obiwanjacobi/Zalt/Design/Images/Zalt CPU Board.jpg

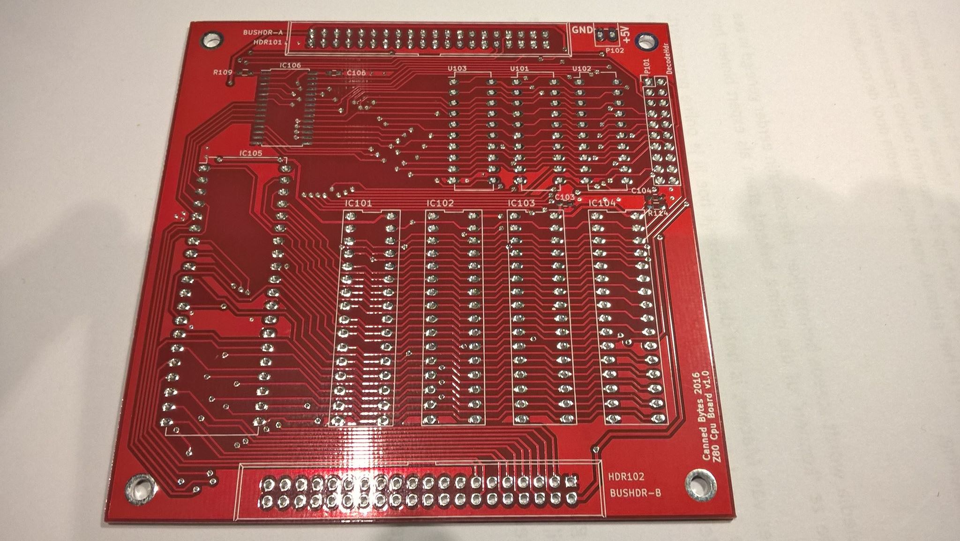
Design/Images/Zalt CPU Board.jpg
