obiwanjacobi/Zalt/Design/Images/building up.jpg

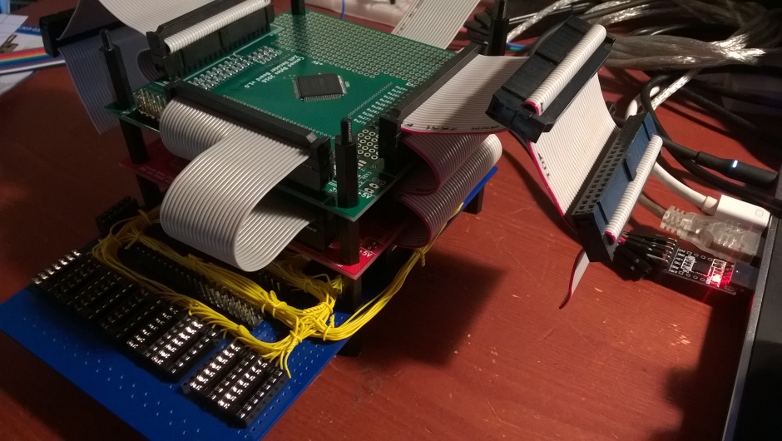
Design/Images/building up.jpg
