obiwanjacobi/Zalt/Source/CharacterVga/readme.md

# Character VGA

Based on a tutorial by 'MiguelVP'
http://www.eevblog.com/forum/projects/no-bitbanging-necessary-or-how-to-drive-a-vga-monitor-on-a-psoc-5lp-programmabl/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

This PSoC project attemps to create a 80x30 character VGA output device.
