obiwanjacobi/Zalt/Design/Additional Documents.md

# Additional Documentation

## My Blog

https://jacobielectronix.wordpress.com/category/zalt

## EEVBlog Forum Posts

Early Memory Layout Design ideas

http://www.eevblog.com/forum/microcontrollers/retro-z80-project-memory-layout-and-software-management/msg819707/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

Early Stream Design ideas

http://www.eevblog.com/forum/microcontrollers/software-ideas-for-fast-streaming-of-disk-data-in-retro-z80-design/msg931695/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

Zalt goes Open Source

http://www.eevblog.com/forum/projects/zalt-an-alternative-z80-homebrew-computer/msg1046143/#msg1046143

GPU Design

http://www.eevblog.com/forum/microcontrollers/early-design-review-mcu-with-quad-spi-and-external-memory-interface/msg1124763/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

PCB Layout posts

http://www.eevblog.com/forum/eda/painted-myself-into-a-corner-any-tips/msg901849/#msg901849

http://www.eevblog.com/forum/kicad/multi-board-project/msg900472/#msg900472

http://www.eevblog.com/forum/eda/favour-more-vias-or-longer-traces-on-other-side/msg890090/#msg890090

## Zalt Memory Management

(different than the .doc file)

https://docs.google.com/document/d/1tF7p2I6861tk6l0KzyiMkYkhx_dNrJLCjcLoVhHxSHA/edit?usp=sharing
