obiwanjacobi/Zalt/Design/BusSpy.docx

Printout for display digits:

A0-3 | A4-7 | A8-11 | | A12-15 | | M12-15 | M16-19 | | D0-3 | D4-7
RST HALT | MEMRQ IORQ | RD WR | | M1 WAIT | | BUSRQ BUSACK

Power Supply

+ => 5V

- => GND

SysTerminal (UART)

Tx => 12.5 PSoC

Rx => 12.4 PSoC

(Dev) USB on PSoC used to program and debug PSoC itself.

Debug Modes (flags)

1 => MEM-RD

2 => MEM-WR

3 => INSTRUCTION-RD (M1)

4 => INPUT

5 => OUTPUT

6 => INTERRUPT-ACKNOWLEDGE

Header A (Memory)

1. GND | 2. +5V
3. A0 | 4. A1
5. A2 | 6. A3
7. A4 | 8. A5
9. A6 | 10. A7
11. A8 | 12. A9
13. A10 | 14. A11
15. MA12 | 16. MA13
17. MA14 | 18. MA15
19. MA16 | 20. MA17
21. MA18 | 22. MA19
23. D0 | 24. D1
25. D2 | 26. D3
27. D4 | 28. D5
29. D6 | 30. D7
31. !MEMREQ | 32. !WR
33. !RD | 34. !CPU_WAIT

Header B (IO)

1. GND | 2. +5V
3. !BUSRQ | 4. !BUSACK
5. !CPU_HALT | 6. !CPU_WAIT
7. !CPU_M1 | 8. !REFRESH
9. !MEMREQ | 10. !IOREQ
11. !RD | 12. !WR
13. !CPU_INT | 14. !NMI
15. A12 | 16. A13
17. A14 | 18. A15
19. !CPU_RST | 20. !CPU_CLK

PSoC

RST

+ -

123456

- Tx Rx

-+

HDR B

HDR A

HDR A

HDR B
