obiwanjacobi/Zalt/Design/Diagrams.pptx

IO addresses: A0-A15
Mem addresses: A0-A11 MA-12-MA19 (1MB)

Z80

MA12-MA19

CPU

A0-A15

D0-D7

A12-A15

MMU

IO-ctrl

EPM240

Logic

Bus-ctrl

Enable

RAM

Serial

PSoC5

Sys
Ctrl

A0-A15
MA12-MA19

D0-D7

A0-A15

A0-A11
MA12-MA19

## Slide 2

Network

IO
Device

IO
Ctrl

Dual ported

IO
RAM

Storage

IO
Device

CPU

RAM mapped
into CPU space

Server

Any
Device

## Slide 3

PC

Zalt

USB

Virtual
Device

Virtual
Device

CPU

PSoC

Int / IO

## Slide 4
