obiwanjacobi/Zalt/VDP Board v1.0 - locked/Source/readme.md

# VDP Board 1.0

https://www.msx.org/wiki/Category:Yamaha_V9958

http://primrosebank.net/computers/mtx/techlib/design/V9958-Technical-manual_v1.0.pdf

http://map.grauw.nl/resources/video/yamaha_v9958.pdf
http://map.grauw.nl/articles/vdp_tut.php

## V9958 code

https://github.com/Xeraster/z80computer/blob/master/9958driver.asm
https://github.com/vipoo/yellow-msx-series-for-rc2014/blob/main/apps-rc2014/v9958.asm

## Trouble Shooting

http://rs.gr8bit.ru/Documentation/Issues-on-YJK-colour-model-implemented-in-Yamaha-V9958-VDP-chip.pdf

> You could take the CXA temporarily out of the equation and just use the RGB signals from the VDP directly.
If you don't have an RGB monitor capable of accepting 15kHz video, you can use each component separately as if it were composite video.

## Resources

https://www.msx.org/forum/msx-talk/hardware/v9958-color-bus?page=0
