obiwanjacobi/Zalt/Source/CPM/Version2/readme.md

# CP/M v2.2

- MyCpm22.z80
- MyCpm22-bios.z80
- MyCpm22-bdos.z80
- MyCpm22-ccp.z80

## Resources

https://obsolescence.wixsite.com/obsolescence/cpm-internals
http://cpuville.com/Code/CPM-on-a-new-computer.html

http://www.cpm.z80.de/
http://www.cpm.z80.de/source.html

Sources used: http://www.cpm.z80.de/download/cpm2-asm.zip

http://www.gaby.de/ecpm.htm

http://www.cpm.z80.de/randyfiles/DRI/CPM_2_0_Interface_Guide.pdf
https://savedparadigms.files.wordpress.com/2014/05/dri-cpm_2-2_alteration_guide_1979.pdf
