obiwanjacobi/Zalt/Design/Diagrams.png

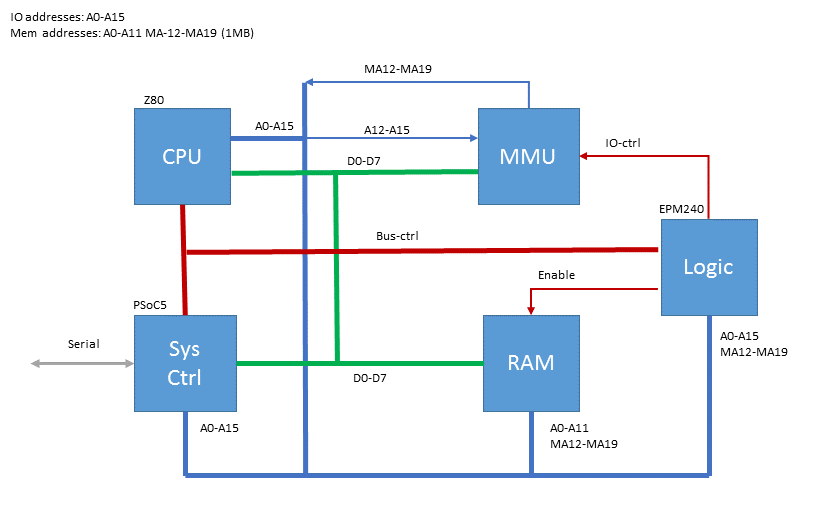
Design/Diagrams.png
