obiwanjacobi/Zalt/Design/Images/humble beginnings.jpg

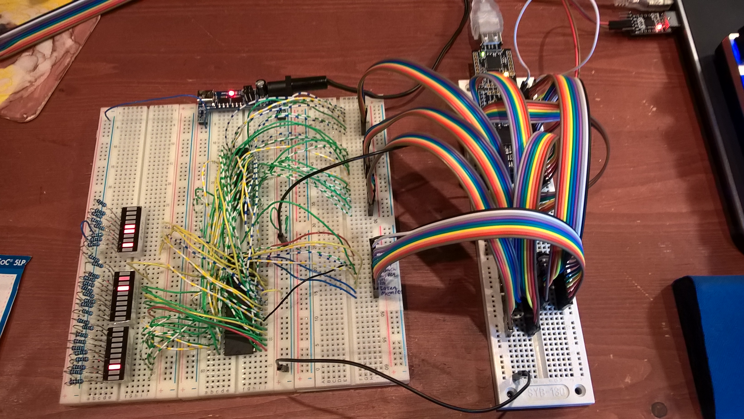
Design/Images/humble beginnings.jpg
