obiwanjacobi/Zalt/Design/Images/Zalt Bus Spy Board.jpg

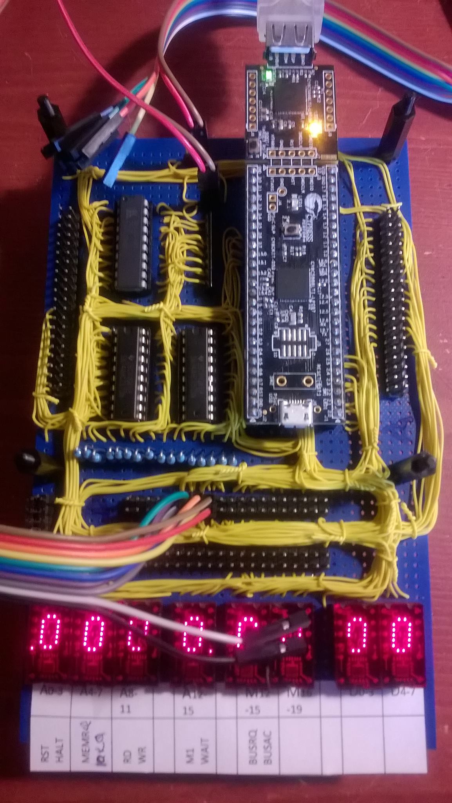
Design/Images/Zalt Bus Spy Board.jpg
