obiwanjacobi/Zalt/Design/Images/Zalt CPU board populated 2.jpg

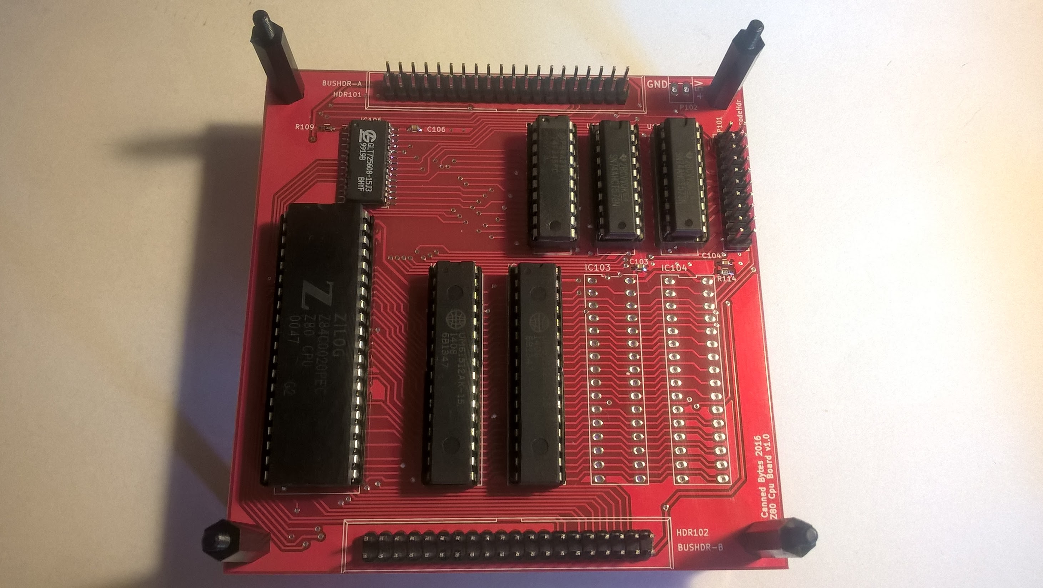
Design/Images/Zalt CPU board populated 2.jpg
