obiwanjacobi/Zalt/Design/Images/Zalt CPU board populated.jpg

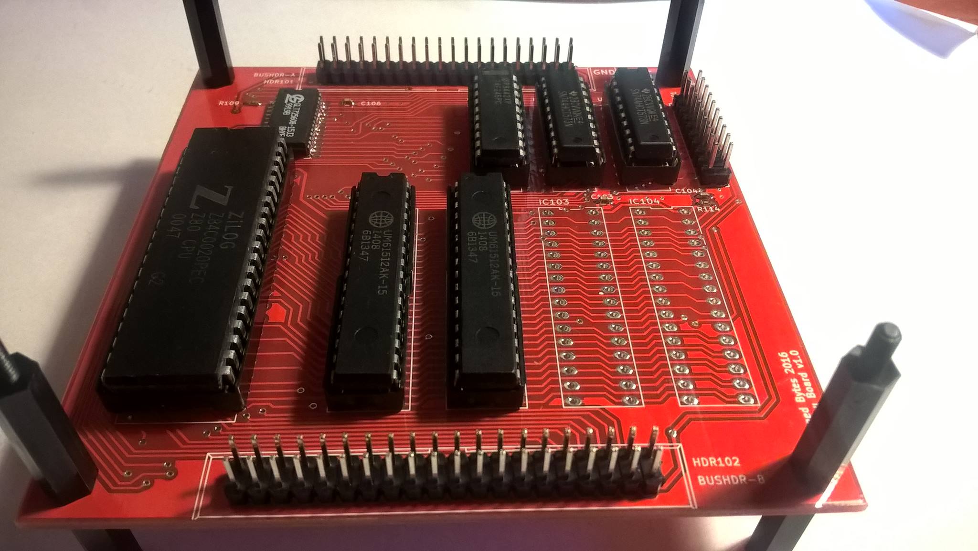
Design/Images/Zalt CPU board populated.jpg
