obiwanjacobi/Zalt/Design/Images/Zalt Logic Board bottom.jpg

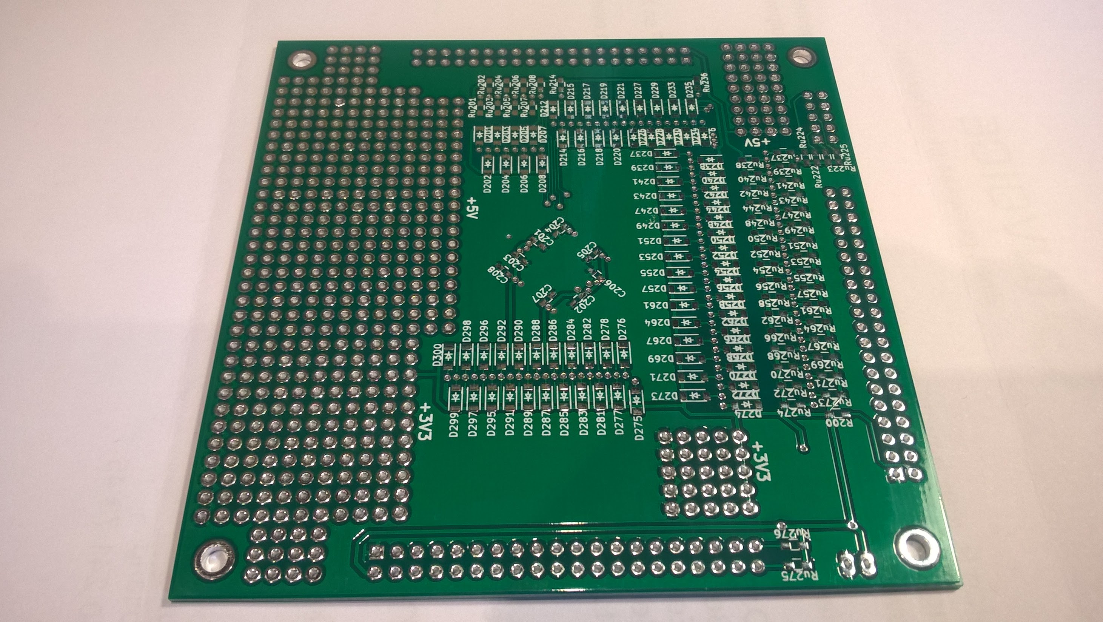
Design/Images/Zalt Logic Board bottom.jpg
