obiwanjacobi/Zalt/Design/Images/Zalt Logic Board top.jpg

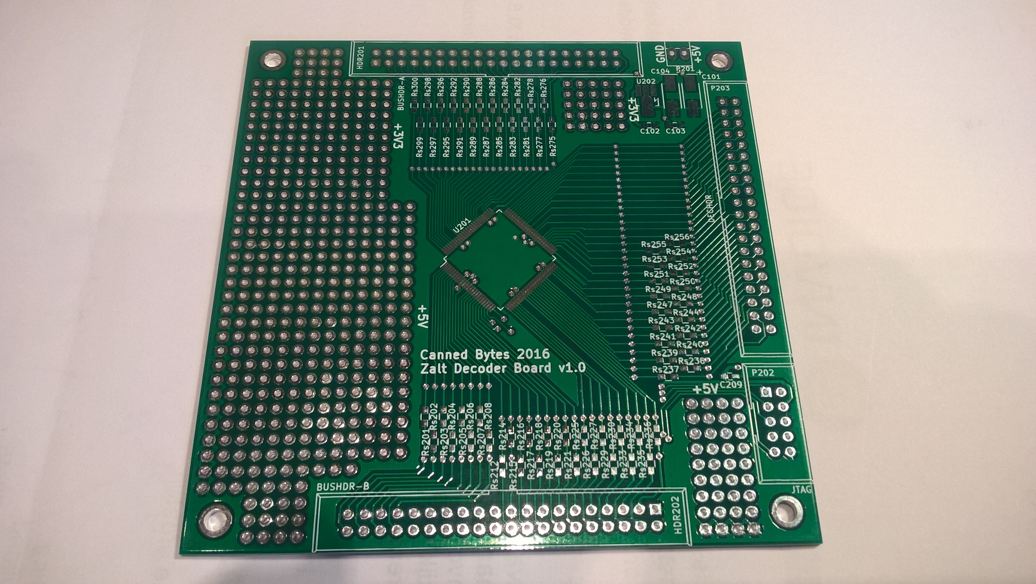
Design/Images/Zalt Logic Board top.jpg
