obiwanjacobi/Zalt/Design/Images/ZaltVgaInterface1.jpg

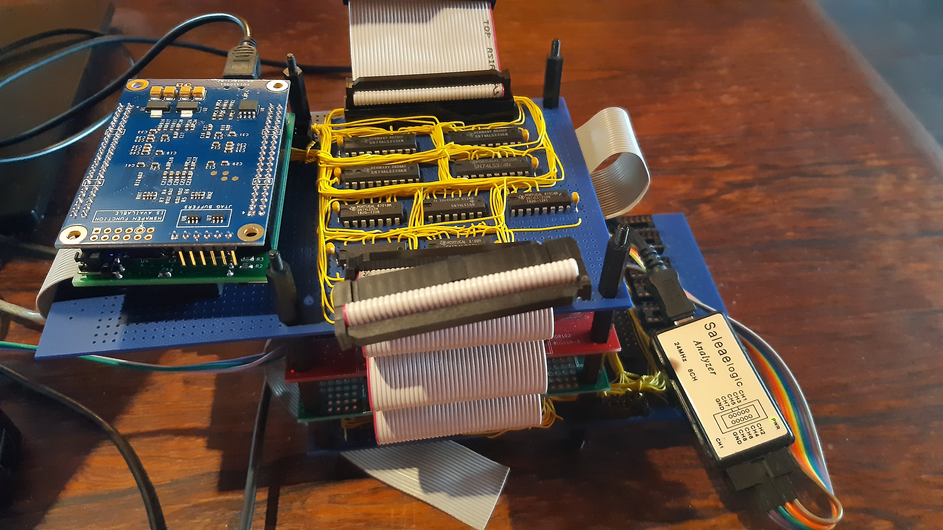
Design/Images/ZaltVgaInterface1.jpg
