obiwanjacobi/Zalt/Design/IO Bus.png

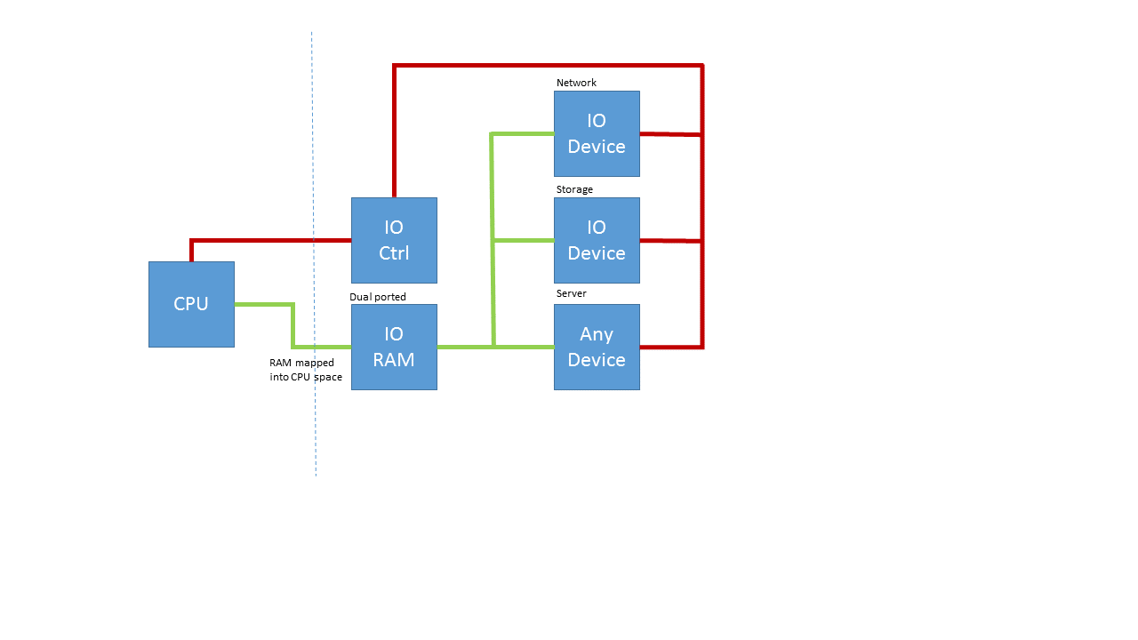
Design/IO Bus.png
