obiwanjacobi/Zalt/Design/Timings/DMA Bus timing.png

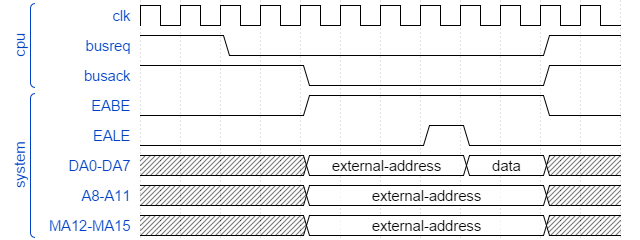
Design/Timings/DMA Bus timing.png
