obiwanjacobi/Zalt/Design/Timings/Z80 Bus Request-Acknowledge Cycle.png

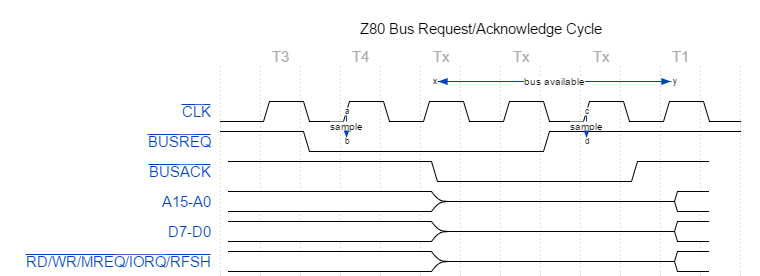
Design/Timings/Z80 Bus Request-Acknowledge Cycle.png
