obiwanjacobi/Zalt/Design/Virtual Devices.png

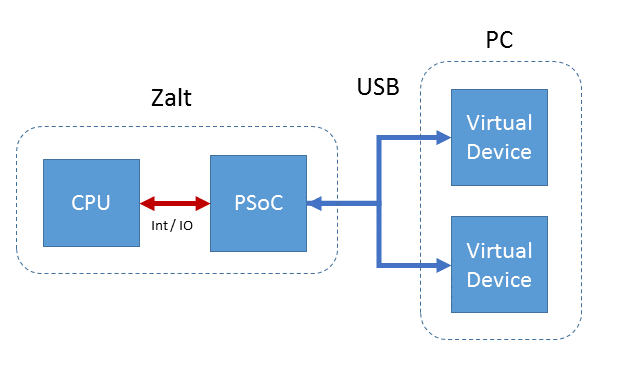
Design/Virtual Devices.png
