obiwanjacobi/Zalt/VDP Board v1.0 - locked/VDP-Composite-PCB-Back-3D.png

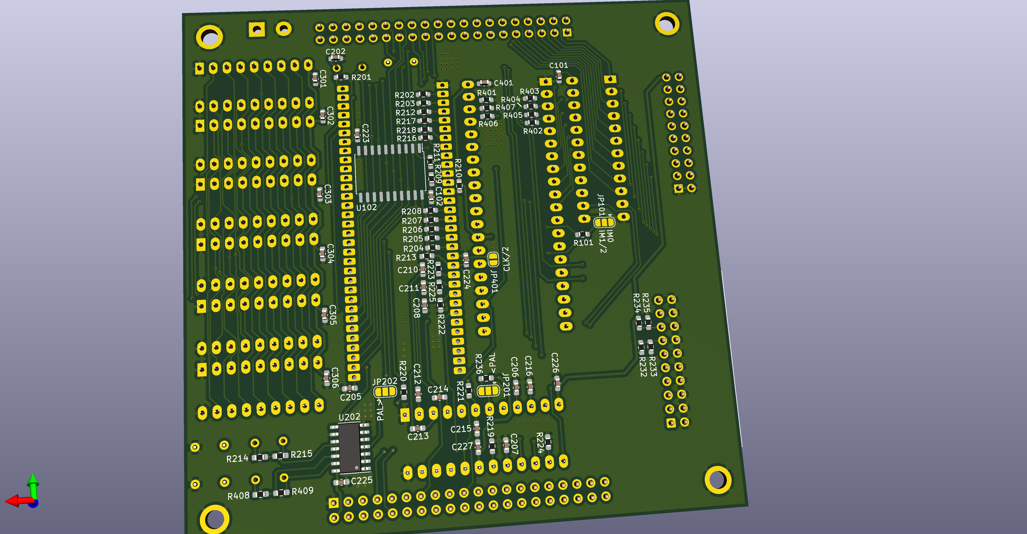
VDP Board v1.0 - locked/VDP-Composite-PCB-Back-3D.png
