obiwanjacobi/Zalt/VDP Board v1.0 - locked/VDP-Composite-PCB-Front-3D.png

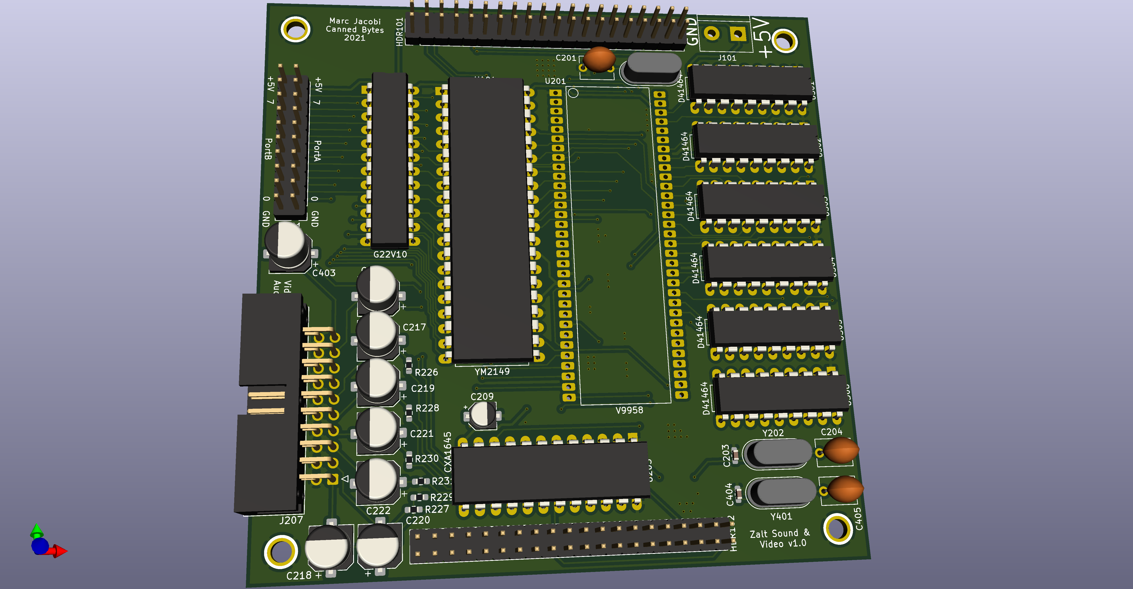
VDP Board v1.0 - locked/VDP-Composite-PCB-Front-3D.png
