obiwanjacobi/Zalt/Source/SystemController/ComponentUpdateLog.txt

Last Modified Date & Time: 02/07/2016 12:24:34

SystemController: TopDesign.cysch
	TxSysTerminal [v2.20] to [v2.20]
	RxSysTerminal [v2.20] to [v2.20]
	LsbA [v2.20] to [v2.20]
	MsbA [v2.20] to [v2.20]
	D [v2.20] to [v2.20]
	ExtBus [v2.20] to [v2.20]

SystemController: SystemController.cydwr
	cy_boot [v5.20] to [v5.30]
	LIN_Dynamic [v3.20] to [v3.30]

Last Modified Date & Time: 05/22/2016 10:04:30

SystemController: SystemController.cydwr
	cy_boot [v5.30] to [v5.40]
	LIN_Dynamic [v3.30] to [v3.40]

Last Modified Date & Time: 12/30/2016 10:41:40

SystemController: SystemController.cydwr
	cy_boot [v5.40] to [v5.50]

Last Modified Date & Time: 12/23/2018 07:55:23

SystemController: ScratchPad.cysch
	Timer [v2.70] to [v2.80]
	USB [v3.10] to [v3.20]

SystemController: SystemController.cydwr
	cy_boot [v5.50] to [v5.80]
	Em_EEPROM_Dynamic [v2.0] to [v2.20]
	LIN_Dynamic [v3.40] to [v4.0]

Last Modified Date & Time: 01/29/2020 11:44:56

SystemController: OldDesign.cysch
	Timer [v2.70] to [v2.80]

SystemController: SystemController.cydwr
	LIN_Dynamic [v4.0] to [v5.0]

Last Modified Date & Time: 03/22/2020 11:42:34

SystemController: SystemController.cydwr
	cy_boot [v5.80] to [v5.90]

Last Modified Date & Time: 12/27/2020 19:44:29

SystemController: SystemController.cydwr
	cy_boot [v5.90] to [v6.0]
