obiwanjacobi/Zalt/Source/CharacterVga/ComponentUpdateLog.txt

Last Modified Date & Time: 05/04/2019 17:28:17

CharacterVga: TopDesign.cysch
	VideoController [v1.0] to [v1.1]

Last Modified Date & Time: 05/04/2019 17:31:20

CharacterVga: TopDesign.cysch
	VideoController [v1.1] to [v1.0]

Last Modified Date & Time: 05/04/2019 17:42:42

CharacterVga: TopDesign.cysch
	VideoController [v1.0] to [v1.1]

Last Modified Date & Time: 05/04/2019 17:44:52

CharacterVga: TopDesign.cysch
	VideoController [v1.1] to [v1.0]
