obiwanjacobi/Zalt/(list of files, cad)

Other CAD files:
Under Construction/FPGA VGA v0.1/work/controller/rtl.psm
Under Construction/FPGA VGA v0.1/work/g_register/synth.psm
