obiwanjacobi/Zalt/Under Construction/ZaltToISA/readme.md

What does it take to connect Zalt to an ISA bus, 8-bits or 16-bits?
