obiwanjacobi/Zalt/Under Construction/ZaltToISA/Source/BusAdapter/IsaBusAdapter/IsaBusAdapter.cydsn/IsaBusAdapter_timing.html

# Static Timing Analysis

Project : | IsaBusAdapter
Build Time : | 03/25/19 17:50:43
Device : | CY8C5888LTI-LP097
Temperature : | 0C - 85/125C
VDDA : | 5.00
VDDABUF : | 5.00
VDDD : | 5.00
VDDIO0 : | 5.00
VDDIO1 : | 5.00
VDDIO2 : | 5.00
VDDIO3 : | 5.00
VUSB : | 5.00
Voltage : | 5.0

Expand All | Collapse All | Show All Paths | Hide All Paths

+ Timing Violation Section

No Timing Violations

+ Clock Summary Section

Clock | Domain | Nominal Frequency | Required Frequency | Maximum Frequency | Violation
CyILO | CyILO | 1.000 kHz | 1.000 kHz | 58.696 MHz
CyIMO | CyIMO | 3.000 MHz | 3.000 MHz | N/A
CyMASTER_CLK | CyMASTER_CLK | 24.000 MHz | 24.000 MHz | N/A
CyBUS_CLK | CyMASTER_CLK | 24.000 MHz | 24.000 MHz | N/A
CyPLL_OUT | CyPLL_OUT | 24.000 MHz | 24.000 MHz | N/A

+ Register to Register Section

+ Setup Subsection

+ Source Clock : CyILO : Positive edge(Required Frequency 1 kHz)

+ Destination Clock : CyILO : Positive edge(Required Frequency 1 kHz)

Path Delay Requirement : 1e+006ns(1 kHz)

Source | Destination | FMax | Delay (ns) | Slack (ns) | Violation
\FreqDiv_1:count_9\/q | Net_181/main_3 | 58.696 MHz | 17.037 | 999982.963

Type | Location | Fanout | Instance/Net | Source | Dest | Delay (ns)
macrocell8 | U(1,5) | 1 | \FreqDiv_1:count_9\ | \FreqDiv_1:count_9\/clock_0 | \FreqDiv_1:count_9\/q | 0.875
Route | | 1 | \FreqDiv_1:count_9\ | \FreqDiv_1:count_9\/q | Net_181_split/main_1 | 4.837
macrocell1 | U(1,5) | 1 | Net_181_split | Net_181_split/main_1 | Net_181_split/q | 2.345
Route | | 1 | Net_181_split | Net_181_split/q | Net_181_split_1/main_11 | 2.091
macrocell4 | U(0,5) | 1 | Net_181_split_1 | Net_181_split_1/main_11 | Net_181_split_1/q | 2.345
Route | | 1 | Net_181_split_1 | Net_181_split_1/q | Net_181/main_3 | 2.087
macrocell6 | U(1,5) | 1 | Net_181 | | SETUP | 2.457
Clock | | | | | Skew | 0.000
\FreqDiv_1:not_last_reset\/q | Net_181/main_3 | 65.677 MHz | 15.226 | 999984.774

Type | Location | Fanout | Instance/Net | Source | Dest | Delay (ns)
macrocell7 | U(1,5) | 1 | \FreqDiv_1:not_last_reset\ | \FreqDiv_1:not_last_reset\/clock_0 | \FreqDiv_1:not_last_reset\/q | 0.875
Route | | 1 | \FreqDiv_1:not_last_reset\ | \FreqDiv_1:not_last_reset\/q | Net_181_split/main_0 | 3.026
macrocell1 | U(1,5) | 1 | Net_181_split | Net_181_split/main_0 | Net_181_split/q | 2.345
Route | | 1 | Net_181_split | Net_181_split/q | Net_181_split_1/main_11 | 2.091
macrocell4 | U(0,5) | 1 | Net_181_split_1 | Net_181_split_1/main_11 | Net_181_split_1/q | 2.345
Route | | 1 | Net_181_split_1 | Net_181_split_1/q | Net_181/main_3 | 2.087
macrocell6 | U(1,5) | 1 | Net_181 | | SETUP | 2.457
Clock | | | | | Skew | 0.000
\FreqDiv_1:count_9\/q | Net_181/main_4 | 70.721 MHz | 14.140 | 999985.860

Type | Location | Fanout | Instance/Net | Source | Dest | Delay (ns)
macrocell8 | U(1,5) | 1 | \FreqDiv_1:count_9\ | \FreqDiv_1:count_9\/clock_0 | \FreqDiv_1:count_9\/q | 0.875
Route | | 1 | \FreqDiv_1:count_9\ | \FreqDiv_1:count_9\/q | Net_181_split_2/main_2 | 6.381
macrocell3 | U(0,5) | 1 | Net_181_split_2 | Net_181_split_2/main_2 | Net_181_split_2/q | 2.345
Route | | 1 | Net_181_split_2 | Net_181_split_2/q | Net_181/main_4 | 2.082
macrocell6 | U(1,5) | 1 | Net_181 | | SETUP | 2.457
Clock | | | | | Skew | 0.000
\FreqDiv_1:count_9\/q | \FreqDiv_1:count_8\/main_3 | 74.845 MHz | 13.361 | 999986.639

Type | Location | Fanout | Instance/Net | Source | Dest | Delay (ns)
macrocell8 | U(1,5) | 1 | \FreqDiv_1:count_9\ | \FreqDiv_1:count_9\/clock_0 | \FreqDiv_1:count_9\/q | 0.875
Route | | 1 | \FreqDiv_1:count_9\ | \FreqDiv_1:count_9\/q | \FreqDiv_1:count_8_split\/main_2 | 4.658
macrocell2 | U(0,4) | 1 | \FreqDiv_1:count_8_split\ | \FreqDiv_1:count_8_split\/main_2 | \FreqDiv_1:count_8_split\/q | 2.345
Route | | 1 | \FreqDiv_1:count_8_split\ | \FreqDiv_1:count_8_split\/q | \FreqDiv_1:count_8\/main_3 | 2.098
macrocell9 | U(1,4) | 1 | \FreqDiv_1:count_8\ | | SETUP | 2.457
Clock | | | | | Skew | 0.928
\FreqDiv_1:count_9\/q | \FreqDiv_1:count_9\/main_4 | 74.985 MHz | 13.336 | 999986.664

Type | Location | Fanout | Instance/Net | Source | Dest | Delay (ns)
macrocell8 | U(1,5) | 1 | \FreqDiv_1:count_9\ | \FreqDiv_1:count_9\/clock_0 | \FreqDiv_1:count_9\/q | 0.875
Route | | 1 | \FreqDiv_1:count_9\ | \FreqDiv_1:count_9\/q | \FreqDiv_1:count_8_split\/main_2 | 4.658
macrocell2 | U(0,4) | 1 | \FreqDiv_1:count_8_split\ | \FreqDiv_1:count_8_split\/main_2 | \FreqDiv_1:count_8_split\/q | 2.345
Route | | 1 | \FreqDiv_1:count_8_split\ | \FreqDiv_1:count_8_split\/q | \FreqDiv_1:count_9\/main_4 | 3.001
macrocell8 | U(1,5) | 1 | \FreqDiv_1:count_9\ | | SETUP | 2.457
Clock | | | | | Skew | 0.000
\FreqDiv_1:count_2\/q | \FreqDiv_1:count_8\/main_3 | 79.643 MHz | 12.556 | 999987.444

Type | Location | Fanout | Instance/Net | Source | Dest | Delay (ns)
macrocell15 | U(1,5) | 1 | \FreqDiv_1:count_2\ | \FreqDiv_1:count_2\/clock_0 | \FreqDiv_1:count_2\/q | 0.875
Route | | 1 | \FreqDiv_1:count_2\ | \FreqDiv_1:count_2\/q | \FreqDiv_1:count_8_split\/main_9 | 3.853
macrocell2 | U(0,4) | 1 | \FreqDiv_1:count_8_split\ | \FreqDiv_1:count_8_split\/main_9 | \FreqDiv_1:count_8_split\/q | 2.345
Route | | 1 | \FreqDiv_1:count_8_split\ | \FreqDiv_1:count_8_split\/q | \FreqDiv_1:count_8\/main_3 | 2.098
macrocell9 | U(1,4) | 1 | \FreqDiv_1:count_8\ | | SETUP | 2.457
Clock | | | | | Skew | 0.928
\FreqDiv_1:count_2\/q | \FreqDiv_1:count_8\/main_2 | 79.764 MHz | 12.537 | 999987.463

Type | Location | Fanout | Instance/Net | Source | Dest | Delay (ns)
macrocell15 | U(1,5) | 1 | \FreqDiv_1:count_2\ | \FreqDiv_1:count_2\/clock_0 | \FreqDiv_1:count_2\/q | 0.875
Route | | 1 | \FreqDiv_1:count_2\ | \FreqDiv_1:count_2\/q | \FreqDiv_1:MODULE_1:g2:a0:g1:z1:s0:g1:u0:b_8\/main_5 | 3.844
macrocell5 | U(0,4) | 1 | \FreqDiv_1:MODULE_1:g2:a0:g1:z1:s0:g1:u0:b_8\ | \FreqDiv_1:MODULE_1:g2:a0:g1:z1:s0:g1:u0:b_8\/main_5 | \FreqDiv_1:MODULE_1:g2:a0:g1:z1:s0:g1:u0:b_8\/q | 2.345
Route | | 1 | \FreqDiv_1:MODULE_1:g2:a0:g1:z1:s0:g1:u0:b_8\ | \FreqDiv_1:MODULE_1:g2:a0:g1:z1:s0:g1:u0:b_8\/q | \FreqDiv_1:count_8\/main_2 | 2.088
macrocell9 | U(1,4) | 1 | \FreqDiv_1:count_8\ | | SETUP | 2.457
Clock | | | | | Skew | 0.928
\FreqDiv_1:count_2\/q | \FreqDiv_1:count_9\/main_4 | 79.802 MHz | 12.531 | 999987.469

Type | Location | Fanout | Instance/Net | Source | Dest | Delay (ns)
macrocell15 | U(1,5) | 1 | \FreqDiv_1:count_2\ | \FreqDiv_1:count_2\/clock_0 | \FreqDiv_1:count_2\/q | 0.875
Route | | 1 | \FreqDiv_1:count_2\ | \FreqDiv_1:count_2\/q | \FreqDiv_1:count_8_split\/main_9 | 3.853
macrocell2 | U(0,4) | 1 | \FreqDiv_1:count_8_split\ | \FreqDiv_1:count_8_split\/main_9 | \FreqDiv_1:count_8_split\/q | 2.345
Route | | 1 | \FreqDiv_1:count_8_split\ | \FreqDiv_1:count_8_split\/q | \FreqDiv_1:count_9\/main_4 | 3.001
macrocell8 | U(1,5) | 1 | \FreqDiv_1:count_9\ | | SETUP | 2.457
Clock | | | | | Skew | 0.000
\FreqDiv_1:count_0\/q | \FreqDiv_1:count_8\/main_3 | 79.840 MHz | 12.525 | 999987.475

Type | Location | Fanout | Instance/Net | Source | Dest | Delay (ns)
macrocell17 | U(1,5) | 1 | \FreqDiv_1:count_0\ | \FreqDiv_1:count_0\/clock_0 | \FreqDiv_1:count_0\/q | 0.875
Route | | 1 | \FreqDiv_1:count_0\ | \FreqDiv_1:count_0\/q | \FreqDiv_1:count_8_split\/main_11 | 3.822
macrocell2 | U(0,4) | 1 | \FreqDiv_1:count_8_split\ | \FreqDiv_1:count_8_split\/main_11 | \FreqDiv_1:count_8_split\/q | 2.345
Route | | 1 | \FreqDiv_1:count_8_split\ | \FreqDiv_1:count_8_split\/q | \FreqDiv_1:count_8\/main_3 | 2.098
macrocell9 | U(1,4) | 1 | \FreqDiv_1:count_8\ | | SETUP | 2.457
Clock | | | | | Skew | 0.928
\FreqDiv_1:count_2\/q | \FreqDiv_1:count_9\/main_3 | 79.930 MHz | 12.511 | 999987.489

Type | Location | Fanout | Instance/Net | Source | Dest | Delay (ns)
macrocell15 | U(1,5) | 1 | \FreqDiv_1:count_2\ | \FreqDiv_1:count_2\/clock_0 | \FreqDiv_1:count_2\/q | 0.875
Route | | 1 | \FreqDiv_1:count_2\ | \FreqDiv_1:count_2\/q | \FreqDiv_1:MODULE_1:g2:a0:g1:z1:s0:g1:u0:b_8\/main_5 | 3.844
macrocell5 | U(0,4) | 1 | \FreqDiv_1:MODULE_1:g2:a0:g1:z1:s0:g1:u0:b_8\ | \FreqDiv_1:MODULE_1:g2:a0:g1:z1:s0:g1:u0:b_8\/main_5 | \FreqDiv_1:MODULE_1:g2:a0:g1:z1:s0:g1:u0:b_8\/q | 2.345
Route | | 1 | \FreqDiv_1:MODULE_1:g2:a0:g1:z1:s0:g1:u0:b_8\ | \FreqDiv_1:MODULE_1:g2:a0:g1:z1:s0:g1:u0:b_8\/q | \FreqDiv_1:count_9\/main_3 | 2.990
macrocell8 | U(1,5) | 1 | \FreqDiv_1:count_9\ | | SETUP | 2.457
Clock | | | | | Skew | 0.000

+ Hold Subsection

+ Source Clock : CyILO : Positive edge

+ Destination Clock : CyILO : Positive edge

Source | Destination | Slack (ns) | Violation
\FreqDiv_1:count_4\/q | \FreqDiv_1:count_7\/main_7 | 3.265

Type | Location | Fanout | Instance/Net | Source | Dest | Delay (ns)
macrocell13 | U(0,4) | 1 | \FreqDiv_1:count_4\ | \FreqDiv_1:count_4\/clock_0 | \FreqDiv_1:count_4\/q | 0.875
Route | | 1 | \FreqDiv_1:count_4\ | \FreqDiv_1:count_4\/q | \FreqDiv_1:count_7\/main_7 | 2.390
macrocell10 | U(0,4) | 1 | \FreqDiv_1:count_7\ | | HOLD | 0.000
Clock | | | | | Skew | 0.000
\FreqDiv_1:count_4\/q | \FreqDiv_1:count_6\/main_7 | 3.265

Type | Location | Fanout | Instance/Net | Source | Dest | Delay (ns)
macrocell13 | U(0,4) | 1 | \FreqDiv_1:count_4\ | \FreqDiv_1:count_4\/clock_0 | \FreqDiv_1:count_4\/q | 0.875
Route | | 1 | \FreqDiv_1:count_4\ | \FreqDiv_1:count_4\/q | \FreqDiv_1:count_6\/main_7 | 2.390
macrocell11 | U(0,4) | 1 | \FreqDiv_1:count_6\ | | HOLD | 0.000
Clock | | | | | Skew | 0.000
\FreqDiv_1:count_4\/q | \FreqDiv_1:count_5\/main_7 | 3.265

Type | Location | Fanout | Instance/Net | Source | Dest | Delay (ns)
macrocell13 | U(0,4) | 1 | \FreqDiv_1:count_4\ | \FreqDiv_1:count_4\/clock_0 | \FreqDiv_1:count_4\/q | 0.875
Route | | 1 | \FreqDiv_1:count_4\ | \FreqDiv_1:count_4\/q | \FreqDiv_1:count_5\/main_7 | 2.390
macrocell12 | U(0,4) | 1 | \FreqDiv_1:count_5\ | | HOLD | 0.000
Clock | | | | | Skew | 0.000
\FreqDiv_1:count_4\/q | \FreqDiv_1:count_3\/main_7 | 3.266

Type | Location | Fanout | Instance/Net | Source | Dest | Delay (ns)
macrocell13 | U(0,4) | 1 | \FreqDiv_1:count_4\ | \FreqDiv_1:count_4\/clock_0 | \FreqDiv_1:count_4\/q | 0.875
Route | | 1 | \FreqDiv_1:count_4\ | \FreqDiv_1:count_4\/q | \FreqDiv_1:count_3\/main_7 | 2.391
macrocell14 | U(0,4) | 1 | \FreqDiv_1:count_3\ | | HOLD | 0.000
Clock | | | | | Skew | 0.000
\FreqDiv_1:count_8\/q | \FreqDiv_1:count_7\/main_3 | 3.435

Type | Location | Fanout | Instance/Net | Source | Dest | Delay (ns)
macrocell9 | U(1,4) | 1 | \FreqDiv_1:count_8\ | \FreqDiv_1:count_8\/clock_0 | \FreqDiv_1:count_8\/q | 0.875
Route | | 1 | \FreqDiv_1:count_8\ | \FreqDiv_1:count_8\/q | \FreqDiv_1:count_7\/main_3 | 2.559
macrocell10 | U(0,4) | 1 | \FreqDiv_1:count_7\ | | HOLD | 0.000
Clock | | | | | Skew | 0.001
\FreqDiv_1:count_8\/q | \FreqDiv_1:count_6\/main_3 | 3.435

Type | Location | Fanout | Instance/Net | Source | Dest | Delay (ns)
macrocell9 | U(1,4) | 1 | \FreqDiv_1:count_8\ | \FreqDiv_1:count_8\/clock_0 | \FreqDiv_1:count_8\/q | 0.875
Route | | 1 | \FreqDiv_1:count_8\ | \FreqDiv_1:count_8\/q | \FreqDiv_1:count_6\/main_3 | 2.559
macrocell11 | U(0,4) | 1 | \FreqDiv_1:count_6\ | | HOLD | 0.000
Clock | | | | | Skew | 0.001
\FreqDiv_1:count_8\/q | \FreqDiv_1:count_5\/main_3 | 3.435

Type | Location | Fanout | Instance/Net | Source | Dest | Delay (ns)
macrocell9 | U(1,4) | 1 | \FreqDiv_1:count_8\ | \FreqDiv_1:count_8\/clock_0 | \FreqDiv_1:count_8\/q | 0.875
Route | | 1 | \FreqDiv_1:count_8\ | \FreqDiv_1:count_8\/q | \FreqDiv_1:count_5\/main_3 | 2.559
macrocell12 | U(0,4) | 1 | \FreqDiv_1:count_5\ | | HOLD | 0.000
Clock | | | | | Skew | 0.001
\FreqDiv_1:count_1\/q | \FreqDiv_1:count_4\/main_4 | 3.436

Type | Location | Fanout | Instance/Net | Source | Dest | Delay (ns)
macrocell16 | U(1,4) | 1 | \FreqDiv_1:count_1\ | \FreqDiv_1:count_1\/clock_0 | \FreqDiv_1:count_1\/q | 0.875
Route | | 1 | \FreqDiv_1:count_1\ | \FreqDiv_1:count_1\/q | \FreqDiv_1:count_4\/main_4 | 2.560
macrocell13 | U(0,4) | 1 | \FreqDiv_1:count_4\ | | HOLD | 0.000
Clock | | | | | Skew | 0.001
\FreqDiv_1:count_1\/q | \FreqDiv_1:count_3\/main_10 | 3.436

Type | Location | Fanout | Instance/Net | Source | Dest | Delay (ns)
macrocell16 | U(1,4) | 1 | \FreqDiv_1:count_1\ | \FreqDiv_1:count_1\/clock_0 | \FreqDiv_1:count_1\/q | 0.875
Route | | 1 | \FreqDiv_1:count_1\ | \FreqDiv_1:count_1\/q | \FreqDiv_1:count_3\/main_10 | 2.560
macrocell14 | U(0,4) | 1 | \FreqDiv_1:count_3\ | | HOLD | 0.000
Clock | | | | | Skew | 0.001
\FreqDiv_1:count_6\/q | \FreqDiv_1:count_3\/main_5 | 3.446

Type | Location | Fanout | Instance/Net | Source | Dest | Delay (ns)
macrocell11 | U(0,4) | 1 | \FreqDiv_1:count_6\ | \FreqDiv_1:count_6\/clock_0 | \FreqDiv_1:count_6\/q | 0.875
Route | | 1 | \FreqDiv_1:count_6\ | \FreqDiv_1:count_6\/q | \FreqDiv_1:count_3\/main_5 | 2.571
macrocell14 | U(0,4) | 1 | \FreqDiv_1:count_3\ | | HOLD | 0.000
Clock | | | | | Skew | 0.000

+ Input To Clock Section

+ CyILO

Source | Destination | Delay (ns)
Btn(0)_PAD | Net_181/main_3 | 13.446

Type | Location | Fanout | Instance/Net | Source | Dest | Delay (ns)
Route | | 1 | Btn(0)_PAD | Btn(0)_PAD | Btn(0)/pad_in | 0.000
iocell2 | P2[2] | 1 | Btn(0) | Btn(0)/pad_in | Btn(0)/fb | 7.523
Route | | 1 | Net_185 | Btn(0)/fb | Net_181_split_1/main_1 | 7.882
macrocell4 | U(0,5) | 1 | Net_181_split_1 | Net_181_split_1/main_1 | Net_181_split_1/q | 2.345
Route | | 1 | Net_181_split_1 | Net_181_split_1/q | Net_181/main_3 | 2.087
macrocell6 | U(1,5) | 1 | Net_181 | | SETUP | 2.457
Clock | | | | | Clock path delay | -8.848

+ Clock To Output Section

+ CyILO

Source | Destination | Delay (ns)
Net_181/q | LED(0)_PAD | 33.269

Type | Location | Fanout | Instance/Net | Source | Dest | Delay (ns)
macrocell6 | U(1,5) | 1 | Net_181 | Net_181/clock_0 | Net_181/q | 0.875
Route | | 1 | Net_181 | Net_181/q | LED(0)/pin_input | 7.655
iocell1 | P2[1] | 1 | LED(0) | LED(0)/pin_input | LED(0)/pad_out | 15.891
Route | | 1 | LED(0)_PAD | LED(0)/pad_out | LED(0)_PAD | 0.000
Clock | | | | | Clock path delay | 8.848
