obiwanjacobi/Zalt/Under Construction/IDE v0.1/readme.md

# Zalt IDE Controller

IDE Support for Zalt

## Resources

http://www.gaby.de/gide/

http://blog.retroleum.co.uk/electronics-articles/an-8-bit-ide-interface/
