obiwanjacobi/Zalt/Design/Timings/Z80 Instruction Fetch Cycle with Memory Map.png

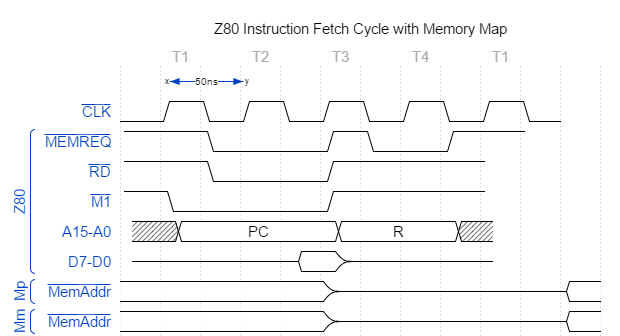
Design/Timings/Z80 Instruction Fetch Cycle with Memory Map.png
