obiwanjacobi/Zalt/Source/Z80 Tests/InstructionTests/Branch/djnz.png

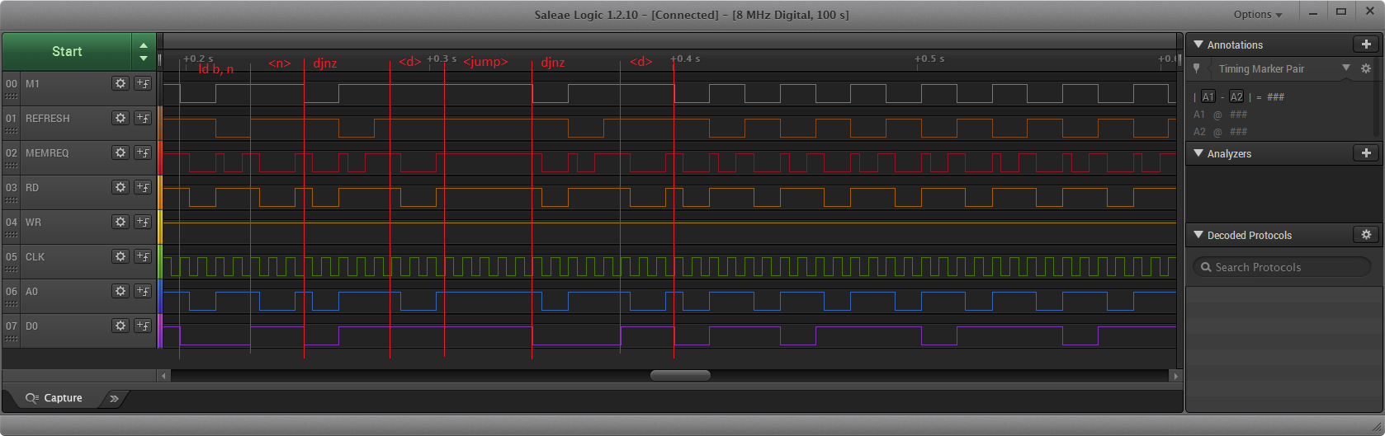
Source/Z80 Tests/InstructionTests/Branch/djnz.png
