obiwanjacobi/Zalt/Source/Z80 Tests/InstructionTests/Load/ld(16)a.png

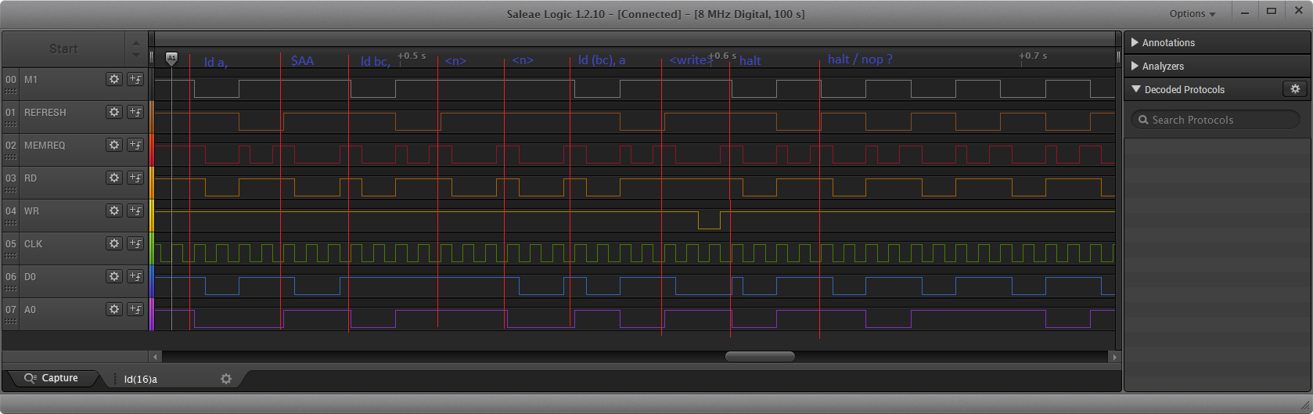
Source/Z80 Tests/InstructionTests/Load/ld(16)a.png
