obiwanjacobi/Zalt/Under Construction/ZaltToISA/Kicad/ZaltToISA.png

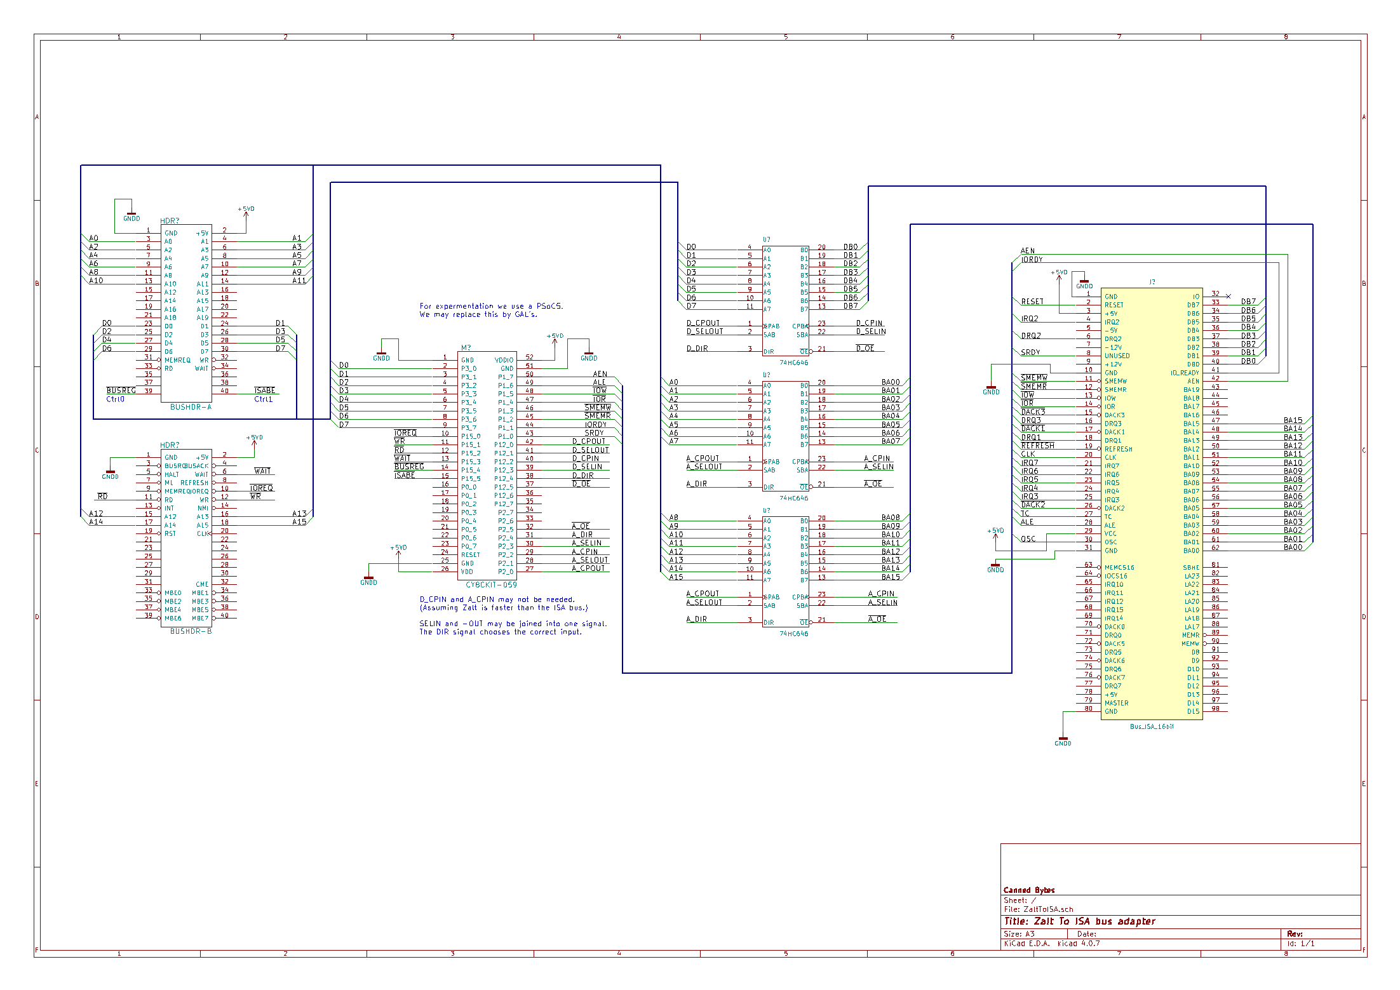
Under Construction/ZaltToISA/Kicad/ZaltToISA.png
