obiwanjacobi/Zalt/CPU Board v1.0 - locked/Z80 CPU Board schematic.pdf

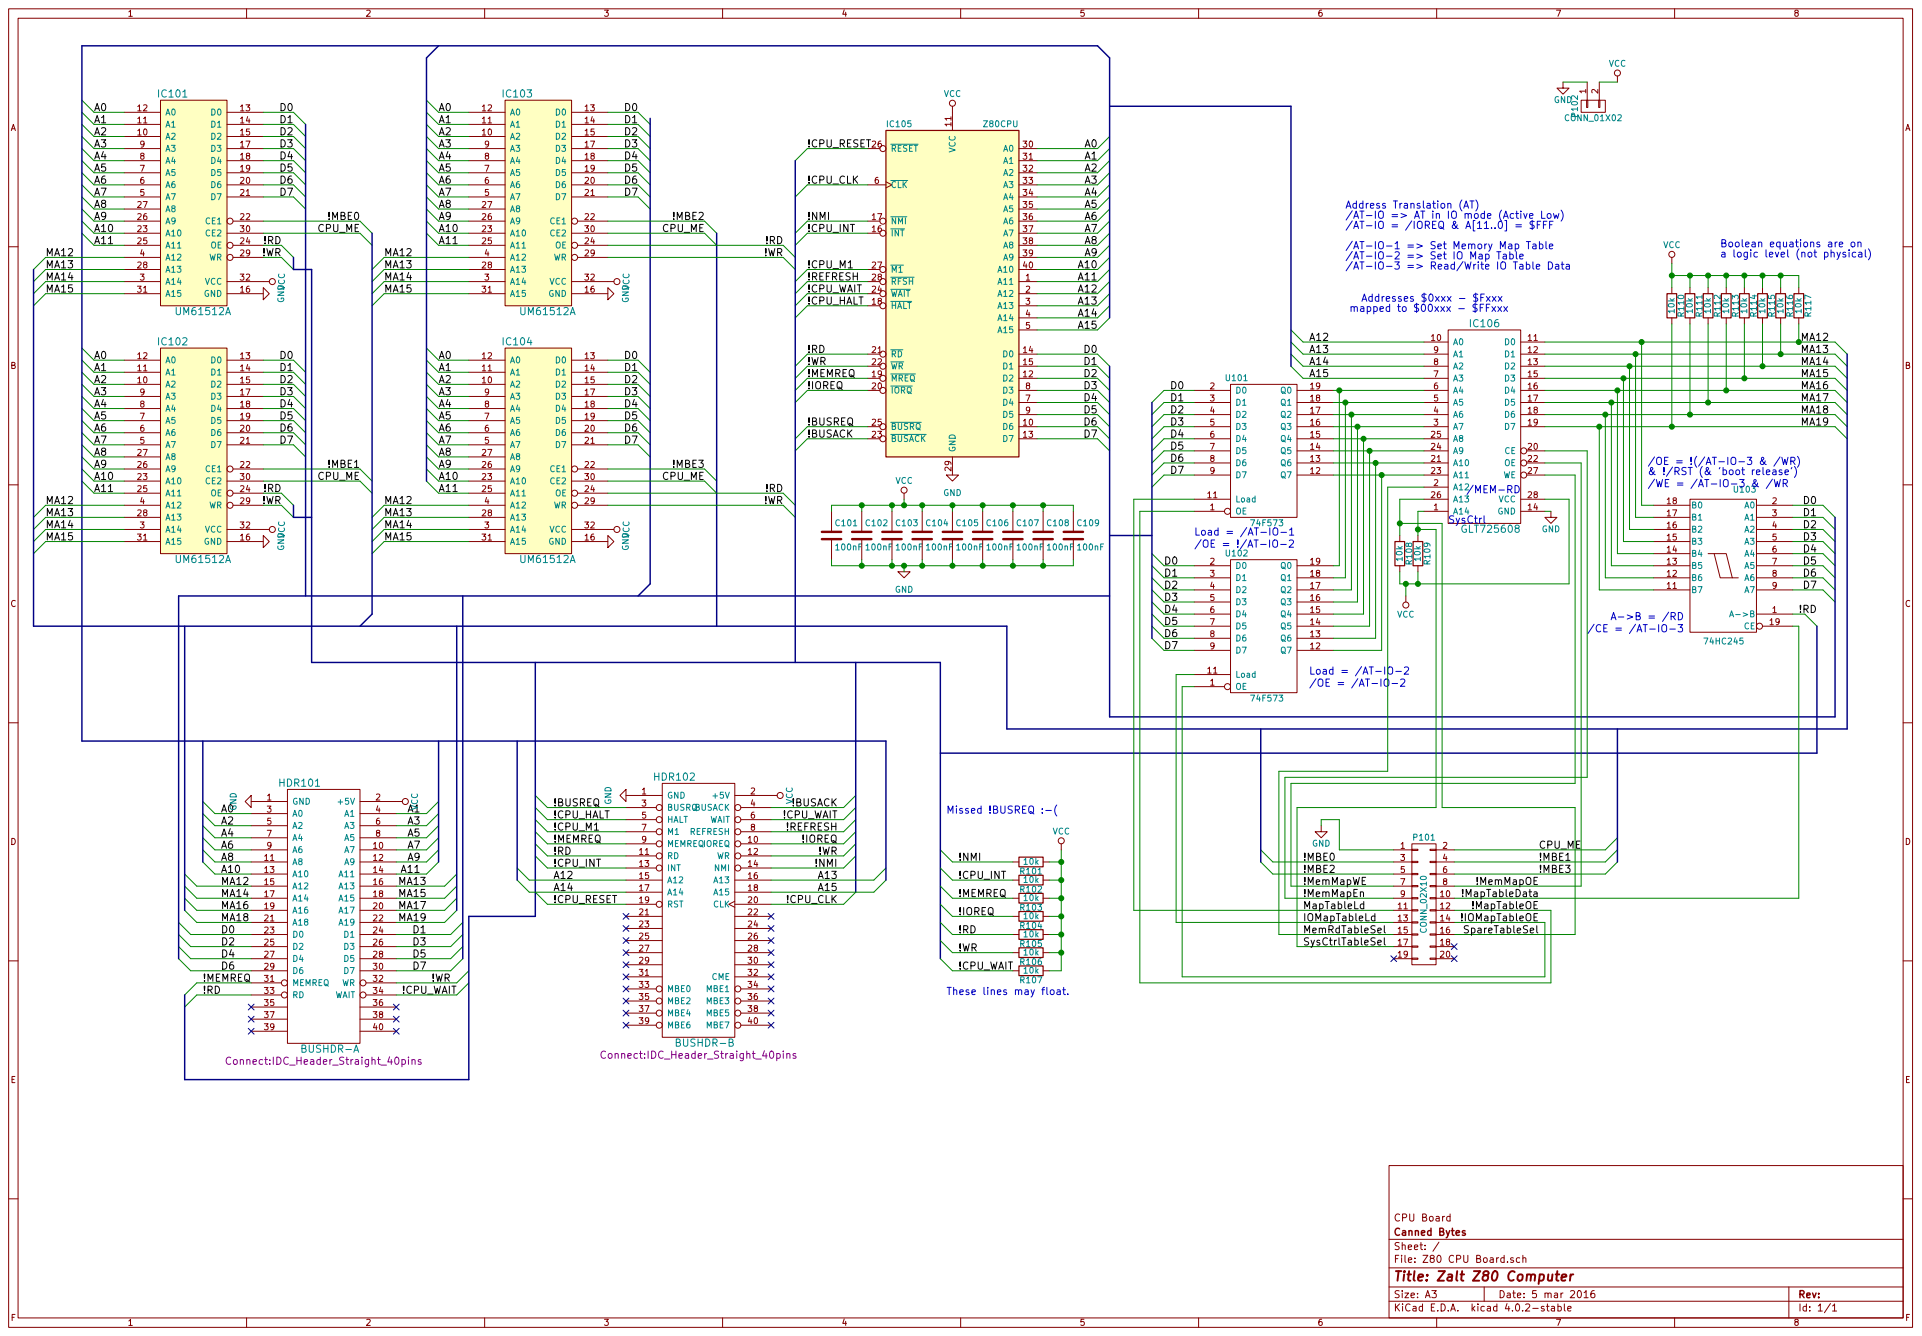
[picture p22: page 1]

Address Translation (AT)
/AT-IO => AT in IO mode (Active Low)
/AT-IO = /IOREQ & A[11..0] = $FFF
/AT-IO-1 => Set Memory Map Table
/AT-IO-2 => Set IO Map Table
/AT-IO-3 => Read/Write IO Table Data

Boolean equations are on
a logic level (not physical)

100nF VCC GND GNDVCC GND GND VCC VCC

Id: 1/1 Title: Zalt Z80 Computer File: Z80 CPU Board.sch Sheet: / Canned Bytes CPU Board
