obiwanjacobi/Zalt/Decoder Board v1.0 - locked/Decoder Board schematic.pdf

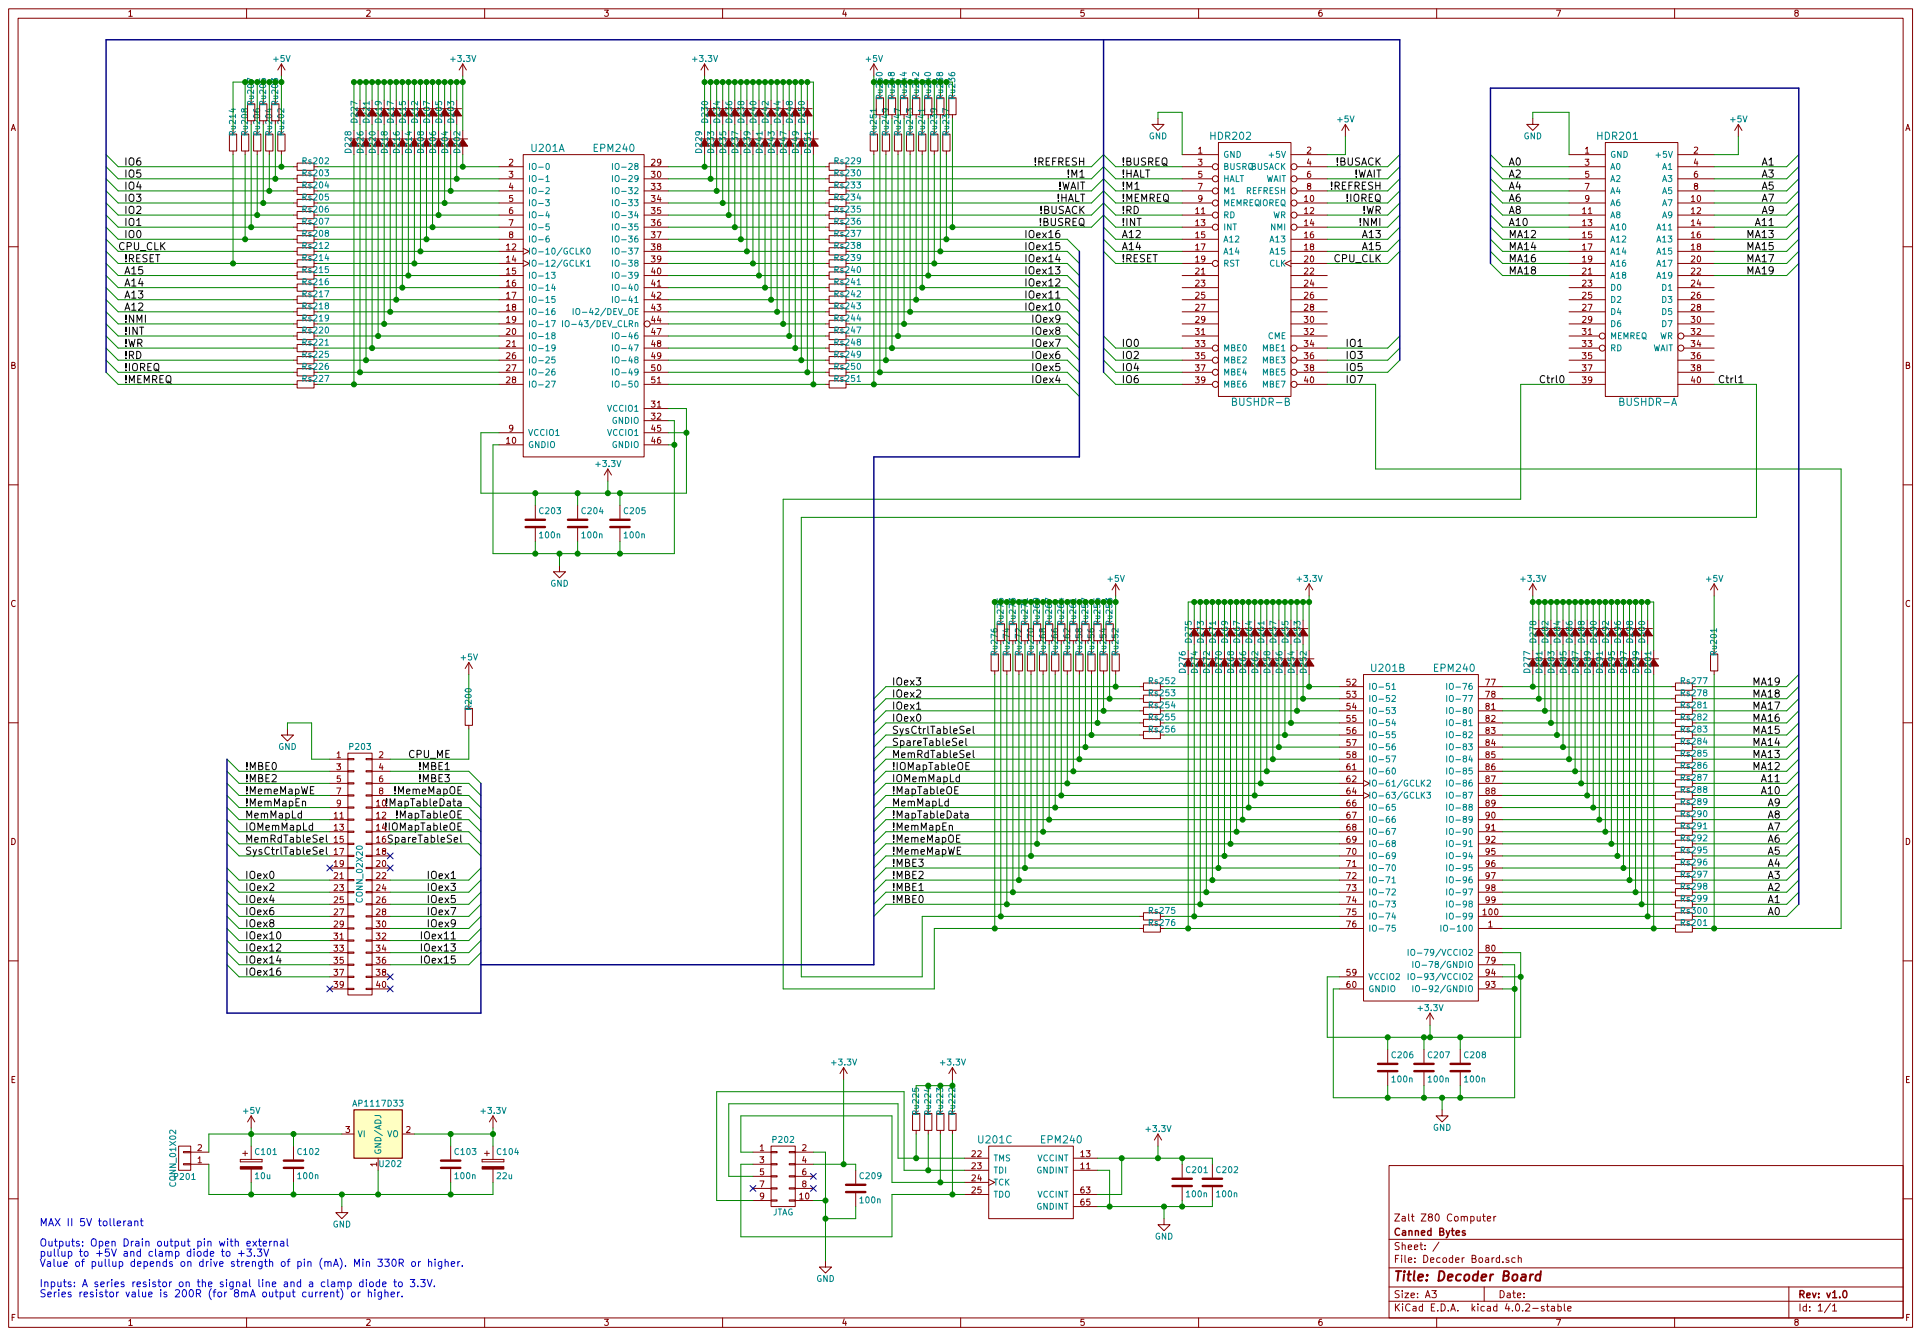
[picture p23: page 1]

Zalt Z80 Computer MAX II 5V tollerant Outputs: Open Drain output pin with external

File: Decoder Board.sch Sheet: / Canned Bytes

pullup to +5V and clamp diode to +3.3V
Value of pullup depends on drive strength of pin (mA). Min 330R or higher.
Inputs: A series resistor on the signal line and a clamp diode to 3.3V.

Id: 1/1 Title: Decoder Board
