obiwanjacobi/Zalt/Under Construction/GPU Board v0.1/Example Conneting SDRAM to STM32F4.pdf

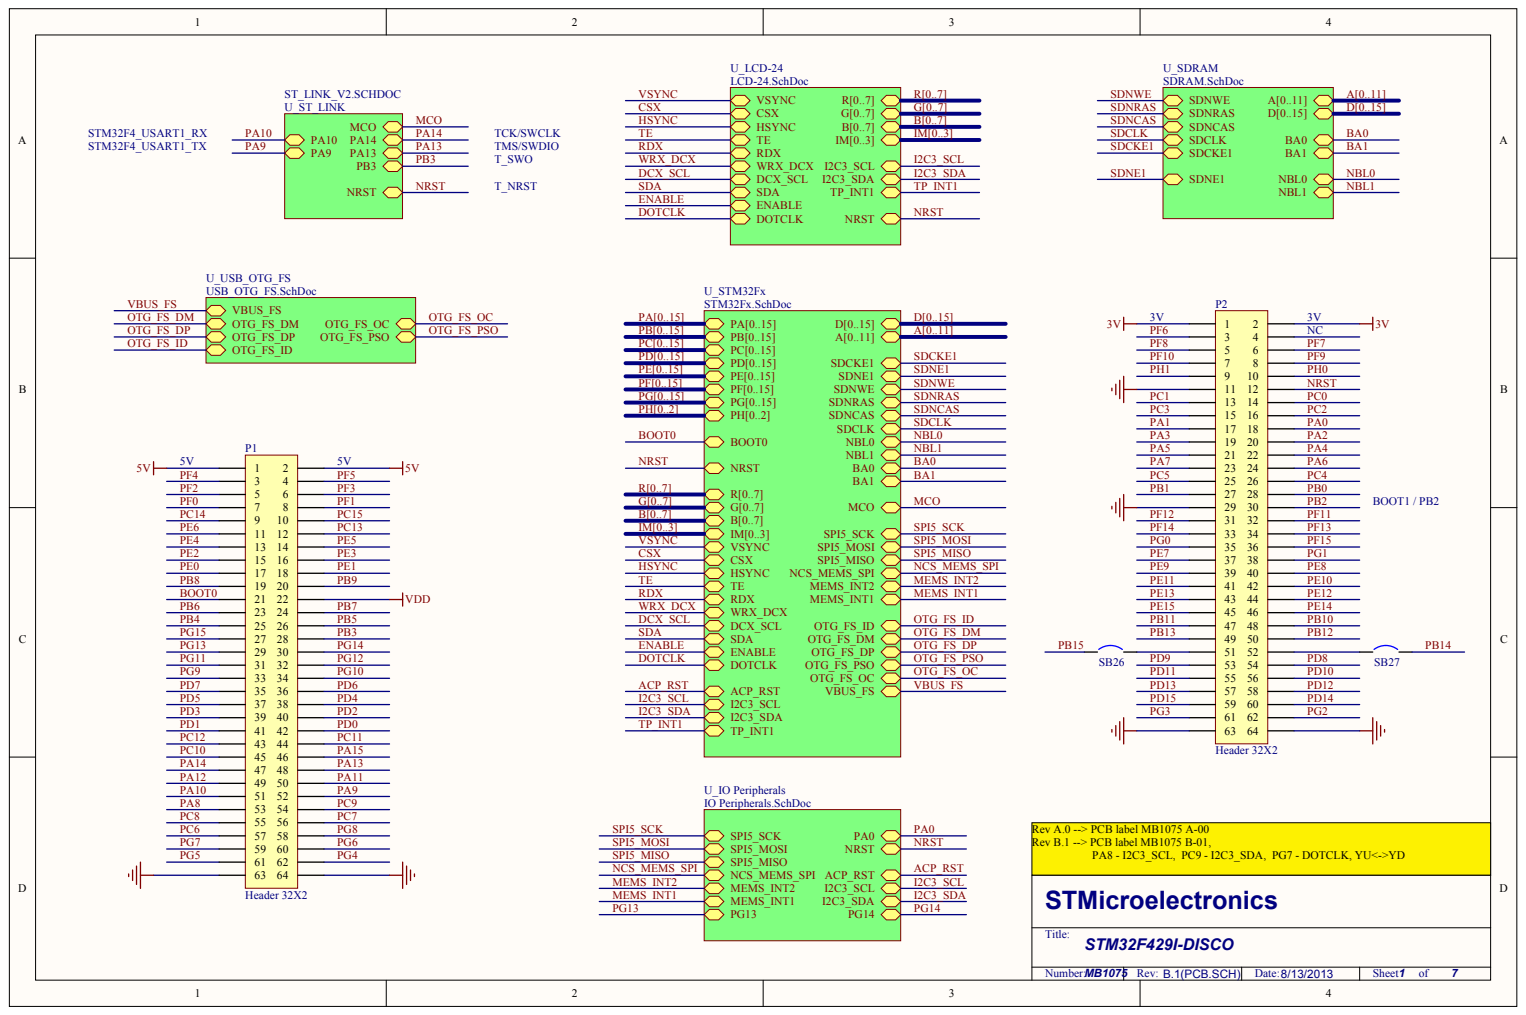
[picture p24: page 1]

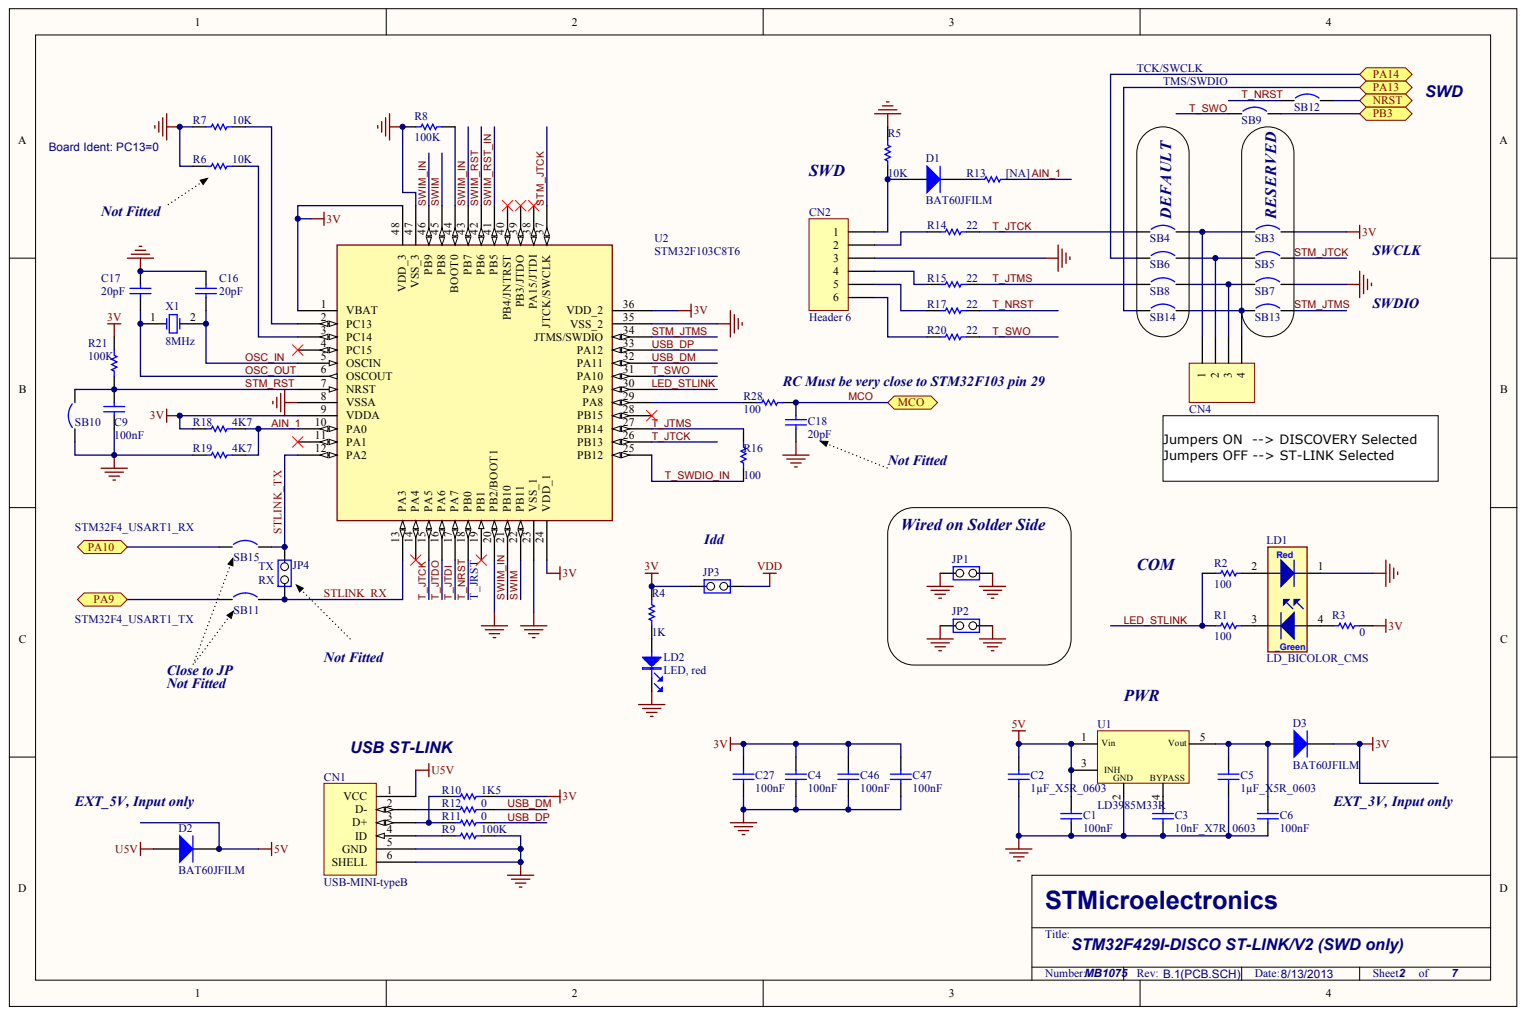
[picture p25: page 2]

RC Must be very close to STM32F103 pin 29

Jumpers ON --> DISCOVERY Selected
Jumpers OFF --> ST-LINK Selected

Wired on Solder Side

Title:
STM32F429I-DISCO ST-LINK/V2 (SWD only)

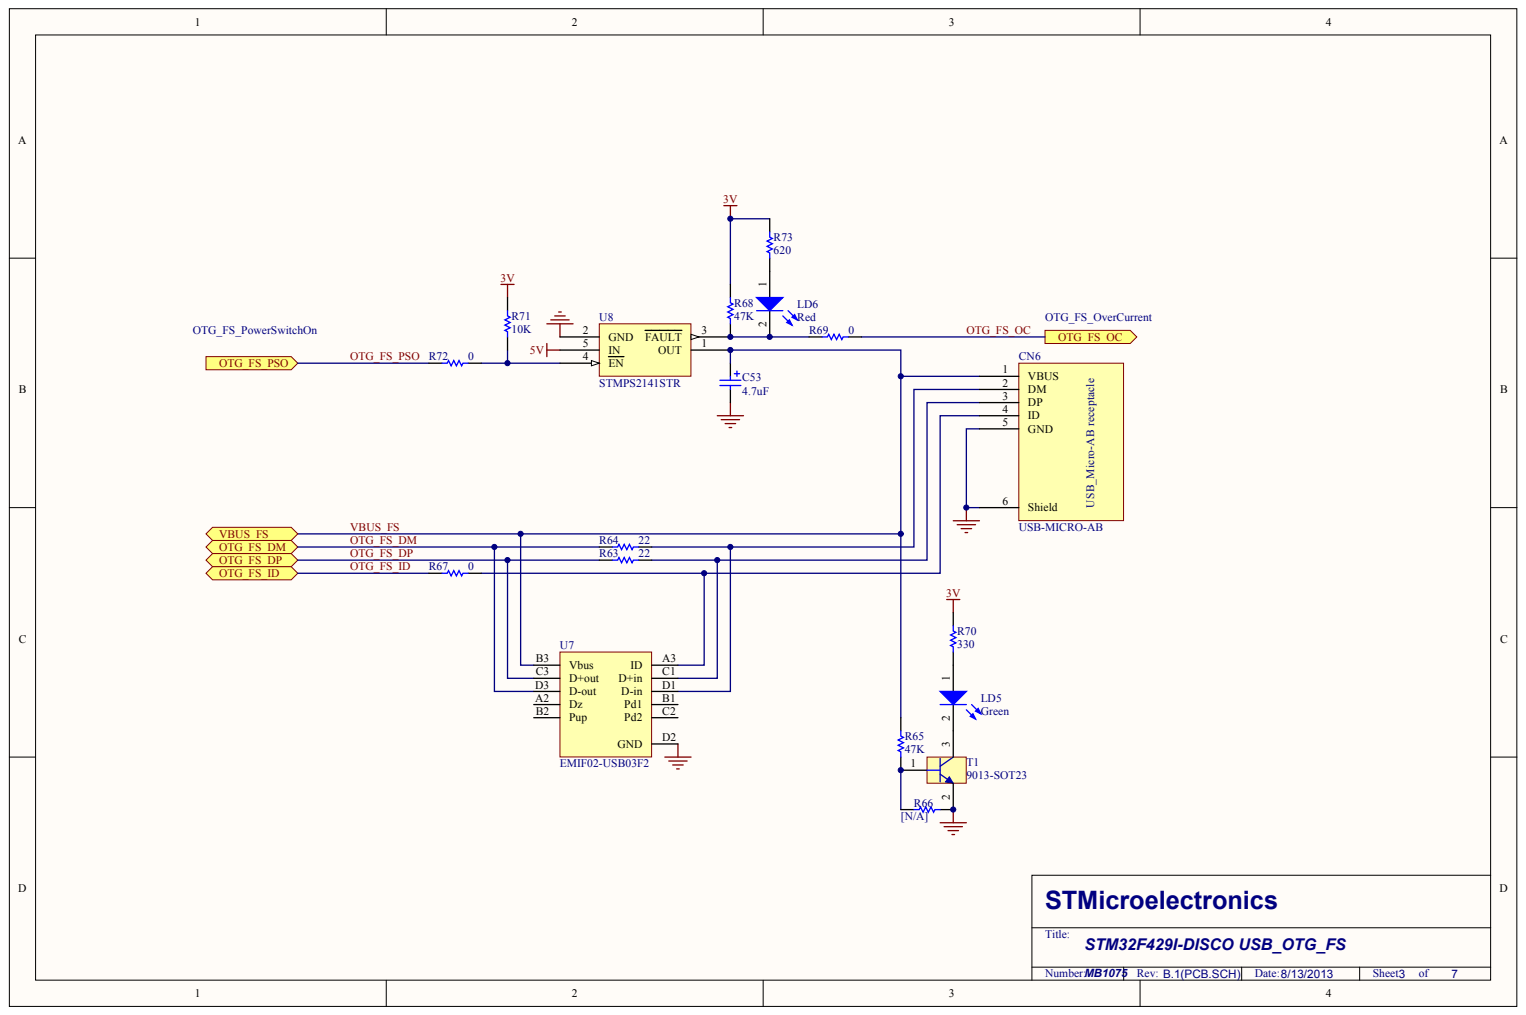
[picture p26: page 3]

C53 STMPS2141STR | DM 2

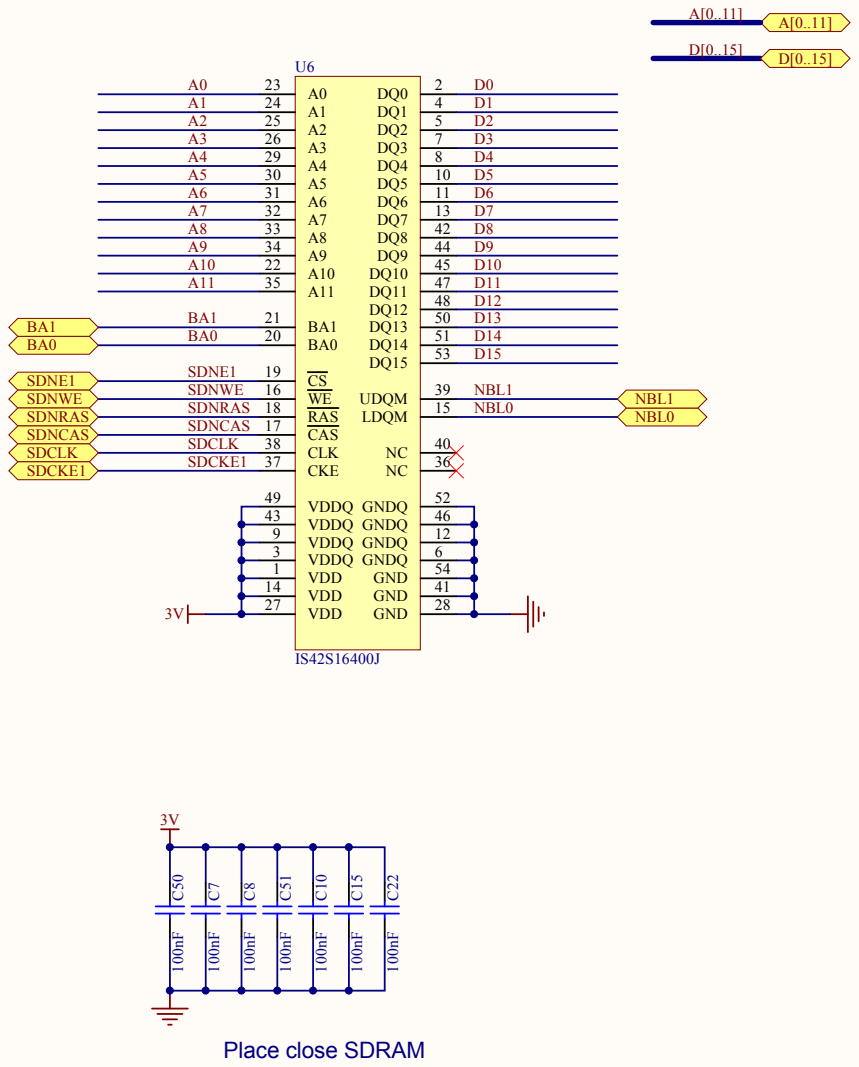
[picture p27: page 4]

VDD 1
VDD 14

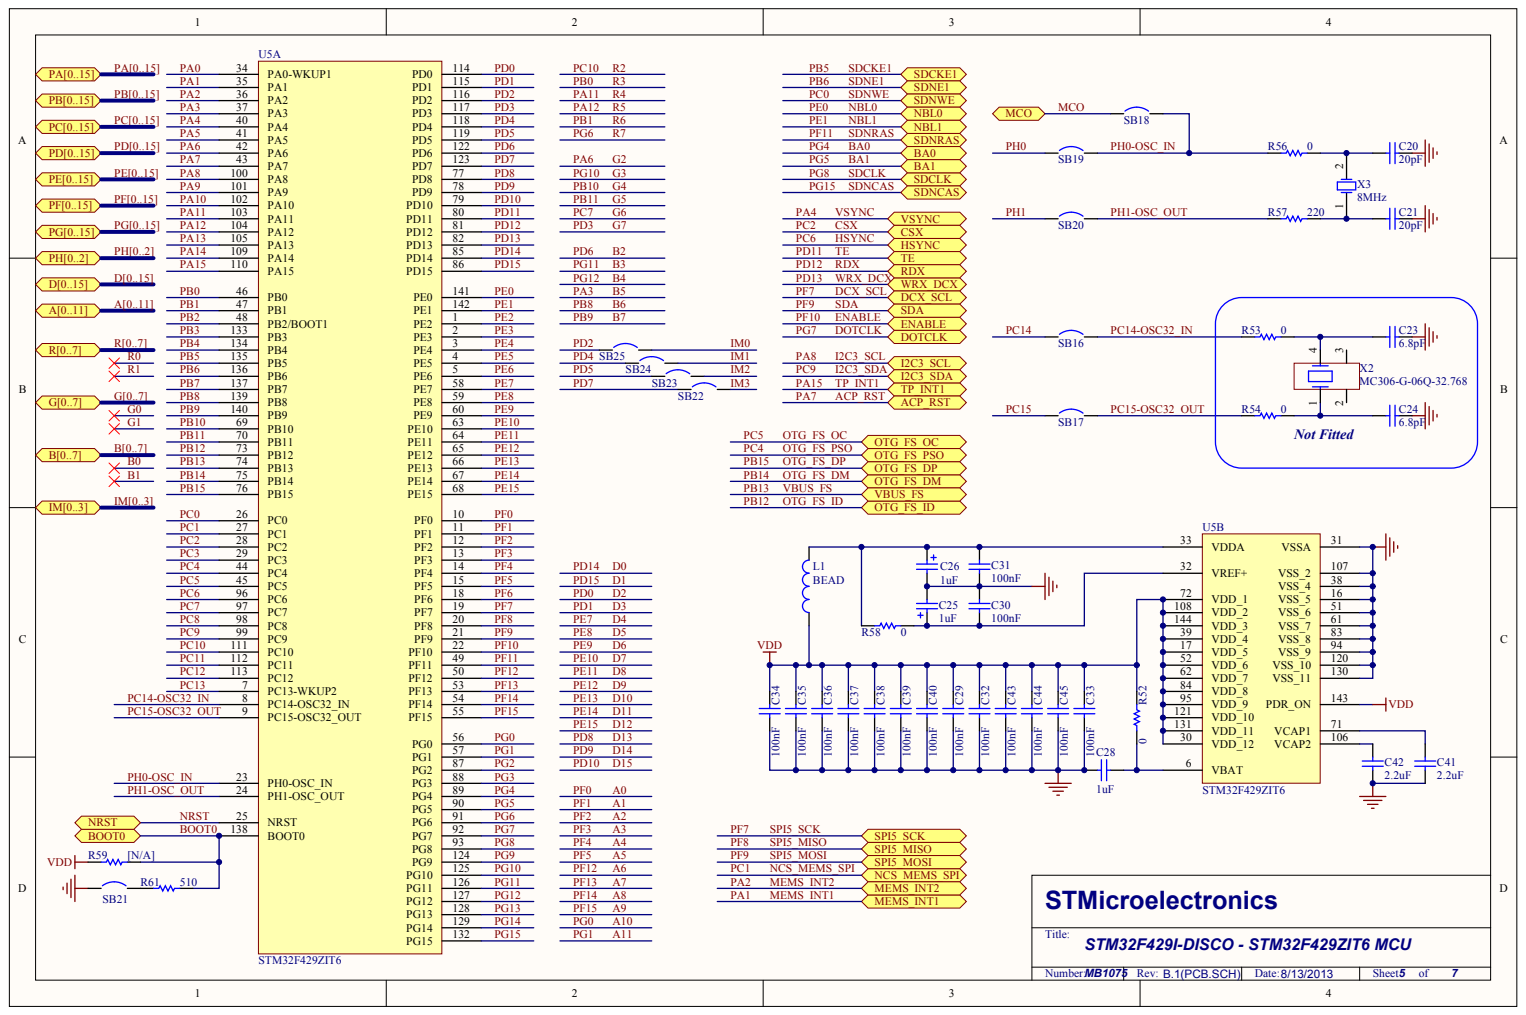
[picture p28: page 5]

C2 6 C3 1 | 3 2 | | 107
1uF | 100 n F | | 7 2 | 3 8

108 | | 5 1
144 | | 6 1

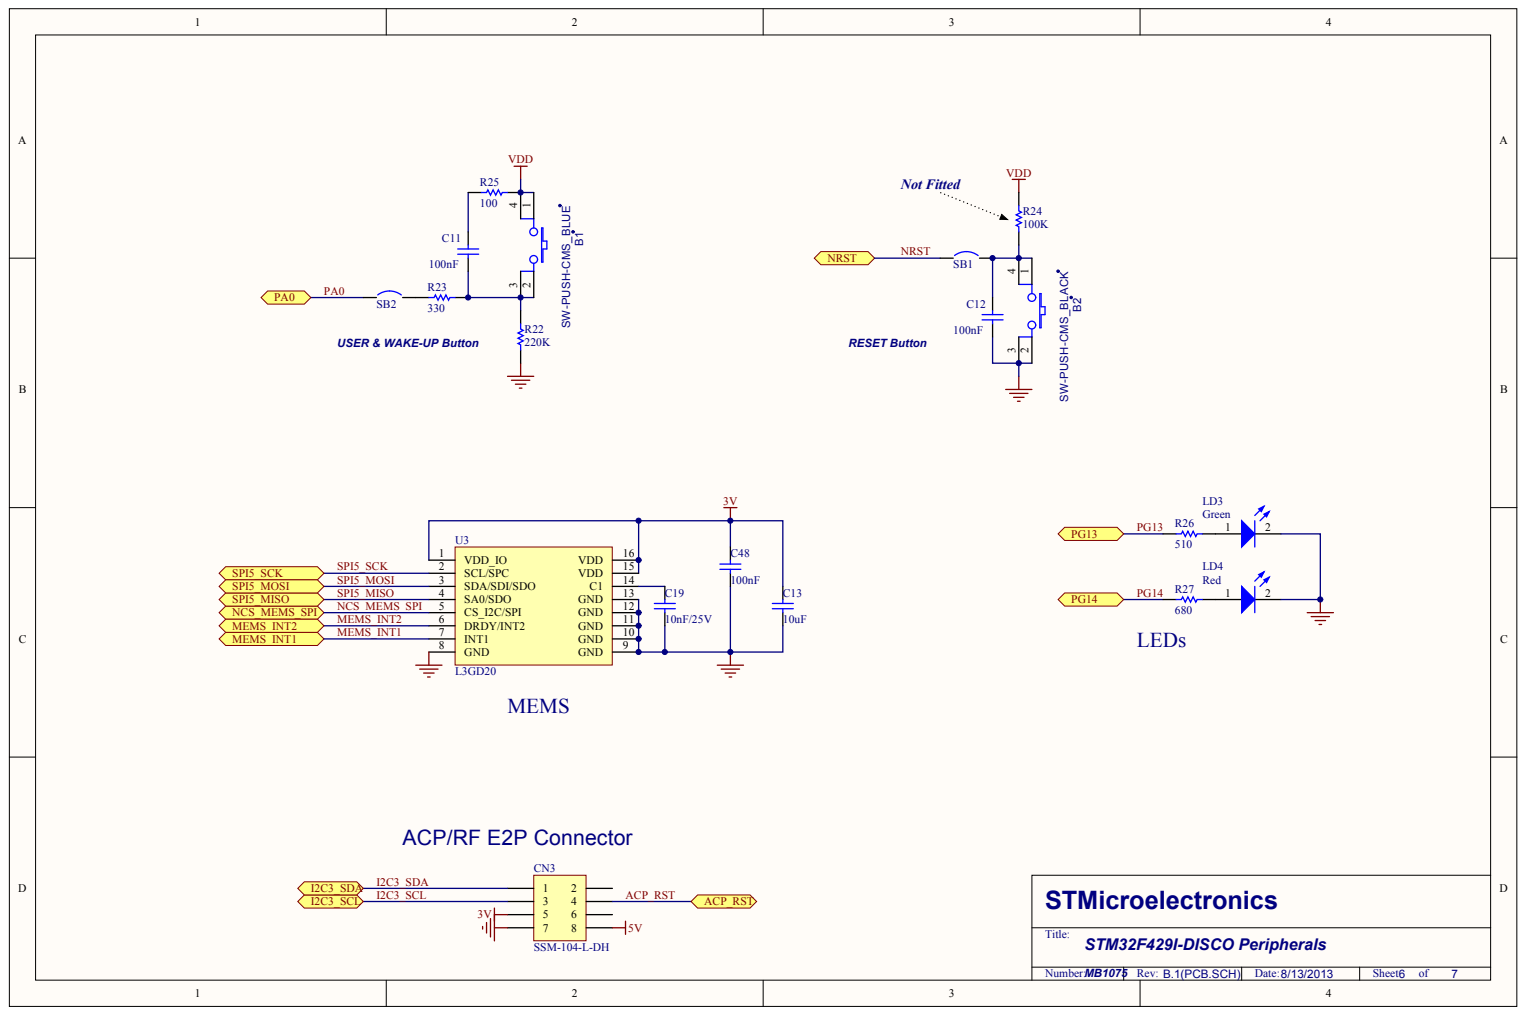
[picture p29: page 6]

USER & WAKE-UP Button

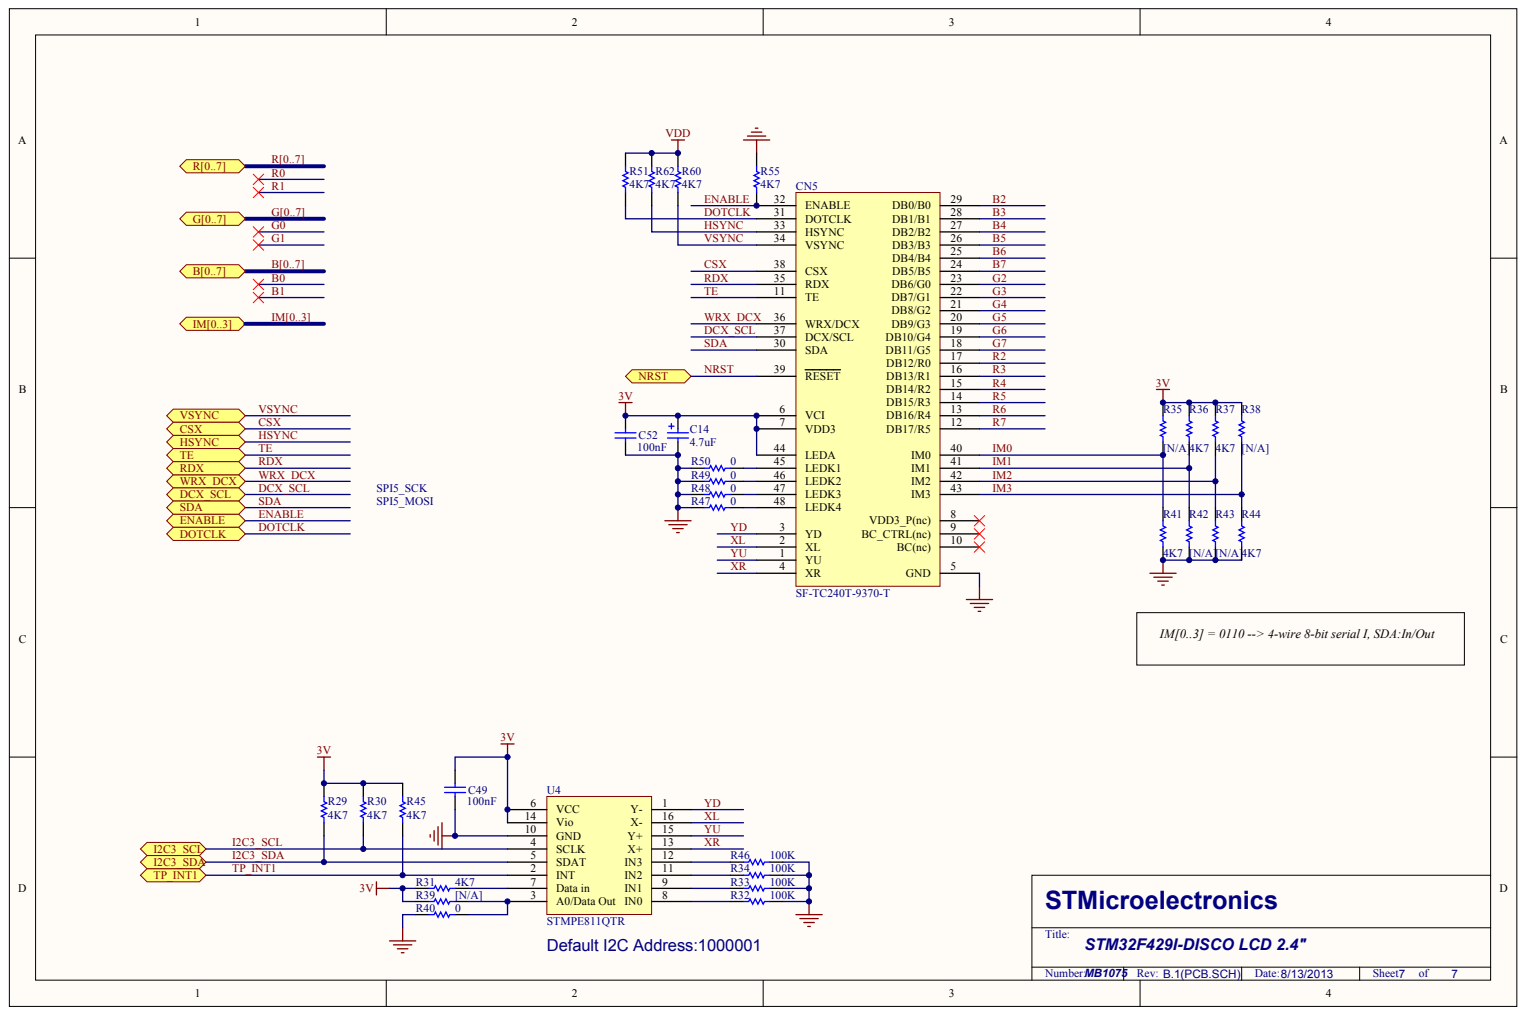
[picture p30: page 7]

4 2
4 3

IM[0..3] = 0110 --> 4-wire 8-bit serial I, SDA:In/Out

1 4
1 0
