obiwanjacobi/Zalt/VDP Board v1.0 - locked/VDP-Composite-Schematic.pdf

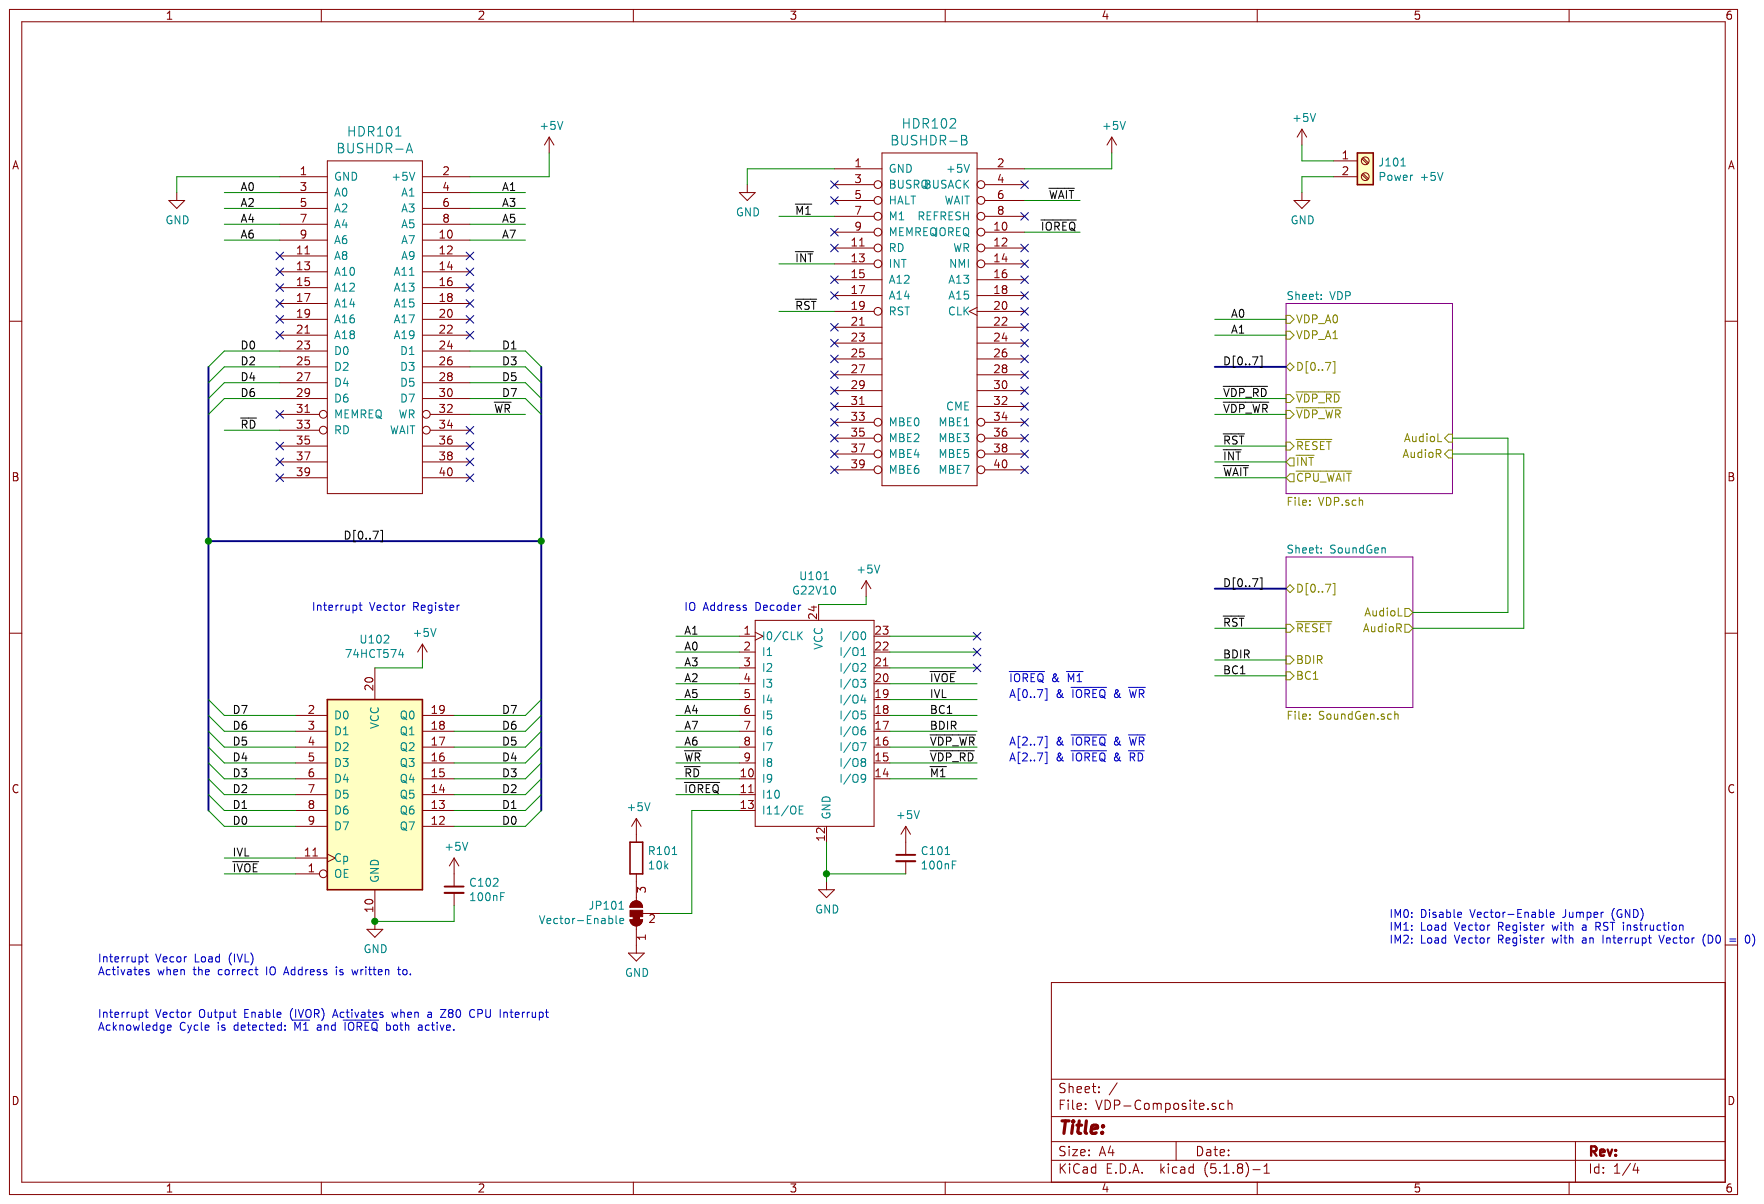
[picture p31: page 1]

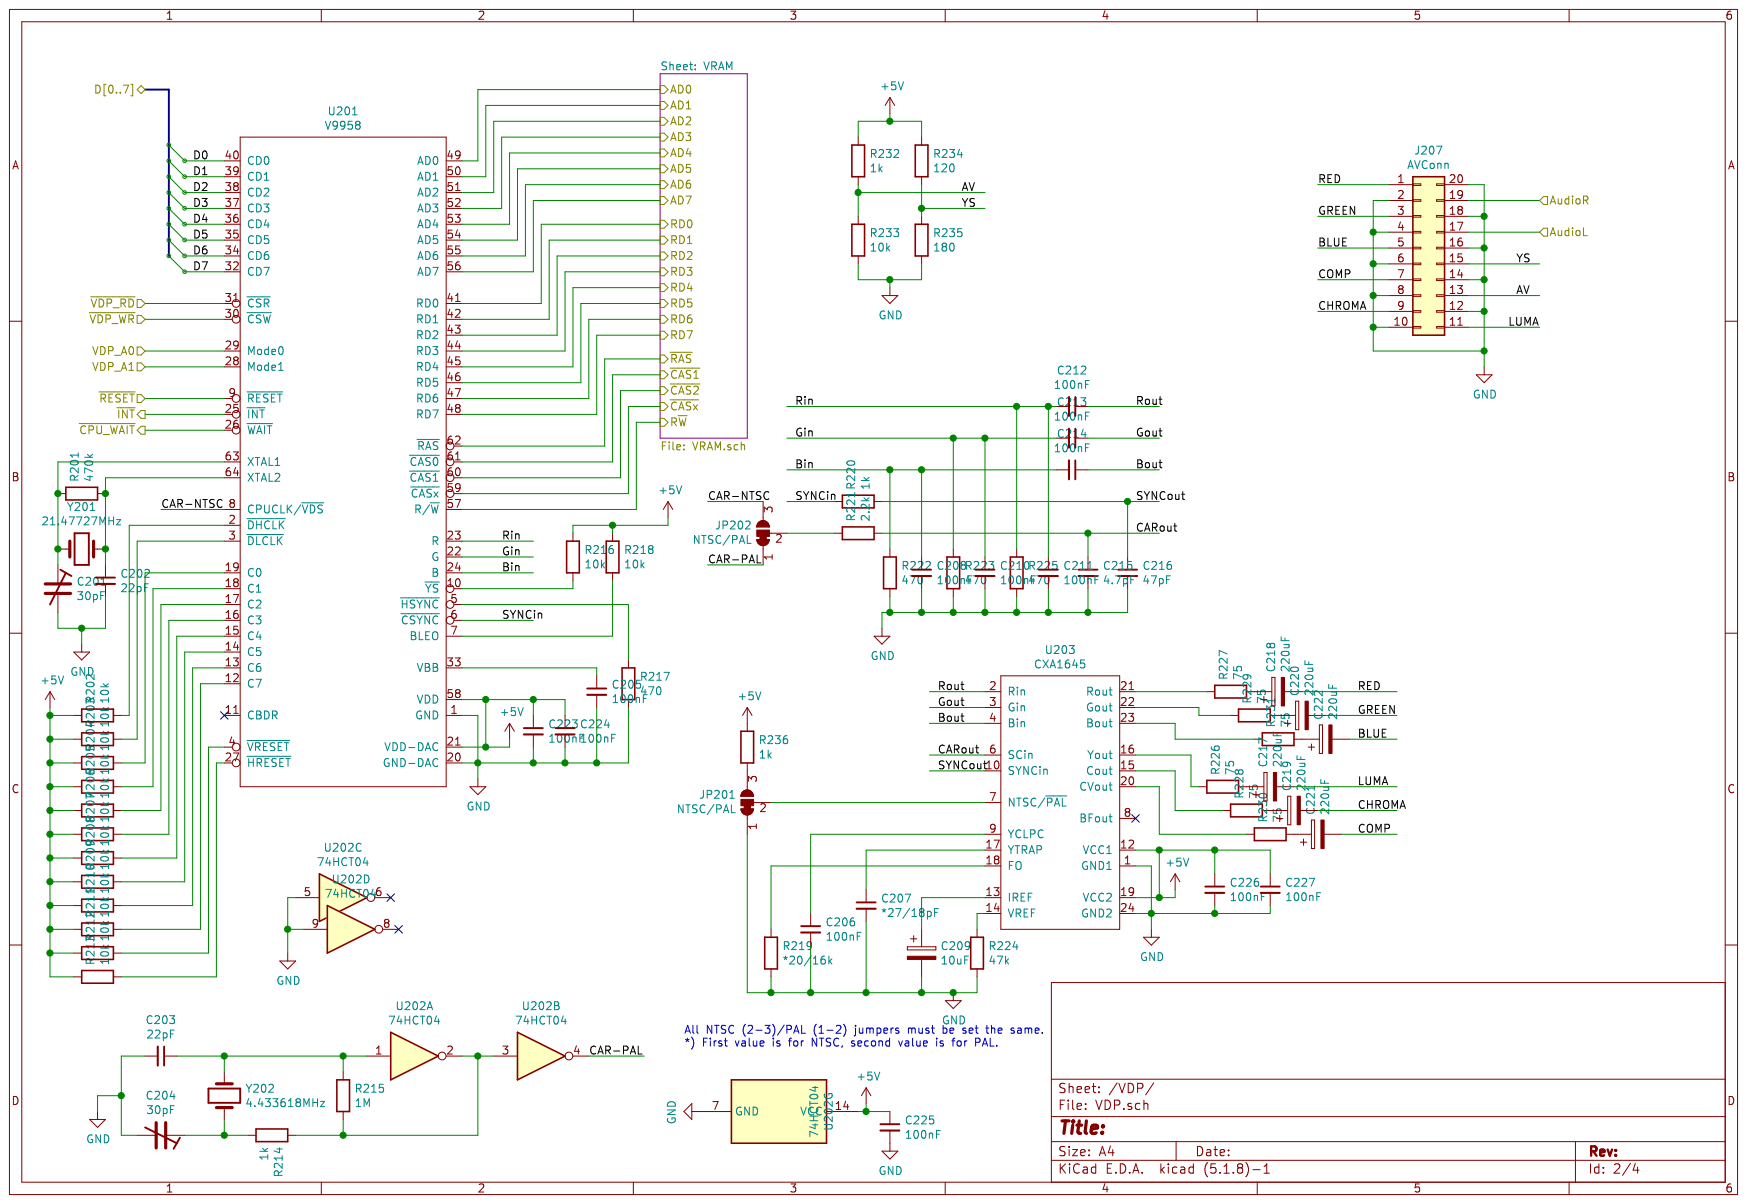
[picture p32: page 2]

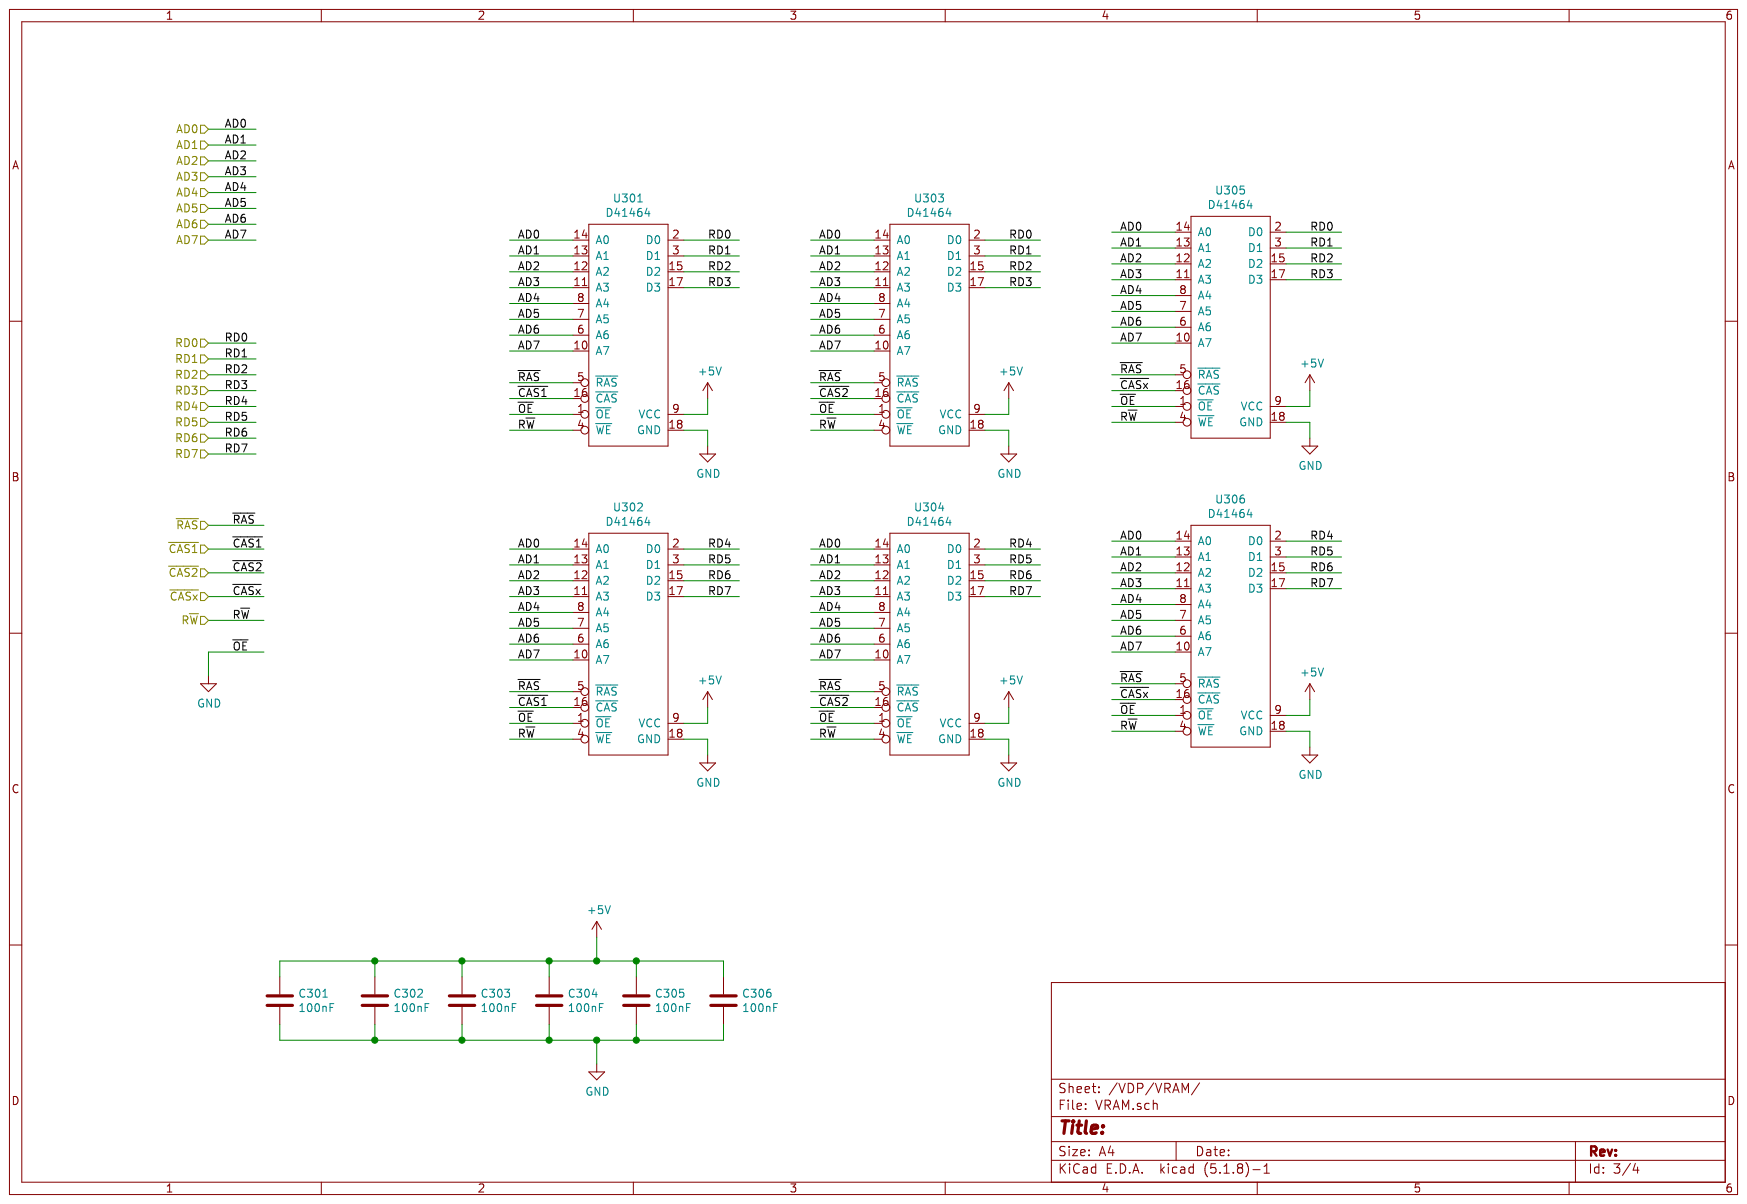
[picture p33: page 3]

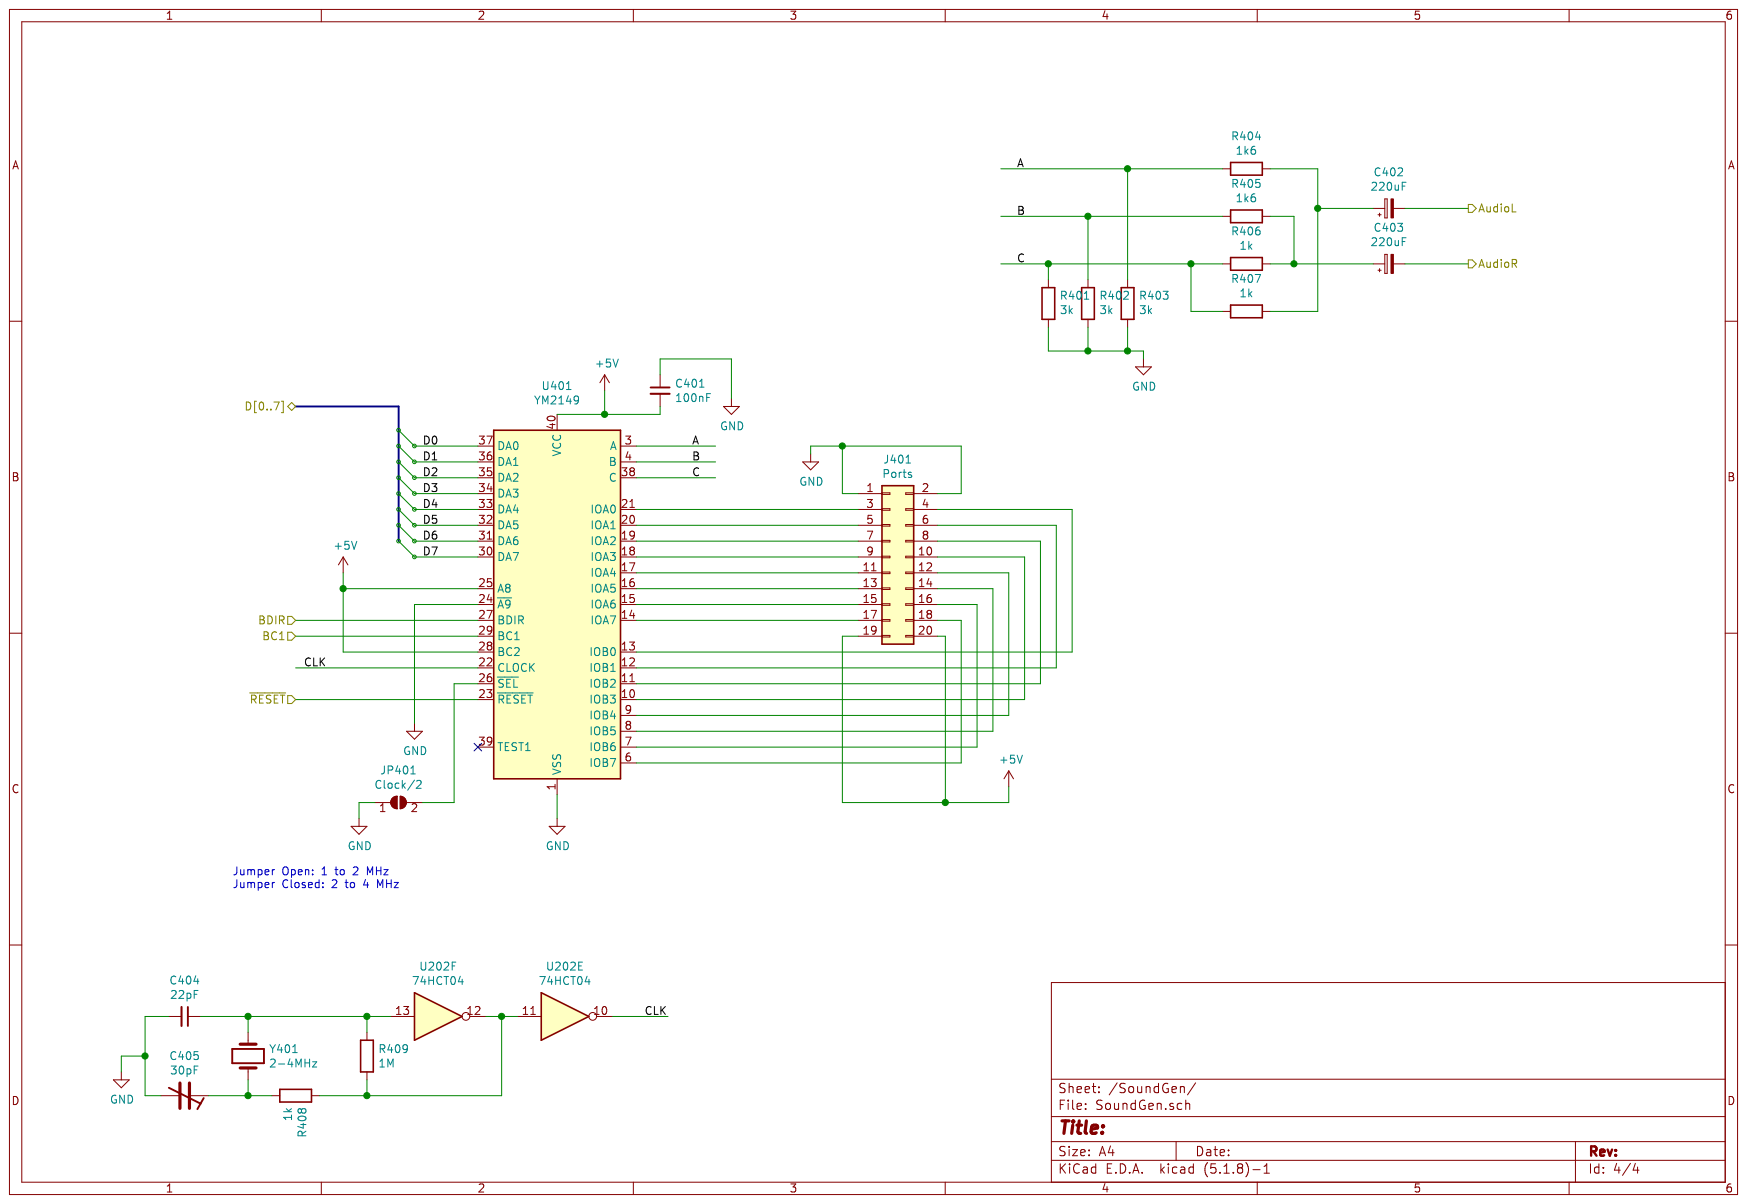
[picture p34: page 4]
