obiwanjacobi/Zalt/Under Construction/TTL VGA v0.1/Kicad/Schematic.pdf

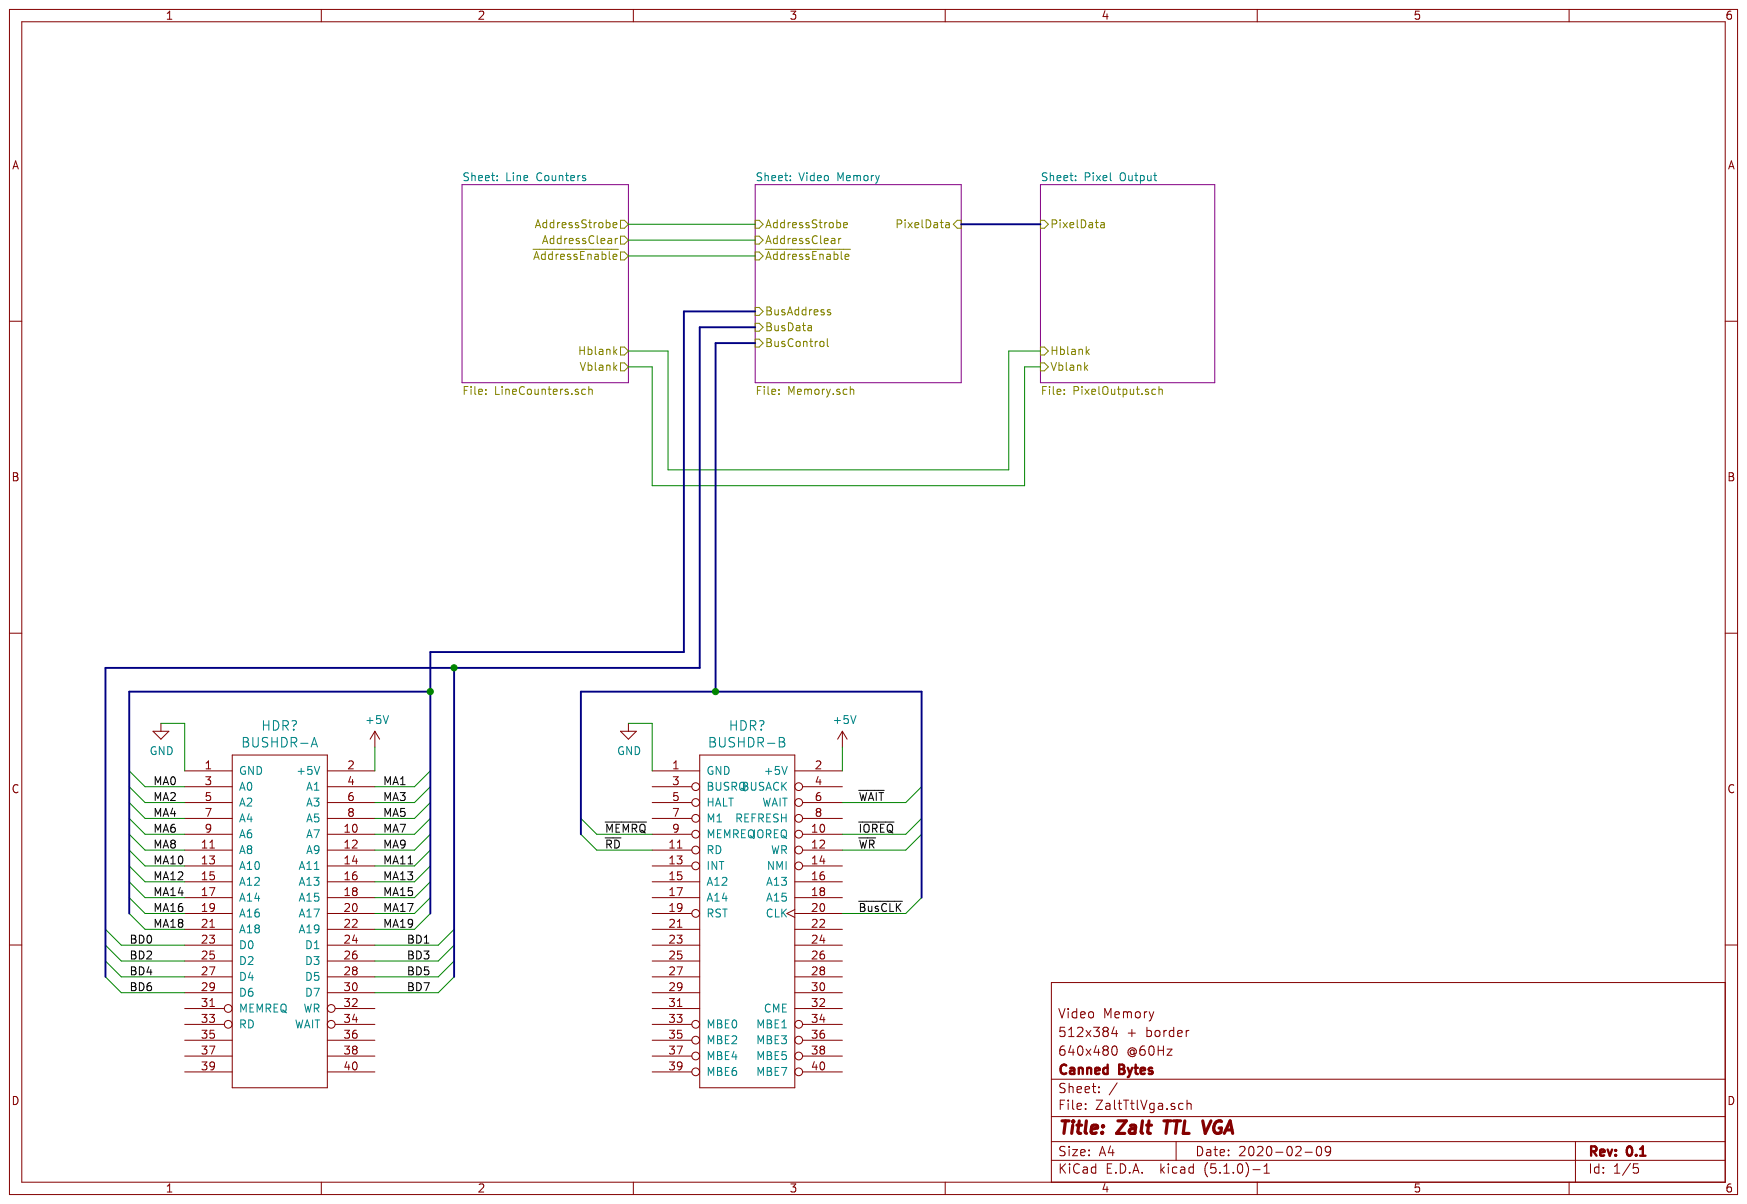
[picture p43: page 1]

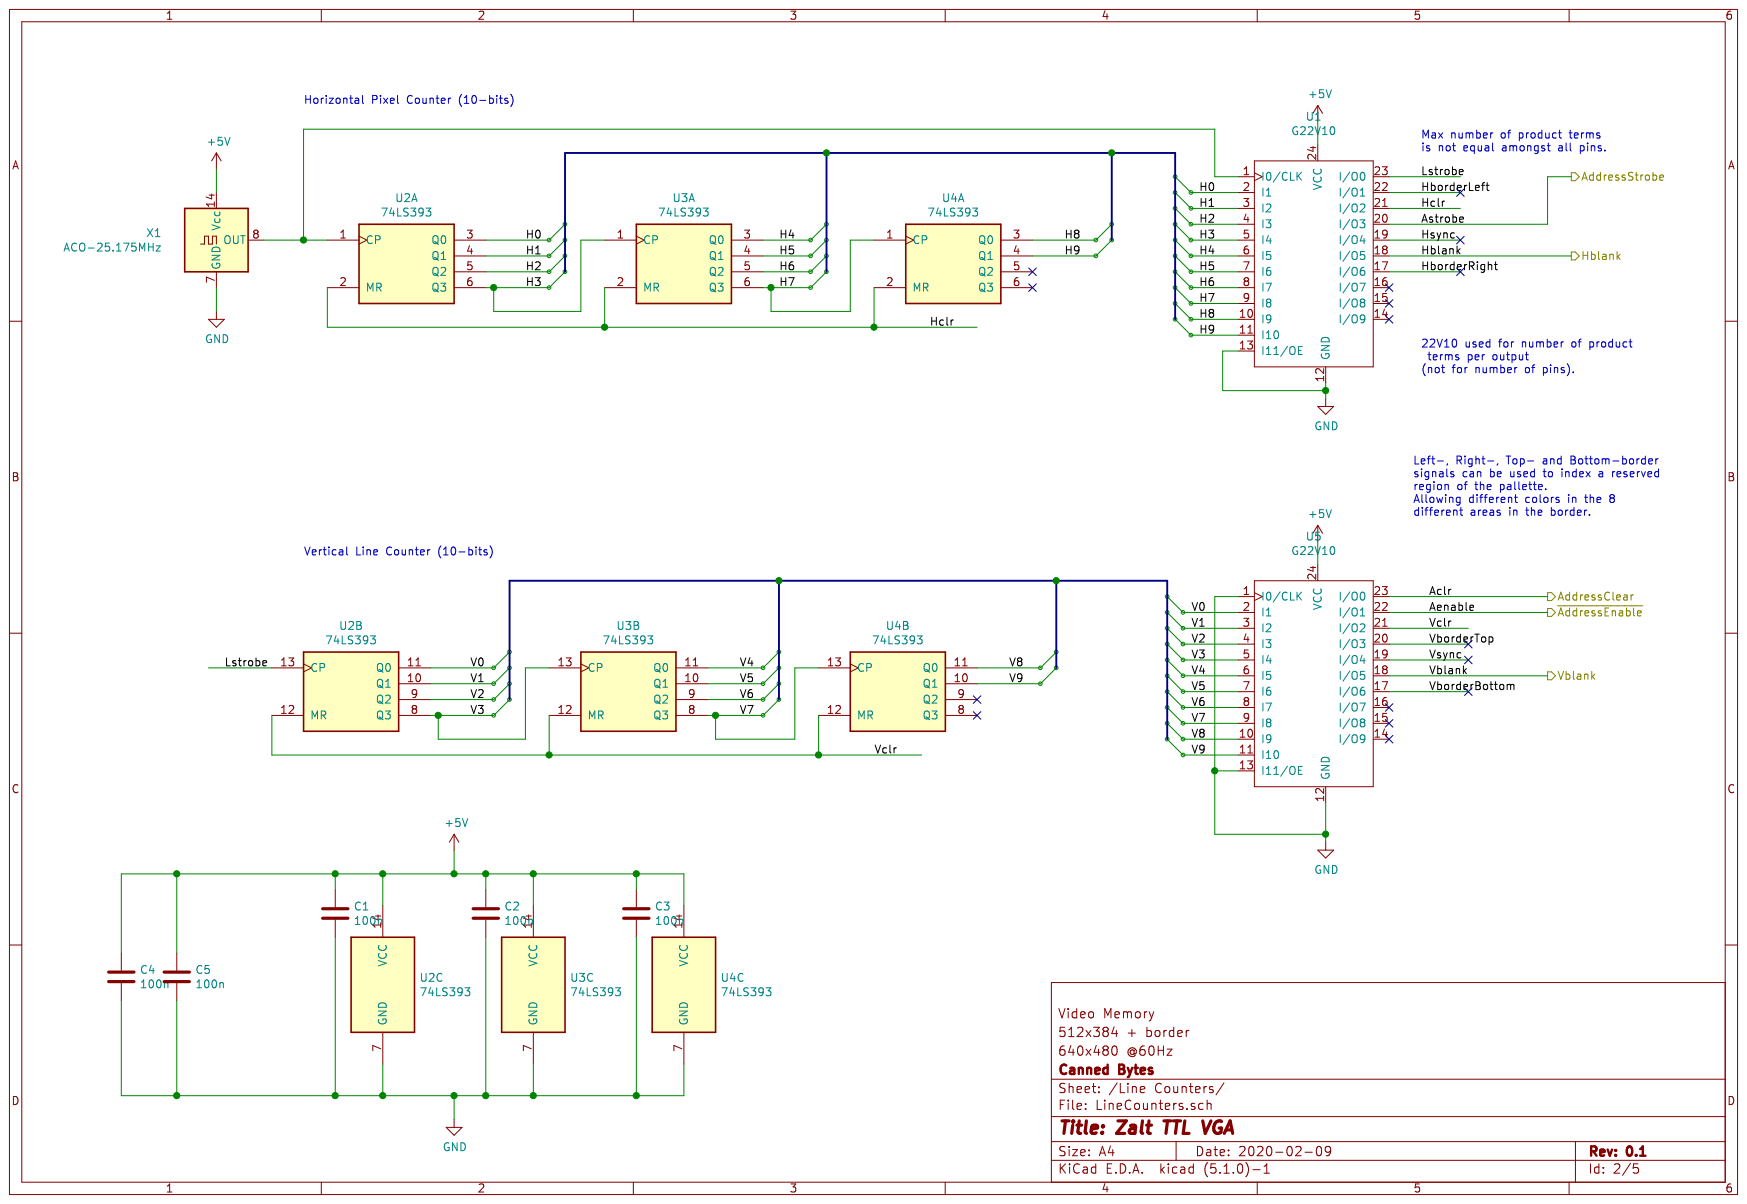
[picture p44: page 2]

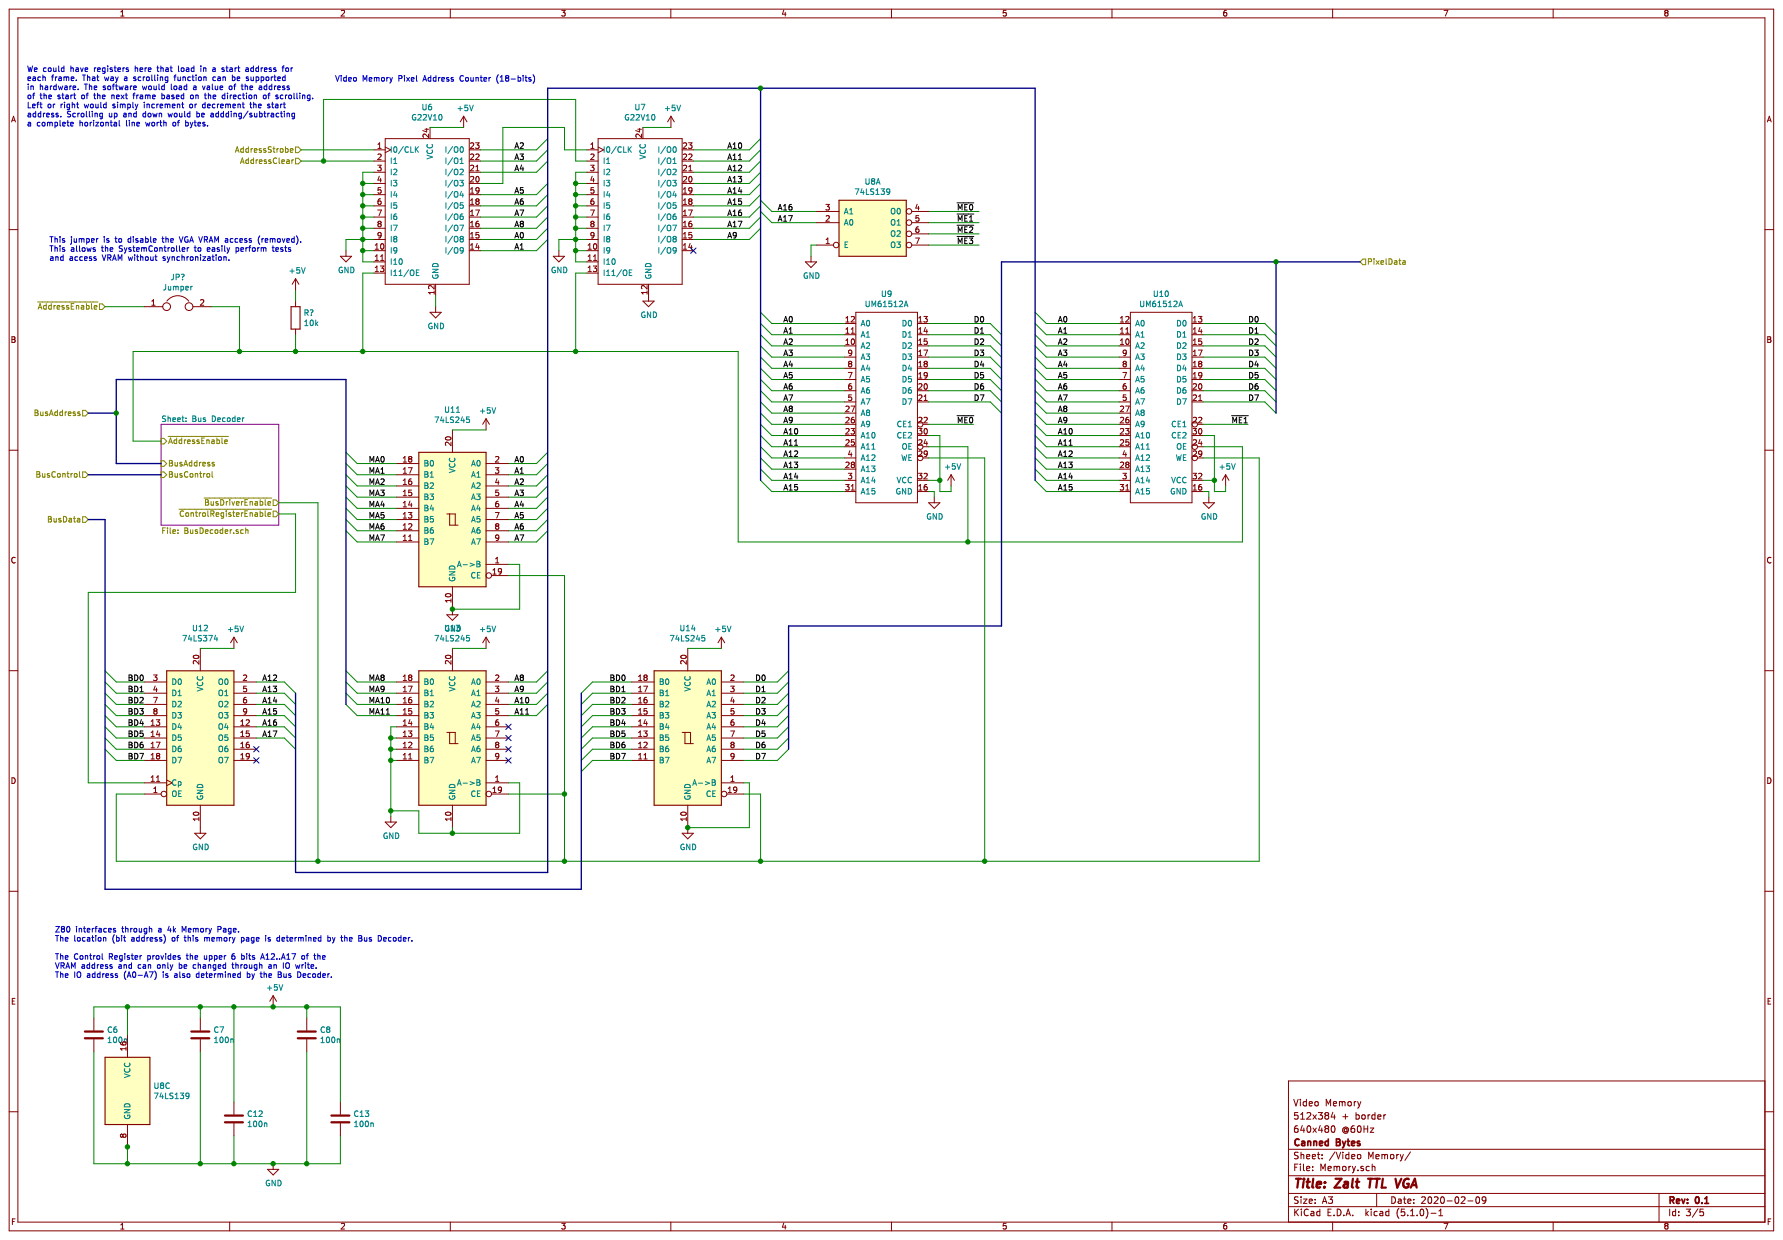
[picture p45: page 3]

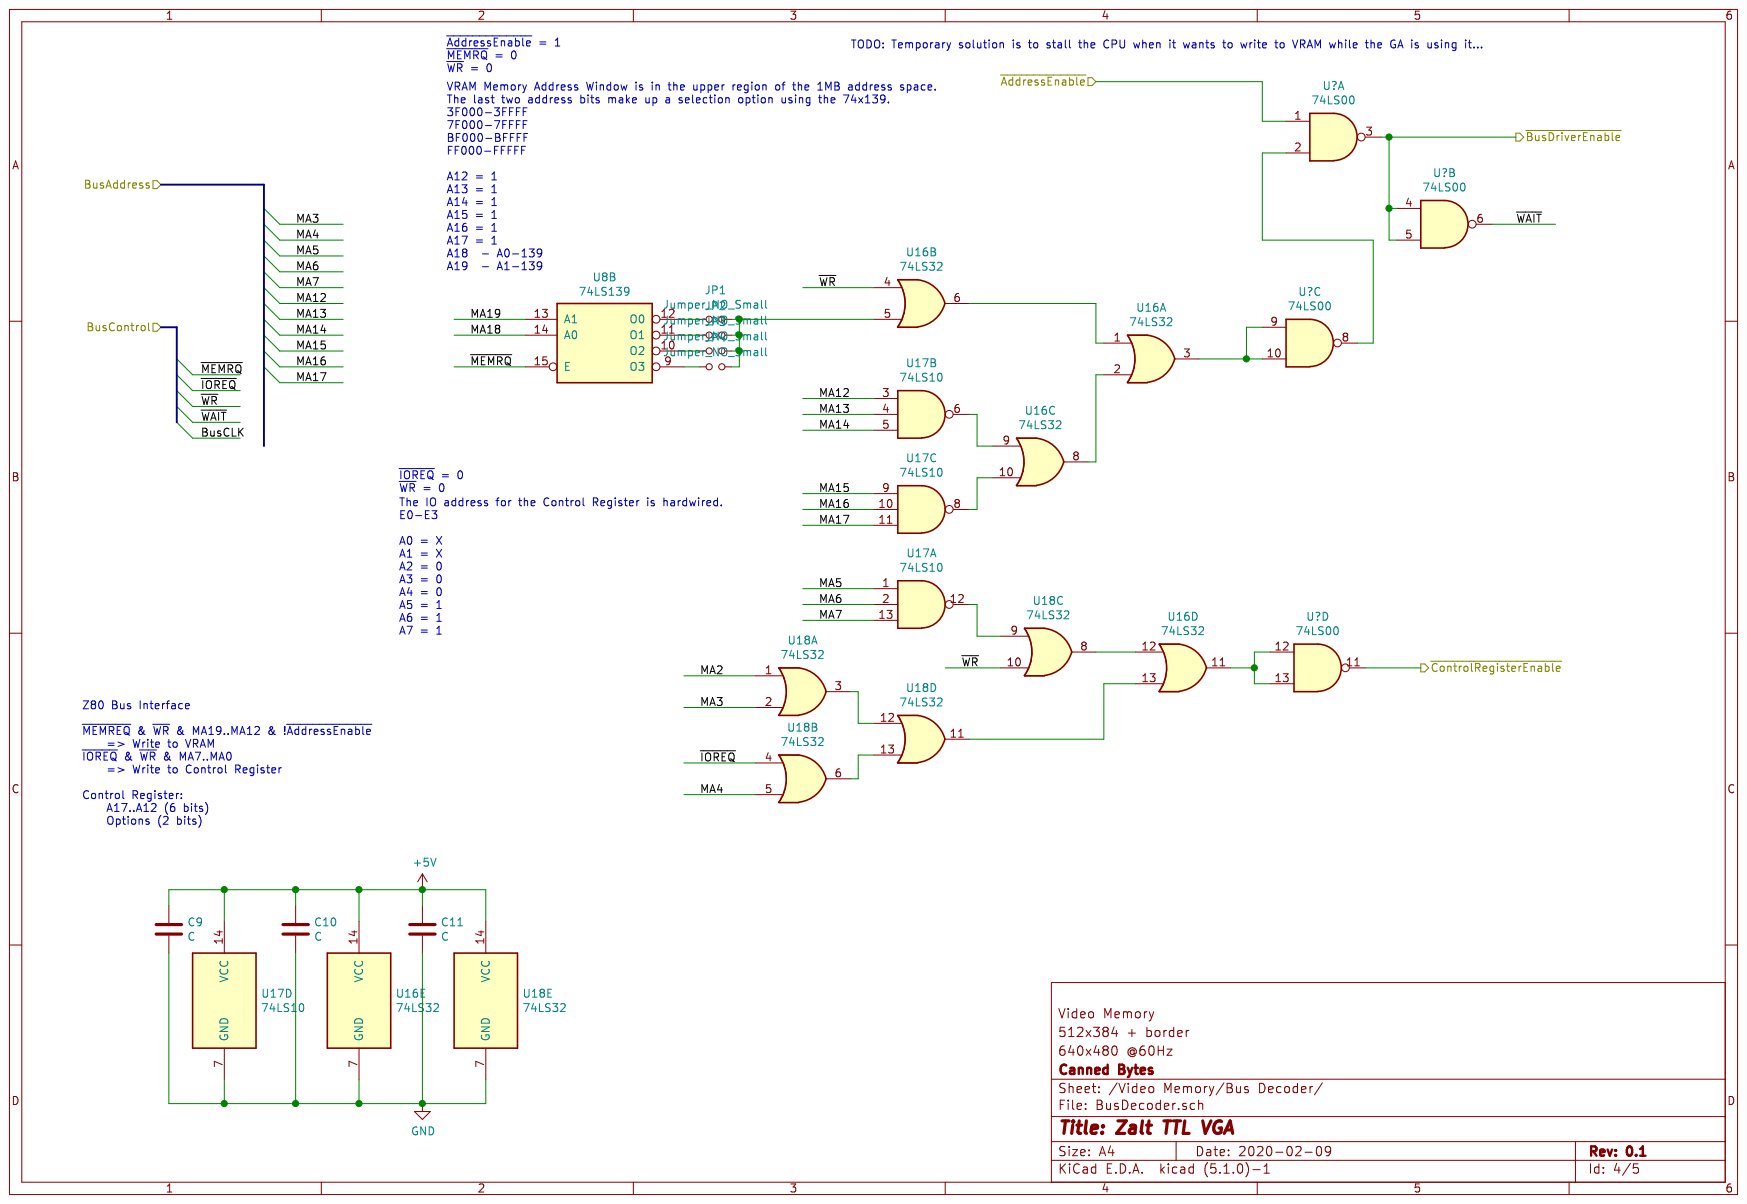
[picture p46: page 4]

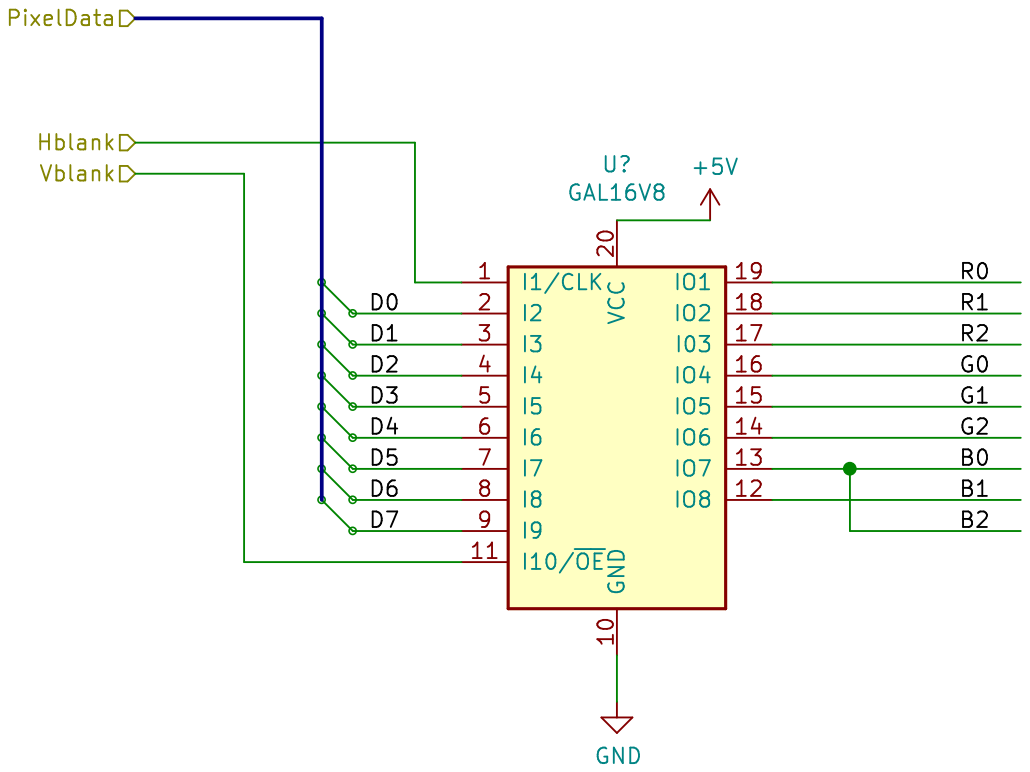
[picture p47: page 5]
