obiwanjacobi/Zalt/BusSpy Board/Kicad/BusSpy2.sch

## KiCad design BusSpy Board/Kicad/BusSpy2.sch (2016-10-12)

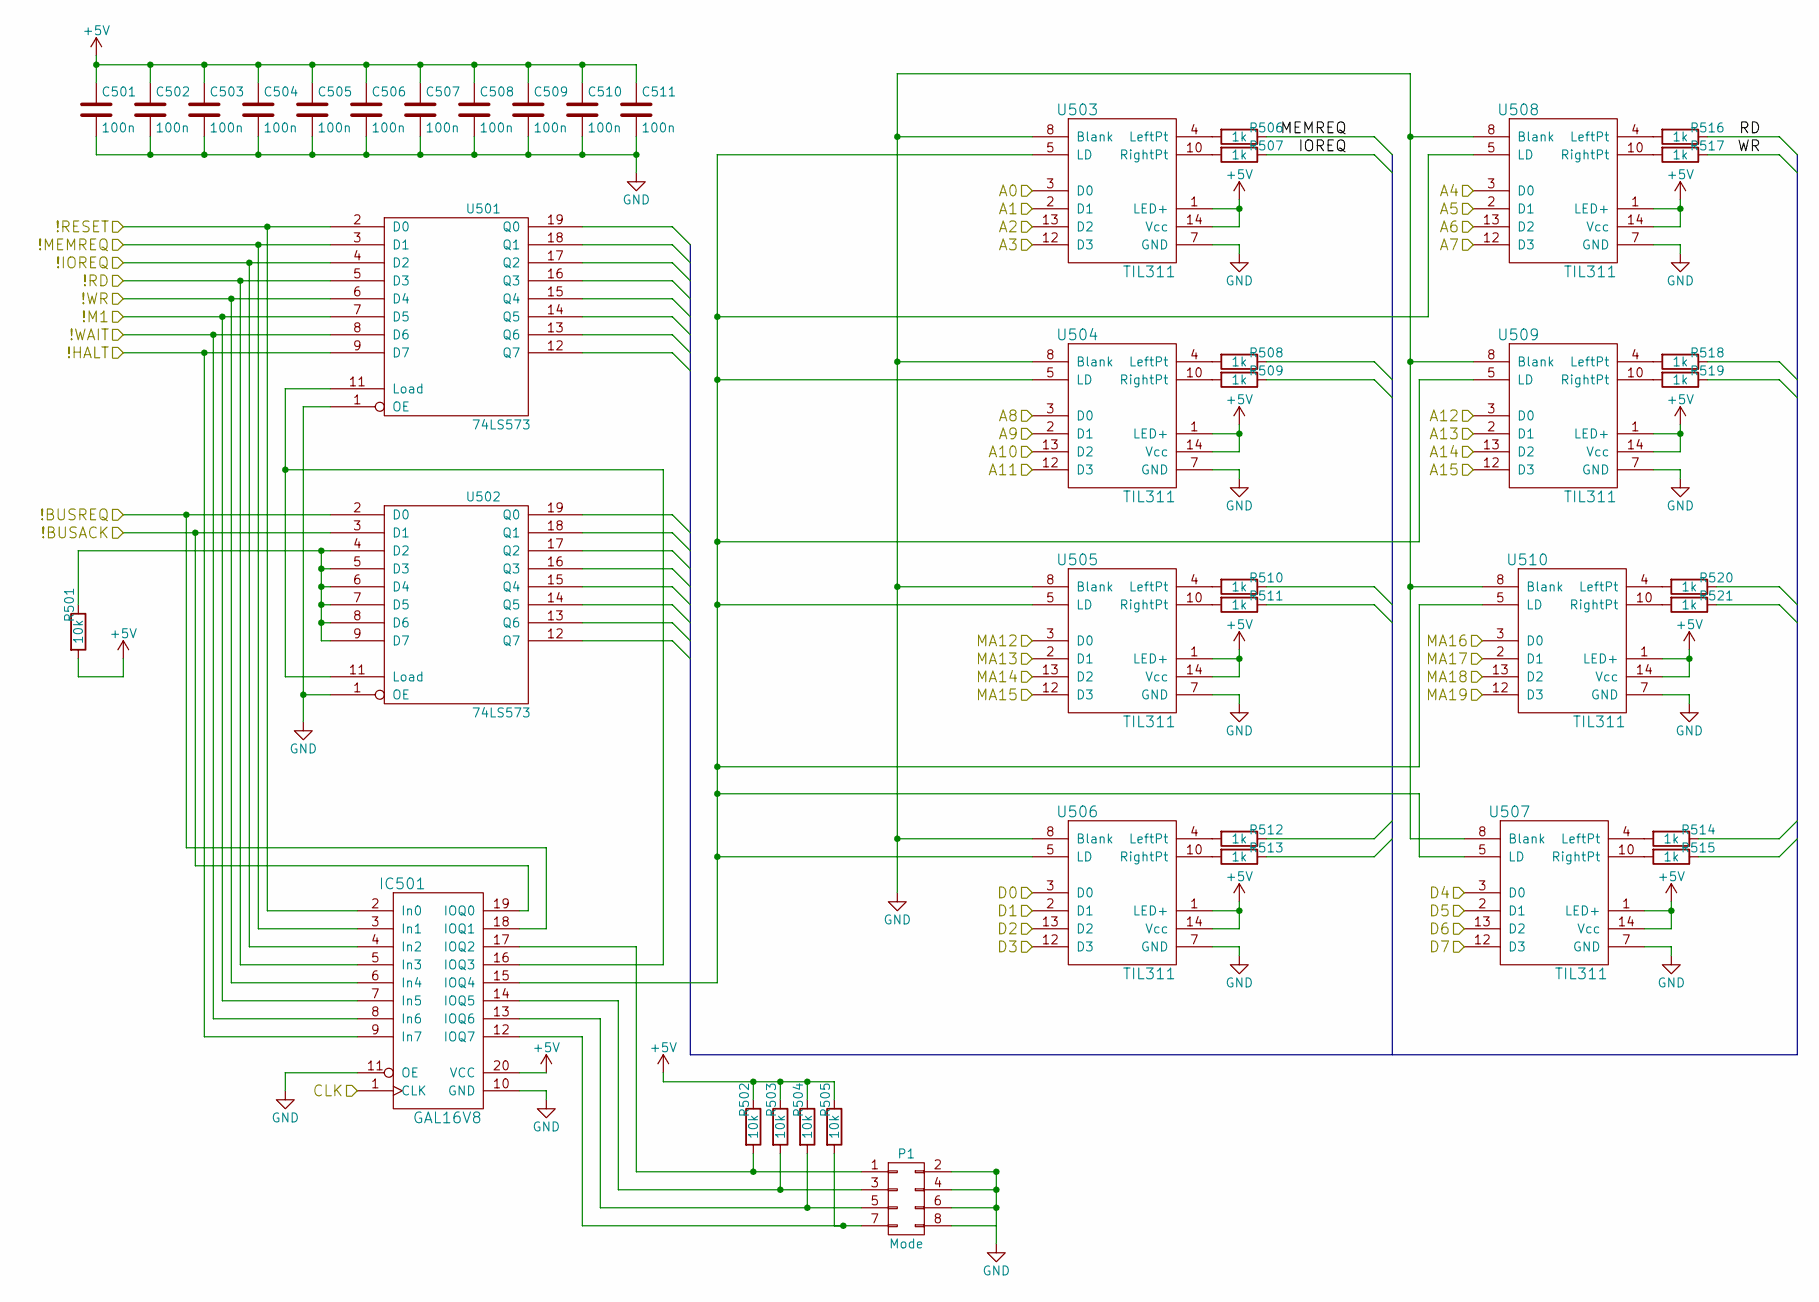
[picture p48: schematic BusSpy2.sch]

Parts:
C501, C502, C503, C504, C505, C506, C507, C508, C509, C510, C511: 100n
IC501: GAL16V8
P1: Mode
R501, R502, R503, R504, R505: 10k
R506, R507, R508, R509, R510, R511, R512, R513, R514, R515, R516, R517, R518, R519, R520, R521: 1k
U501, U502: 74LS573
U503, U504, U505, U506, U507, U508, U509, U510: TIL311

Connections:
!BUSACK: IC501.19 (IOQ0), U502.3 (D1)
!BUSREQ: IC501.18 (IOQ1), U502.2 (D0)
!HALT: IC501.9 (In7), U501.9 (D7)
!IOREQ: IC501.4 (In2), U501.4 (D2)
!M1: IC501.7 (In5), U501.7 (D5)
!MEMREQ: IC501.3 (In1), U501.3 (D1)
!RD: IC501.5 (In3), U501.5 (D3)
!RESET: IC501.2 (In0), U501.2 (D0)
!WAIT: IC501.8 (In6), U501.8 (D6)
!WR: IC501.6 (In4), U501.6 (D4)
+5V: C501.1, C502.1, C503.1, C504.1, C505.1, C506.1, C507.1, C508.1, C509.1, C510.1, C511.1, IC501.20 (VCC), R501.2, R502.1, R503.1, R504.1, R505.1, U503.1 (LED+), U503.14 (Vcc), U504.1 (LED+), U504.14 (Vcc), U505.1 (LED+), U505.14 (Vcc), U506.1 (LED+), U506.14 (Vcc), U507.1 (LED+), U507.14 (Vcc), U508.1 (LED+), U508.14 (Vcc), U509.1 (LED+), U509.14 (Vcc), U510.1 (LED+), U510.14 (Vcc)
A0: U503.3 (D0)
A1: U503.2 (D1)
A2: U503.13 (D2)
A3: U503.12 (D3)
A4: U508.3 (D0)
A5: U508.2 (D1)
A6: U508.13 (D2)
A7: U508.12 (D3)
A8: U504.3 (D0)
A9: U504.2 (D1)
A10: U504.13 (D2)
A11: U504.12 (D3)
A12: U509.3 (D0)
A13: U509.2 (D1)
A14: U509.13 (D2)
A15: U509.12 (D3)
CLK: IC501.1 (CLK)
D0: U506.3 (D0)
D1: U506.2 (D1)
D2: U506.13 (D2)
D3: U506.12 (D3)
D4: U507.3 (D0)
D5: U507.2 (D1)
D6: U507.13 (D2)
D7: U507.12 (D3)
GND: C501.2, C502.2, C503.2, C504.2, C505.2, C506.2, C507.2, C508.2, C509.2, C510.2, C511.2, IC501.10 (GND), IC501.11 (OE), P1.2, P1.4, P1.6, U501.1 (OE), U502.1 (OE), U503.7 (GND), U503.8 (Blank), U504.7 (GND), U504.8 (Blank), U505.7 (GND), U505.8 (Blank), U506.7 (GND), U506.8 (Blank), U507.7 (GND), U507.8 (Blank), U508.7 (GND), U508.8 (Blank), U509.7 (GND), U509.8 (Blank), U510.7 (GND), U510.8 (Blank)
IOREQ: R507.1
MA12: U505.3 (D0)
MA13: U505.2 (D1)
MA14: U505.13 (D2)
MA15: U505.12 (D3)
MA16: U510.3 (D0)
MA17: U510.2 (D1)
MA18: U510.13 (D2)
MA19: U510.12 (D3)
MEMREQ: R506.1
unnamed: IC501.12 (IOQ7), P1.7, R505.2
unnamed: IC501.13 (IOQ6), P1.5, R504.2
unnamed: IC501.14 (IOQ5), P1.3, R503.2
unnamed: IC501.15 (IOQ4), U503.5 (LD), U504.5 (LD), U505.5 (LD), U506.5 (LD), U507.5 (LD), U508.5 (LD), U509.5 (LD), U510.5 (LD)
unnamed: IC501.16 (IOQ3), U501.11 (Load), U502.11 (Load)
unnamed: IC501.17 (IOQ2), P1.1, R502.2
unnamed: R501.1, U502.4 (D2), U502.5 (D3), U502.6 (D4), U502.7 (D5), U502.8 (D6), U502.9 (D7)
unnamed: R506.2, U503.4 (LeftPt)
unnamed: R507.2, U503.10 (RightPt)
unnamed: R508.2, U504.4 (LeftPt)
unnamed: R509.2, U504.10 (RightPt)
unnamed: R510.2, U505.4 (LeftPt)
unnamed: R511.2, U505.10 (RightPt)
unnamed: R512.2, U506.4 (LeftPt)
unnamed: R513.2, U506.10 (RightPt)
unnamed: R514.2, U507.4 (LeftPt)
unnamed: R515.2, U507.10 (RightPt)
unnamed: R516.2, U508.4 (LeftPt)
unnamed: R517.2, U508.10 (RightPt)
unnamed: R518.2, U509.4 (LeftPt)
unnamed: R519.2, U509.10 (RightPt)
unnamed: R520.2, U510.4 (LeftPt)
unnamed: R521.2, U510.10 (RightPt)
RD: R516.1
WR: R517.1
