obiwanjacobi/Zalt/Under Construction/Interrupt v0.1/Kicad/Z80int.sch

## KiCad design Under Construction/Interrupt v0.1/Kicad/Z80int.sch (2021-01-27)

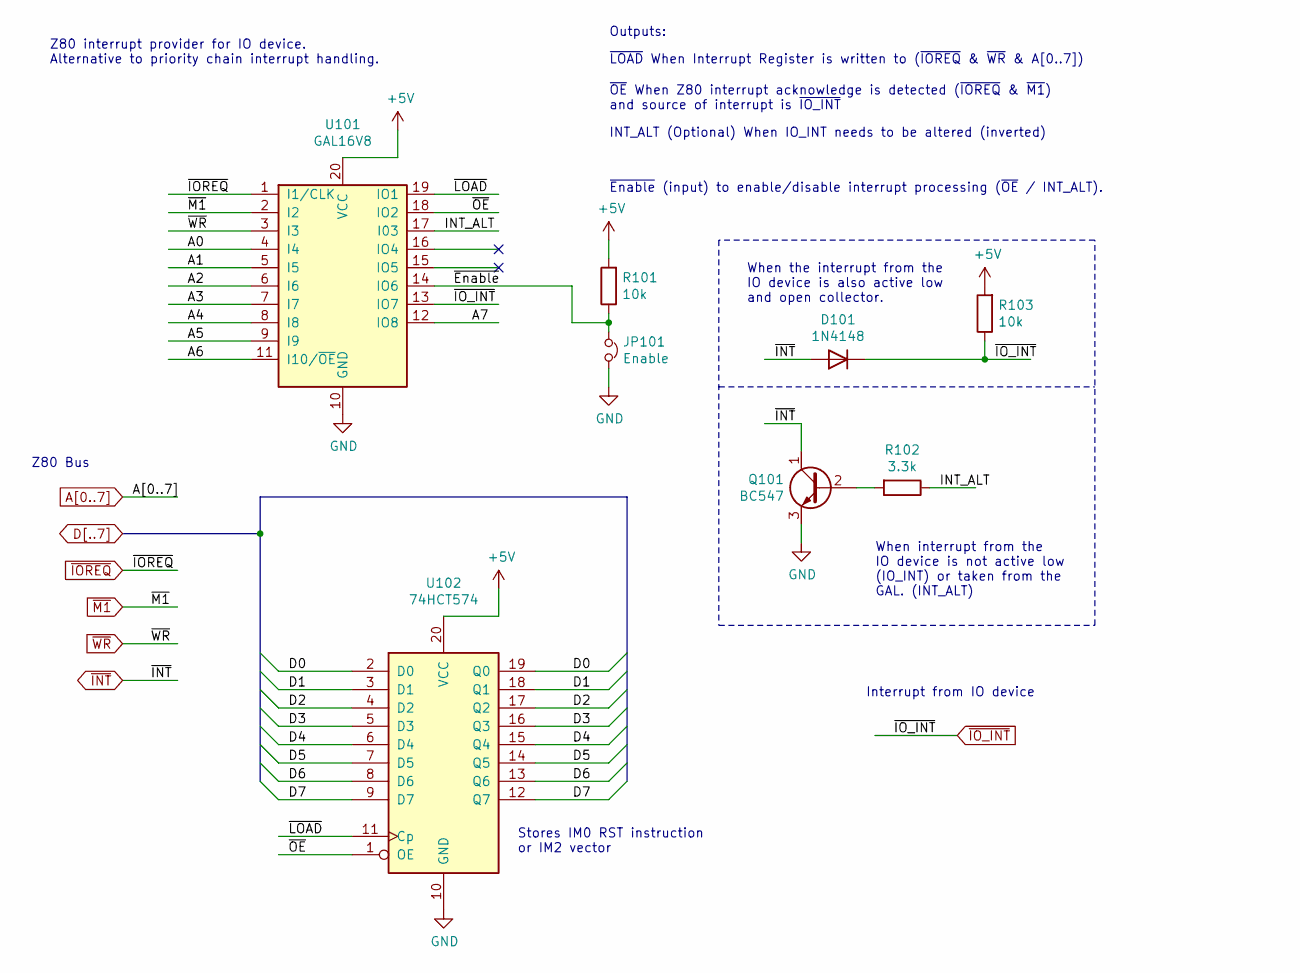
[picture p49: schematic Z80int.sch]

Parts:
D101: 1N4148; D_DO-35_SOD27_P7.62mm_Horizontal
JP101: Enable
Q101: BC547; TO-92_Inline
R101, R103: 10k
R102: 3.3k
U101: GAL16V8
U102: 74HCT574

Connections:
+5V: R101.2, R103.2, U101.20 (VCC), U102.20 (VCC)
A0: U101.4 (I4)
A1: U101.5 (I5)
A2: U101.6 (I6)
A3: U101.7 (I7)
A4: U101.8 (I8)
A5: U101.9 (I9)
A6: U101.11 (I10/~OE~)
A7: U101.12 (IO8)
D0: U102.2 (D0), U102.19 (Q0)
D1: U102.3 (D1), U102.18 (Q1)
D2: U102.4 (D2), U102.17 (Q2)
D3: U102.5 (D3), U102.16 (Q3)
D4: U102.6 (D4), U102.15 (Q4)
D5: U102.7 (D5), U102.14 (Q5)
D6: U102.8 (D6), U102.13 (Q6)
D7: U102.9 (D7), U102.12 (Q7)
GND: JP101.2, Q101.3 (E), U101.10 (GND), U102.10 (GND)
INT_ALT: R102.1, U101.17 (I03)
unnamed: Q101.2 (B), R102.2
~Enable: JP101.1, R101.1, U101.14 (IO6)
~INT: D101.2 (A), Q101.1 (C)
~IOREQ: U101.1 (I1/CLK)
~IO_INT: D101.1 (K), R103.1, U101.13 (IO7)
~LOAD: U101.19 (IO1), U102.11 (Cp)
~M1: U101.2 (I2)
~OE: U101.18 (IO2), U102.1 (OE)
~WR: U101.3 (I3)

Notes on the sheet:
Interrupt from IO device
Stores IM0 RST instruction or IM2 vector
When the interrupt from the IO device is also active low and open collector.
When interrupt from the IO device is not active low (IO_INT) or taken from the GAL. (INT_ALT)
~LOAD~ When Interrupt Register is written to (~IOREQ~ & ~WR~ & A[0..7])
~OE~ When Z80 interrupt acknowledge is detected (~IOREQ~ & ~M1~) and source of interrupt is ~IO_INT~
INT_ALT (Optional) When IO_INT needs to be altered (inverted)
~Enable~ (input) to enable/disable interrupt processing (~OE~ / INT_ALT).
Outputs:
Z80 Bus
Z80 interrupt provider for IO device. Alternative to priority chain interrupt handling.
