obiwanjacobi/Zalt/Under Construction/TTL VGA v0.2/Kicad/BusDecoder.sch

## KiCad design Under Construction/TTL VGA v0.2/Kicad/BusDecoder.sch (2020-05-11)

Schematic: BusDecoder.sch

Parts:
C9, C10, C11: C
U8: 74LS139
U15: 74LS00
U16, U18: 74LS32
U17: 74LS10

Notes on the sheet:
Z80 Bus Interface ~MEMREQ~ & ~WR~ & MA19..MA12 & !~AddressEnable~ => Write to VRAM ~IOREQ~ & ~WR~ & MA7..MA0 => Write to Control Register Control Register: A17..A12 (6 bits) Options (2 bits)
VRAM Memory Address Window is in the upper region of the 1MB address space. The last two address bits make up a selection option using the 74x139. 3F000-3FFFF 7F000-7FFFF BF000-BFFFF FF000-FFFFF A12 = 1 A13 = 1 A14 = 1 A15 = 1 A16 = 1 A17 = 1 A18 - A0-139 A19 - A1-139
~AddressEnable~ = 1 ~MEMRQ~ = 0 ~WR~ = 0
~IOREQ~ = 0 ~WR~ = 0
The IO address for the Control Register is hardwired. E0-E3 A0 = X A1 = X A2 = 0 A3 = 0 A4 = 0 A5 = 1 A6 = 1 A7 = 1
TODO: Temporary solution is to stall the CPU when it wants to write to VRAM while the GA is using it...
I dont think this is correct
