obiwanjacobi/Zalt/Under Construction/TTL VGA v0.2/Kicad/LineCounters.sch

## KiCad design Under Construction/TTL VGA v0.2/Kicad/LineCounters.sch (2020-12-11)

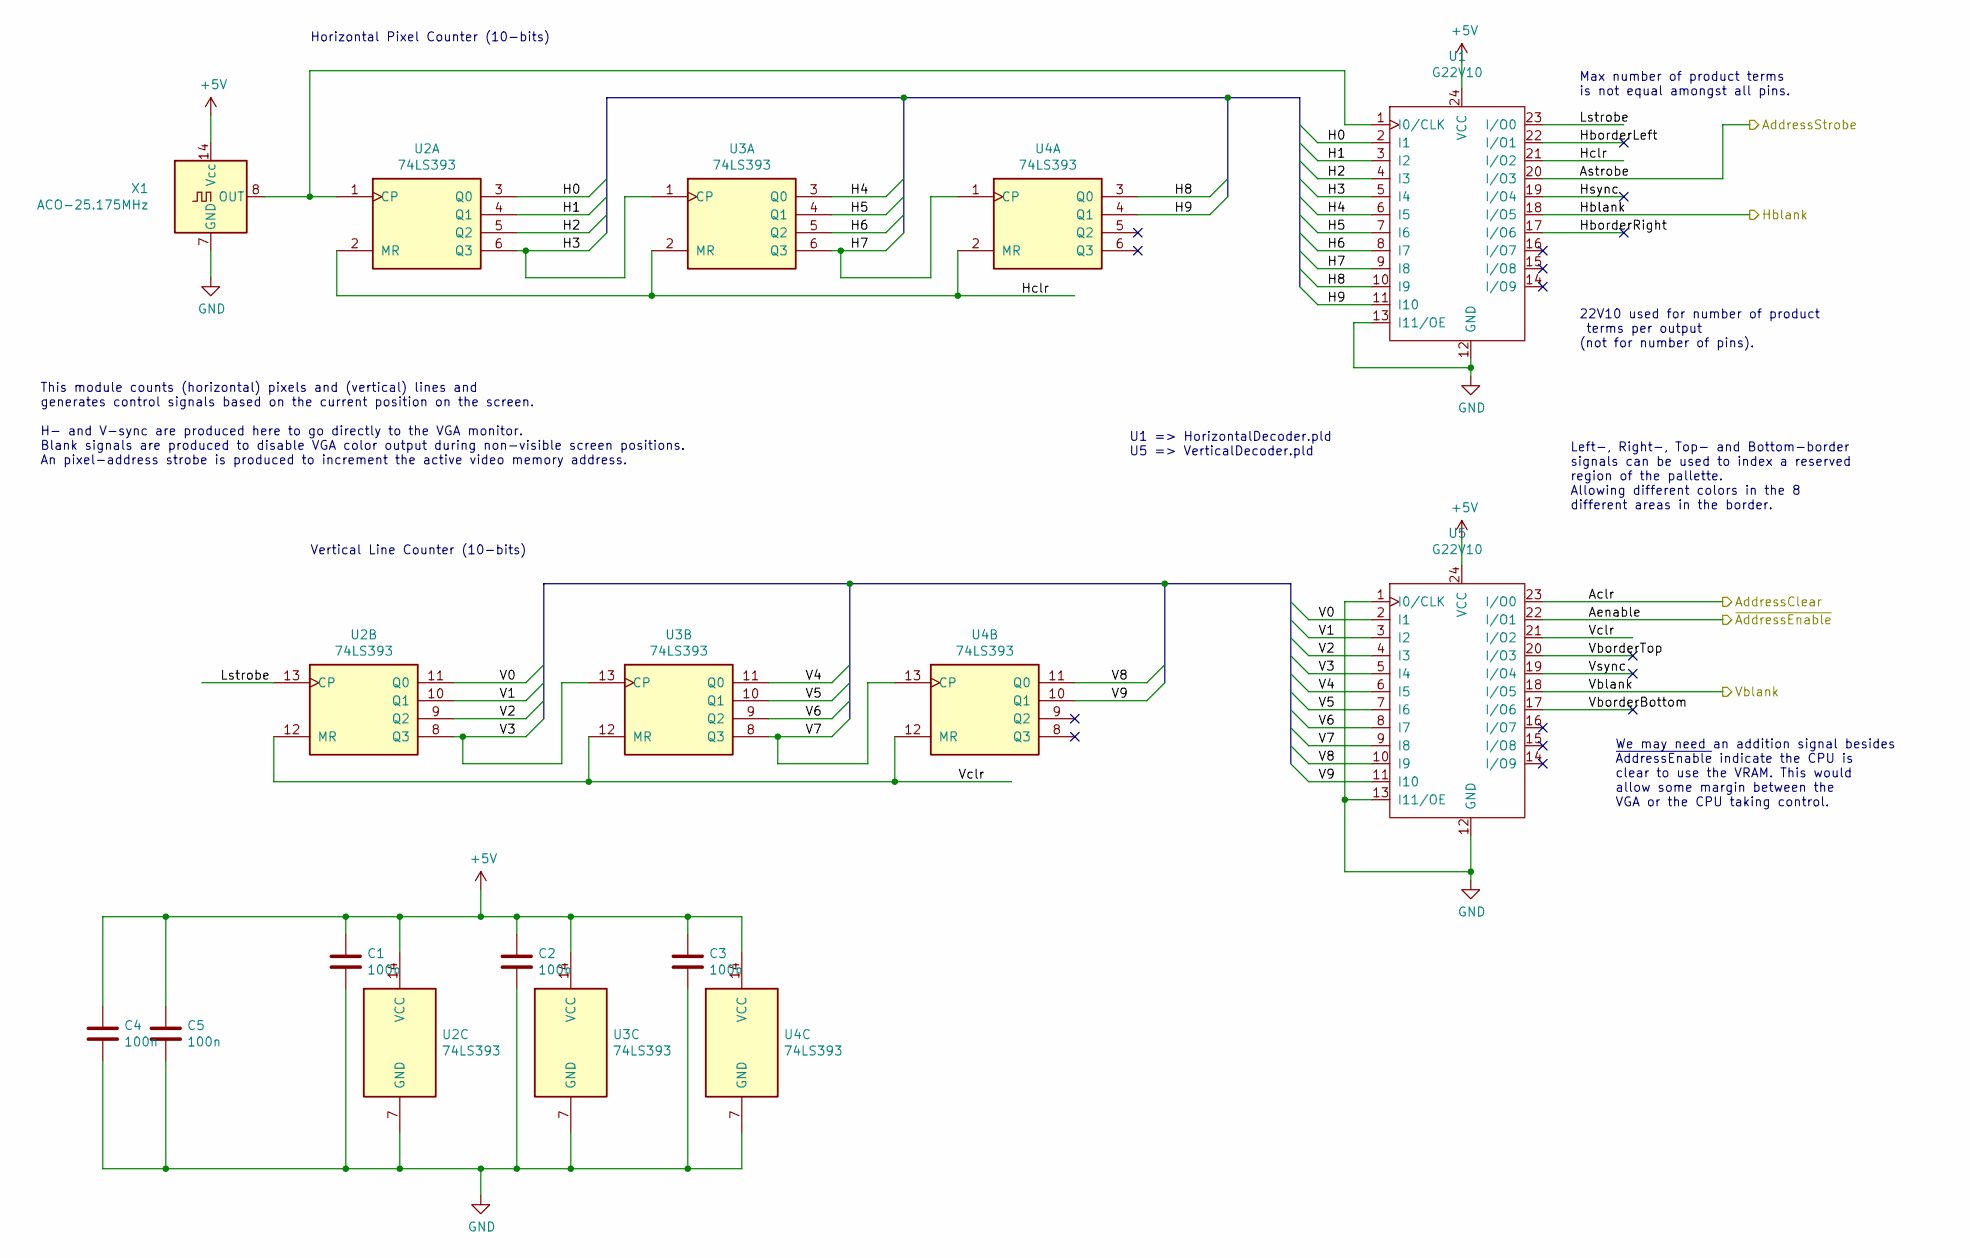
[picture p50: schematic LineCounters.sch]

Parts:
C1, C2, C3, C4, C5: 100n
U1, U5: G22V10
U2, U3, U4: 74LS393
X1: ACO-25.175MHz; Oscillator_DIP-14

Connections:
+5V: C1.1, C2.1, C3.1, C4.1, C5.1, U1.24 (VCC), U2.14 (VCC), U3.14 (VCC), U4.14 (VCC), U5.24 (VCC), X1.14 (Vcc)
Aclr: U5.23 (I/O0)
AddressStrobe: U1.20 (I/O3)
Aenable: U5.22 (I/O1)
GND: C1.2, C2.2, C3.2, C4.2, C5.2, U1.12 (GND), U1.13 (I11/OE), U2.7 (GND), U3.7 (GND), U4.7 (GND), U5.1 (I0/CLK), U5.12 (GND), U5.13 (I11/OE), X1.7 (GND)
H0: U1.2 (I1), U2.3 (Q0)
H1: U1.3 (I2), U2.4 (Q1)
H2: U1.4 (I3), U2.5 (Q2)
H3: U1.5 (I4), U2.6 (Q3), U3.1 (CP)
H4: U1.6 (I5), U3.3 (Q0)
H5: U1.7 (I6), U3.4 (Q1)
H6: U1.8 (I7), U3.5 (Q2)
H7: U1.9 (I8), U3.6 (Q3), U4.1 (CP)
H8: U1.10 (I9), U4.3 (Q0)
H9: U1.11 (I10), U4.4 (Q1)
Hblank: U1.18 (I/O5)
HborderLeft: U1.22 (I/O1)
HborderRight: U1.17 (I/O6)
Hclr: U1.21 (I/O2), U2.2 (MR), U3.2 (MR), U4.2 (MR)
Hsync: U1.19 (I/O4)
Lstrobe: U1.23 (I/O0), U2.13 (CP)
unnamed: U1.1 (I0/CLK), U2.1 (CP), X1.8 (OUT)
V0: U2.11 (Q0), U5.2 (I1)
V1: U2.10 (Q1), U5.3 (I2)
V2: U2.9 (Q2), U5.4 (I3)
V3: U2.8 (Q3), U3.13 (CP), U5.5 (I4)
V4: U3.11 (Q0), U5.6 (I5)
V5: U3.10 (Q1), U5.7 (I6)
V6: U3.9 (Q2), U5.8 (I7)
V7: U3.8 (Q3), U4.13 (CP), U5.9 (I8)
V8: U4.11 (Q0), U5.10 (I9)
V9: U4.10 (Q1), U5.11 (I10)
Vblank: U5.18 (I/O5)
VborderBottom: U5.17 (I/O6)
VborderTop: U5.20 (I/O3)
Vclr: U2.12 (MR), U3.12 (MR), U4.12 (MR), U5.21 (I/O2)
Vsync: U5.19 (I/O4)

Notes on the sheet:
22V10 used for number of product terms per output (not for number of pins).
Max number of product terms is not equal amongst all pins.
Left-, Right-, Top- and Bottom-border signals can be used to index a reserved region of the pallette. Allowing different colors in the 8 different areas in the border.
Horizontal Pixel Counter (10-bits)
Vertical Line Counter (10-bits)
U1 => HorizontalDecoder.pld U5 => VerticalDecoder.pld
We may need an addition signal besides ~AddressEnable~ indicate the CPU is clear to use the VRAM. This would allow some margin between the VGA or the CPU taking control.
This module counts (horizontal) pixels and (vertical) lines and generates control signals based on the current position on the screen. H- and V-sync are produced here to go directly to the VGA monitor. Blank signals are produced to disable VGA color output during non-visible screen positions. An pi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
