obiwanjacobi/Zalt/Under Construction/TTL VGA v0.2/Kicad/Memory.sch

## KiCad design Under Construction/TTL VGA v0.2/Kicad/Memory.sch (2020-05-11)

Schematic: Memory.sch

Parts:
C6, C7, C8, C12, C13: 100n
JP1: Jumper
R1: 10k
U6, U7: G22V10
U8: 74LS139
U9, U10: UM61512A
U11, U13, U14: 74LS245
U12: 74LS374

Notes on the sheet:
Video Memory Pixel Address Counter (18-bits)
Z80 interfaces through a 4k Memory Page. The location (bit address) of this memory page is determined by the Bus Decoder. The Control Register provides the upper 6 bits A12..A17 of the VRAM address and can only be changed through an IO write. The IO address (A0-A7) is also determined by the Bus Dec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
We could have registers here that load in a start address for each frame. That way a scrolling function can be supported in hardware. The software would load a value of the address of the start of the next frame based on the direction of scrolling. Left or right would simply increment or decrement 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
This jumper is to disable the VGA VRAM access (removed). This allows the SystemController to easily perform tests and access VRAM without synchronization.
A16 and A17 are swapped on the 74LS139. (but it is wired like this on the perf board) This will fail when using more VRAM chips. Fix by swapping outputs in U7 (WinCUPL).
U6 => BinaryCounterLo.pld U7 => BinaryCounterHi.pld
