obiwanjacobi/Zalt/Under Construction/TTL VGA v0.2/Kicad/ZaltTtlVga.sch

## KiCad design Under Construction/TTL VGA v0.2/Kicad/ZaltTtlVga.sch (2020-12-11)

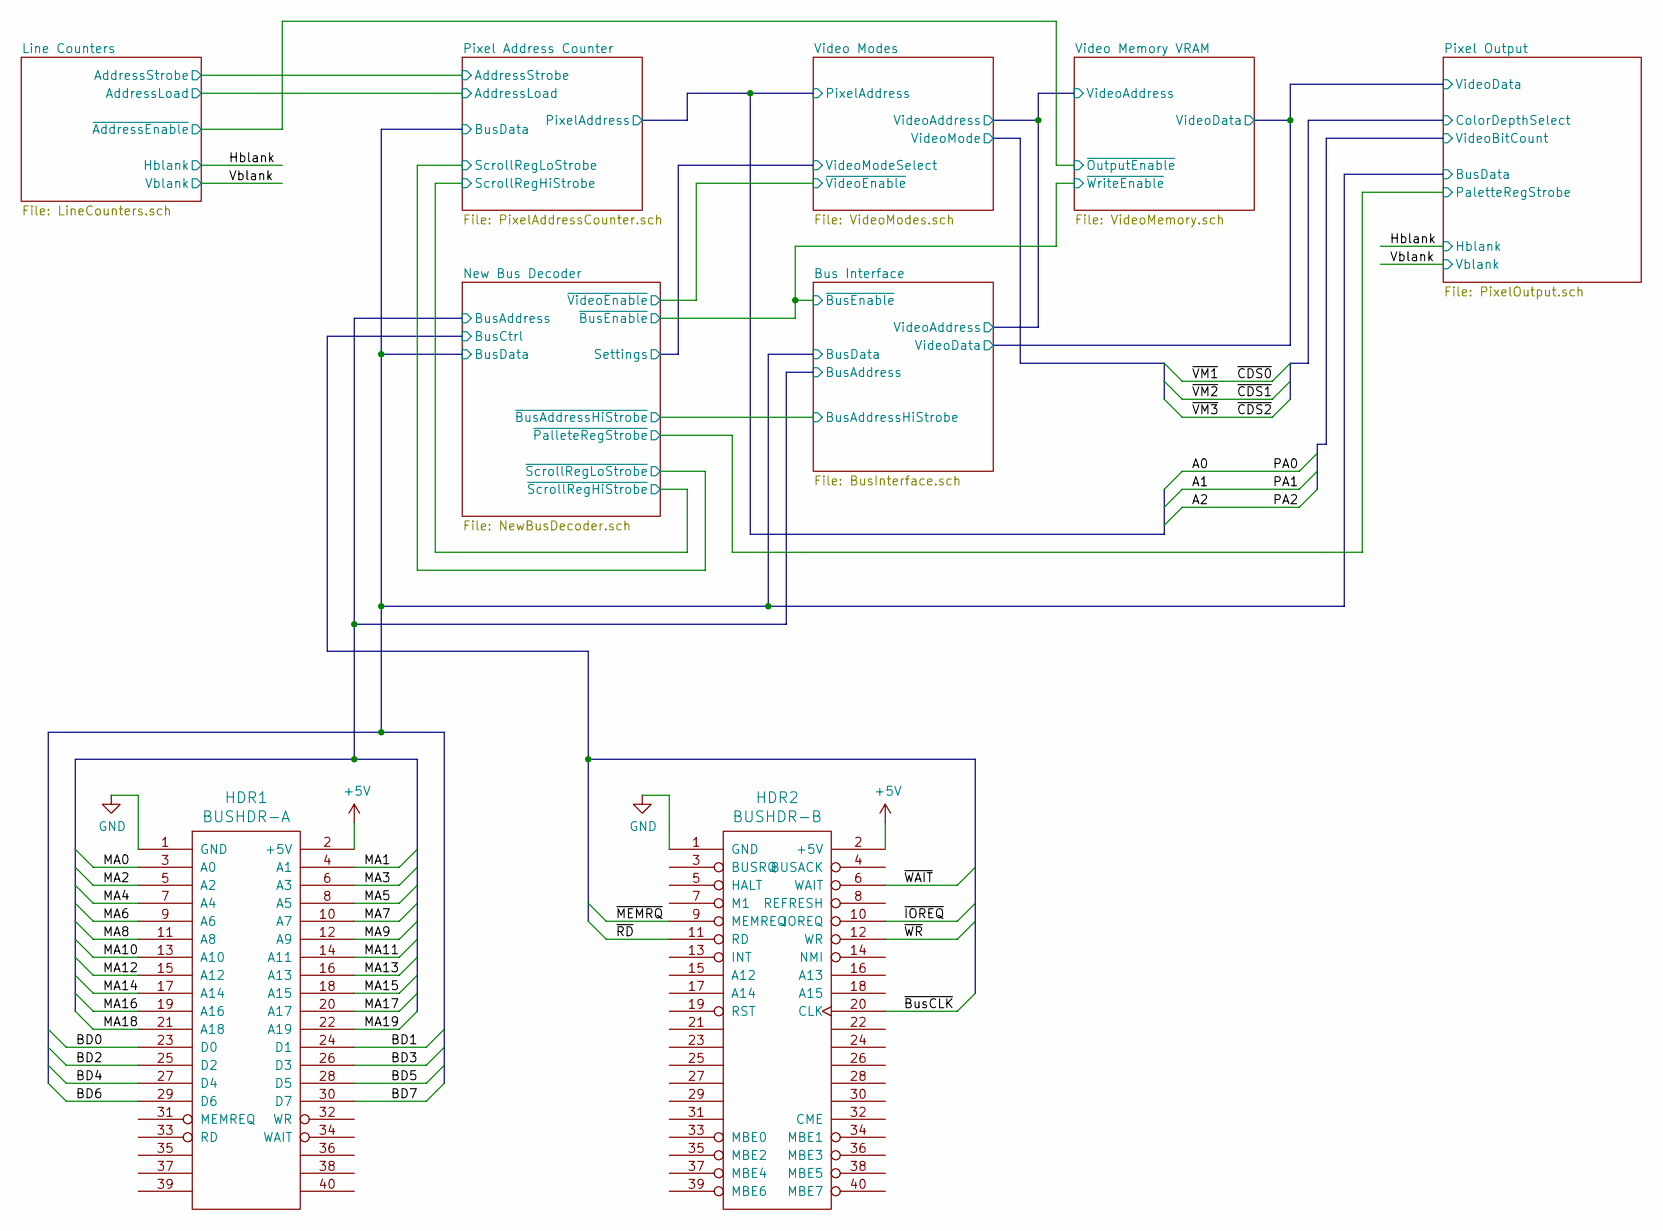
[picture p51: schematic ZaltTtlVga.sch]

Parts:
HDR1: BUSHDR-A
HDR2: BUSHDR-B

Connections:
+5V: HDR1.2 (+5V), HDR2.2 (+5V)
BD0: HDR1.23 (D0)
BD1: HDR1.24 (D1)
BD2: HDR1.25 (D2)
BD3: HDR1.26 (D3)
BD4: HDR1.27 (D4)
BD5: HDR1.28 (D5)
BD6: HDR1.29 (D6)
BD7: HDR1.30 (D7)
GND: HDR1.1 (GND), HDR2.1 (GND)
MA0: HDR1.3 (A0)
MA1: HDR1.4 (A1)
MA2: HDR1.5 (A2)
MA3: HDR1.6 (A3)
MA4: HDR1.7 (A4)
MA5: HDR1.8 (A5)
MA6: HDR1.9 (A6)
MA7: HDR1.10 (A7)
MA8: HDR1.11 (A8)
MA9: HDR1.12 (A9)
MA10: HDR1.13 (A10)
MA11: HDR1.14 (A11)
MA12: HDR1.15 (A12)
MA13: HDR1.16 (A13)
MA14: HDR1.17 (A14)
MA15: HDR1.18 (A15)
MA16: HDR1.19 (A16)
MA17: HDR1.20 (A17)
MA18: HDR1.21 (A18)
MA19: HDR1.22 (A19)
~BusCLK: HDR2.20 (CLK)
~IOREQ: HDR2.10 (IOREQ)
~MEMRQ: HDR2.9 (MEMREQ)
~RD: HDR2.11 (RD)
~WAIT: HDR2.6 (WAIT)
~WR: HDR2.12 (WR)
