obiwanjacobi/Zalt/Source/SystemController/SystemController.cydsn/MemoryCommands.c

#include "MemoryCommands.h"
#include "BusController.h"
#include "MemoryController.h"

#include <stdlib.h>

typedef struct  // extended Memory struct
{
    // Memory
    uint16_t Address;
    uint8_t* Buffer;
    uint16_t Length;
    // extension
    uint16_t SpinCountTimeout;
    
} WriteMemory;

//
// DMA Commands
//

uint16_t DmaParseCommandParameters(RingBuffer* buffer, TerminalCommand* command)
{
    uint16_t bytesRead = 0;
    command->Address = 0;
    command->Length = 0;
    command->Param3 = 0;
    
    if (!RingBuffer_IsEmpty(buffer))
    {
        char* endPtr = NULL;
        uint8_t temp[10];
    
        bytesRead += CommandParser_Read(buffer, temp, 9);
        command->Address = strtoul((const char*)temp, &endPtr, 16);
        
        if (!RingBuffer_IsEmpty(buffer))
        {
            bytesRead += CommandParser_Read(buffer, temp, 9);
            command->Length = strtoul((const char*)temp, &endPtr, 16);
            
            if (!RingBuffer_IsEmpty(buffer))
            {
                bytesRead += CommandParser_Read(buffer, temp, 9);
                command->Param3 = strtoul((const char*)temp, &endPtr, 16);
            }
        }
    }
        
    return bytesRead;
}


uint8_t MemoryWrite_WriteByte(void* ctx, uint8_t data)
{
    WriteMemory* mem = (WriteMemory*)ctx;
    
    if (mem->Length == 0 && mem->SpinCountTimeout != 0)
    {
        MemoryController_WriteByte((Memory*)mem, data);
        mem->Length = 0;
        return 1;
    }
    else
    {
        MemoryController_WriteByte((Memory*)mem, data);
    
        return mem->Length > 0;
    }
}

uint16_t MemoryRead_CopyToTerminal(uint16_t address, uint16_t length, const char* format)
{
    const uint16_t BufferSize = 0x100;
    uint8_t buffer[BufferSize];
    uint16_t l;
    uint16_t bytesRead = 0;
    Memory mem;
    mem.Buffer = buffer;
    
    while(length > 0)
    {
        l = length > BufferSize ? BufferSize : length;
                
        mem.Address = address + bytesRead;
        mem.Length = l;
        
        MemoryController_Read(&mem);
        if (format == NULL)
        {
            SysTerminal_PutArray(mem.Buffer, mem.Length);
        }
        else
        {
            SerialTerminal_WriteArrayFormat(format, mem.Buffer, mem.Length, mem.Address);
        }
        
        length -= l;
        bytesRead += l;
    }
    
    return bytesRead;
}

//
// Memory Write
//
// => 'mw' <Address> <Length>
// <= "<ACK>"
// => blob
// <= bytes
uint16_t MemoryWrite_Execute(SerialTerminal* serialTerminal, TerminalCommand* command)
{
    WriteMemory mem;
    mem.Address = command->Address;
    mem.Buffer = NULL;
    mem.Length = command->Length;
    mem.SpinCountTimeout = mem.Length == 0 ? 0x2FF : 0;
    
    BusState busState;
    if (!BusController_Open(&busState))
    {
        SerialTerminal_WriteLine("Memory Write Command failed to execute.");
        return 0;
    }
    
    // signal ready to receive file
    if (mem.Length == 0)
    {
        SerialTerminal_WriteLine("Send bin file...");
    }
    else
    {
        SerialTerminal_Write("Send bin file of ");
        SerialTerminal_WriteUint16(mem.Length, 16);
        SerialTerminal_WriteLine("h bytes...");
    }    

    uint16_t bytesRead = 0;
    BusController_EnableDataBusOutput(true);
    
    // block until all bytes have been read
    while(mem.Length > 0 || mem.SpinCountTimeout > 0)
    {
        bytesRead += SerialTerminal_ReceiveBlob(&mem, MemoryWrite_WriteByte);
        
        if (bytesRead > 0 && mem.Length == 0 && mem.SpinCountTimeout > 0)
        {
            CyDelay(5);
            mem.SpinCountTimeout--;
        }
    }
    
    BusController_EnableDataBusOutput(false);
    BusController_Close(&busState);
    
    SerialTerminal_Write("Received ");
    SerialTerminal_WriteUint16(bytesRead, 16);
    SerialTerminal_Write("h bytes written to address ");
    SerialTerminal_WriteUint16(command->Address, 16);
    SerialTerminal_WriteLine("h");
    
    return 0;
}

//
// Memory Read
//
// => 'mr' <Address> <Length>
// <= blob
uint16_t MemoryRead_Execute(SerialTerminal* serialTerminal, TerminalCommand* command)
{
    // some default for no length specified
    if (command->Length == 0)
    {
        command->Length = 0xFF;
    }
        
    BusState busState;
    if (!BusController_Open(&busState))
    {
        SerialTerminal_WriteLine("Memory Read Command failed to execute.");
        return 0;
    }
    
    SerialTerminal_Write("Reading ");
    SerialTerminal_WriteUint16(command->Length, 16);
    SerialTerminal_Write("h bytes from address ");
    SerialTerminal_WriteUint16(command->Address, 16);
    SerialTerminal_WriteLine(":");
    
    MemoryRead_CopyToTerminal(command->Address, command->Length, NULL);
    
    BusController_Close(&busState);
    
    SerialTerminal_WriteLine(NULL);
    SerialTerminal_WriteLine(OK);
    
    return 0;
}

//
// Memory Dump
//
// => 'md' <Address> <Length>
// <= hex dump

uint16_t MemoryDump_Execute(SerialTerminal* serialTerminal, TerminalCommand* command)
{
    // some default for no length specified
    if (command->Length == 0)
    {
        command->Length = 0x100;
    }
    
    BusState busState;
    if (!BusController_Open(&busState))
    {
        SerialTerminal_WriteLine("Memory Dump Command failed to execute.");
        return 0;
    }
    
    MemoryRead_CopyToTerminal(command->Address, command->Length, "%02X");
    
    BusController_Close(&busState);
    
    SerialTerminal_WriteLine(OK);
    return 0;
}

//
// Memory Fill
//
// => 'mf' <Address> <Length> <char>
uint16_t MemoryFill_Execute(SerialTerminal* serialTerminal, TerminalCommand* command)
{
    uint16_t bytesRead = 0;
    Memory mem;
    mem.Address = command->Address;
    mem.Buffer = NULL;
    mem.Length = command->Length == 0 ? 0xFFFF - command->Address : command->Length;
    
    BusState busState;
    if (!BusController_Open(&busState))
    {
        SerialTerminal_WriteLine("Memory Fill Command failed to execute.");
        return 0;
    }
    
    SerialTerminal_Write("Filling ");
    SerialTerminal_WriteUint16(mem.Length, 16);
    SerialTerminal_Write("h bytes from address ");
    SerialTerminal_WriteUint16(command->Address, 16);
    SerialTerminal_Write(" with value ");
    SerialTerminal_WriteUint16(command->Param3, 16);
    SerialTerminal_WriteLine("h");
        
    BusController_EnableDataBusOutput(true);
    
    while(mem.Length > 0)
    {
        MemoryController_WriteByte(&mem, command->Param3);
    }
    
    BusController_EnableDataBusOutput(false);
    BusController_Close(&busState);
    
    SerialTerminal_WriteLine(OK);
    
    return bytesRead;
}

//
// Memory Test
//
// => 'mt' <Address> <Length>
uint16_t MemoryTest_Execute(SerialTerminal* serialTerminal, TerminalCommand* command)
{
    TestMemory mem;
    mem.Address = command->Address;
    mem.Length = command->Length == 0 ? 0xFFFF - command->Address : command->Length;
    TestMemoryResult result;
    
    BusState busState;
    if (!BusController_Open(&busState))
    {
        SerialTerminal_WriteLine("Memory Test Command failed to execute.");
        return 0;
    }
    
    SerialTerminal_Write("Testing ");
    SerialTerminal_WriteUint16(mem.Length, 16);
    SerialTerminal_Write("h bytes from address ");
    SerialTerminal_WriteUint16(command->Address, 16);
    SerialTerminal_WriteLine("h");
        
    MemoryController_TestMemory(&mem, &result);   
    BusController_Close(&busState);
    
    if (mem.Length > 0)
    {
        SerialTerminal_Write("Memory Test failed for ");
        SerialTerminal_WriteUint16(result.Expected, 16);
        SerialTerminal_Write("h with ");
        SerialTerminal_WriteUint16(result.Actual, 16);
        SerialTerminal_Write("h at address ");
        SerialTerminal_WriteUint16(mem.Address, 16);
        SerialTerminal_WriteLine("h");
    }
    else
    {
        SerialTerminal_WriteLine(OK);
    }
    
    return 0;
}
/* [] END OF FILE */
