obiwanjacobi/Zalt/Source/z88dk_target/_tests.unit/minunit.h

/*
 * File:   minunit.h
 * Author: Zed. A. Shaw, Sam
 *
 * @see http://c.learncodethehardway.org/book/ex30.html
 *
 * Created on 27 August 2014, 22:14
 *
 * Modified by obiwanjacobi *
 */

#ifndef MINUNIT_H
#define MINUNIT_H

#ifdef __cplusplus
extern "C"
{
#endif

#include <stdio.h>
#include <stdlib.h>

#define log_err(message) printf("\tError: %s\n", message)

#define mu_assert(test, message) \
    do                           \
    {                            \
        if (!(test))             \
        {                        \
            log_err(message);    \
            return message;      \
        }                        \
    } while (0)

#define mu_run_test(test)               \
    do                                  \
    {                                   \
        const char *message;            \
        printf("\n-----%s", " " #test); \
        message = test();               \
        tests_run++;                    \
        if (message)                    \
        {                               \
            return message;             \
        }                               \
    } while (0)

#define mu_run_test_suite(testsuite)         \
    do                                       \
    {                                        \
        const char *message;                 \
        printf("\n===%s\t", " " #testsuite); \
        message = testsuite();               \
        if (message)                         \
        {                                    \
            return message;                  \
        }                                    \
    } while (0)

#define RUN_TESTS(name)                                                 \
    int main(int argc, char *argv[])                                    \
    {                                                                   \
        tests_run = 0;                                                  \
        printf("\n\nRUNNING: %s\n", argv[0]);                           \
        const char *result = name();                                    \
        if (result != 0)                                                \
        {                                                               \
            printf("\n\n>> TEST %d FAILED: %s\n\n", tests_run, result); \
        }                                                               \
        else                                                            \
        {                                                               \
            printf("\n\n>> ALL %d TESTS PASSED\n\n", tests_run);        \
        }                                                               \
        exit(result == 0 ? EXIT_SUCCESS : EXIT_FAILURE);                \
    }

    extern int tests_run;

#ifdef __cplusplus
}
#endif

#endif /* MINUNIT_H */
