obiwanjacobi/Zalt/(commit log)

2016-10-12 Initial publication of Zalt Z80 computer source files.
    [BusSpy.sch, BusSpy2.sch, CPUandMemory.sch, Decoder Board.kicad_pcb, Decoder Board.sch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]
2016-10-21 Added schematics as pdf for general viewing.
2017-01-04 Started with Z80 zalt system code and added Z80 interrupt handling to PSoC.
2017-01-06 Added debugger and breakpoint functionality.
    [z88dk.cfg]
2017-01-08 Interrupts (keyboard) are starting to work.
2017-02-18 Zalt Virtual Devices and start of GPU design,
    [GPU Board v1.0.kicad_pcb, GPU Board v1.0.sch]
2018-01-14 Resurrected custom part libs from .bak files and relinked them in the schematic.
    [GPU Board v1.0.sch]
2018-02-03 Restored Kicad library files that were missing.
2018-12-19 string tests and fixes
    [Heap.c]
2018-12-22 preprocessing m4 files
    [Async.obj, ConsoleStreamProvider.obj, Error.obj, Heap.obj, Stream.obj, StreamReader.obj, StreamWriter.obj, String.obj]
2018-12-23 bin files cleanup
    [Async.obj, ConsoleStreamProvider.obj, Error.obj, Heap.obj, Stream.obj, StreamReader.obj, StreamWriter.obj, String.obj]
2018-12-24 virtual devices compiles
2018-12-29 MMU pop and fix
    [MemoryManager.c]
2019-01-06 memmgr u101 latch timing issue
    [Decoder Board.sch]
2019-05-03 Kicad libs
2019-05-03 Zalt to ISA
    [ZaltToISA.kicad_pcb, ZaltToISA.sch]
2019-10-23 update (images)
    [GPU Board v1.0-2019-06-29-08-56-48.sch, GPU Board v1.0.sch, Z80 CPU Board-2019-07-12-14-02-26.sch, Z80 CPU Board.sch, ZaltToISA-2019-06-21-10-43-43.sch, ZaltToISA.sch]
2020-01-30 wait for busack and pin macro
2020-02-11 TTL VGA
    [ZaltTtlVga.kicad_pcb, ZaltTtlVga.sch]
2020-02-12 more sheets in schematic
    [LineCounters.sch, Memory.sch, ZaltTtlVga.sch]
2020-02-14 binary counter cupl
    [Memory.sch]
2020-02-23 updates to 'working' version
    [_saved_Memory.sch]
2020-03-08 vga memory interface
    [BusDecoder.sch, LineCounters.sch, Memory.sch, PixelOutput.sch, ZaltTtlVga.sch, _saved_Memory.sch]
2020-03-21 vga test code
    [BusDecoder.sch]
2020-05-02 vga work
    [Memory.sch]
2020-05-03 More VGA work
    [BusDecoder.sch, Memory.sch]
2020-05-11 TTL VGA v0.2
    [BusDecoder.sch, BusInterface.sch, LineCounters.sch, Memory.sch, NewBusDecoder.sch, PixelAddressCounter.sch, PixelOutput.sch, VideoAddressCounter.sch]
2020-05-12 video bit mux
    [PixelOutput.sch, ZaltTtlVga.sch]
2020-12-06 update kicad
    [BusDecoder.sch, LineCounters.sch, Memory.sch, NewBusDecoder.sch, PixelOutput.sch, VideoModes.sch, ZaltTtlVga.sch, rtl.psm]
2020-12-26 VDP in production
    [SoundGen.sch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]
2021-01-17 Ide working prototype
    [IDE16 Interface.sch]
2021-01-27 Ide prototype
    [IDE16 Interface.sch, VDP-Composite.sch, Z80int.kicad_pcb, Z80int.sch]
2021-02-07 atmega ide controller
    [IDEInterface.sch, IDE_DMA - ATmega8515.sch, IDE_DMA.kicad_pcb, IDE_DMA.sch, Z80 CPU Board.sch]
