obiwanjacobi/Zalt/Design/Images/ZaltVgaInterface2.jpg

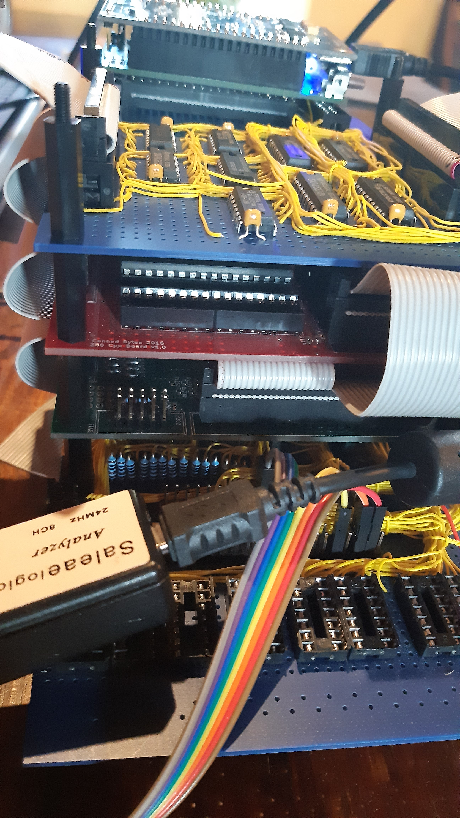
Design/Images/ZaltVgaInterface2.jpg
